wprod/fab-diy/cad/steel/preview.png

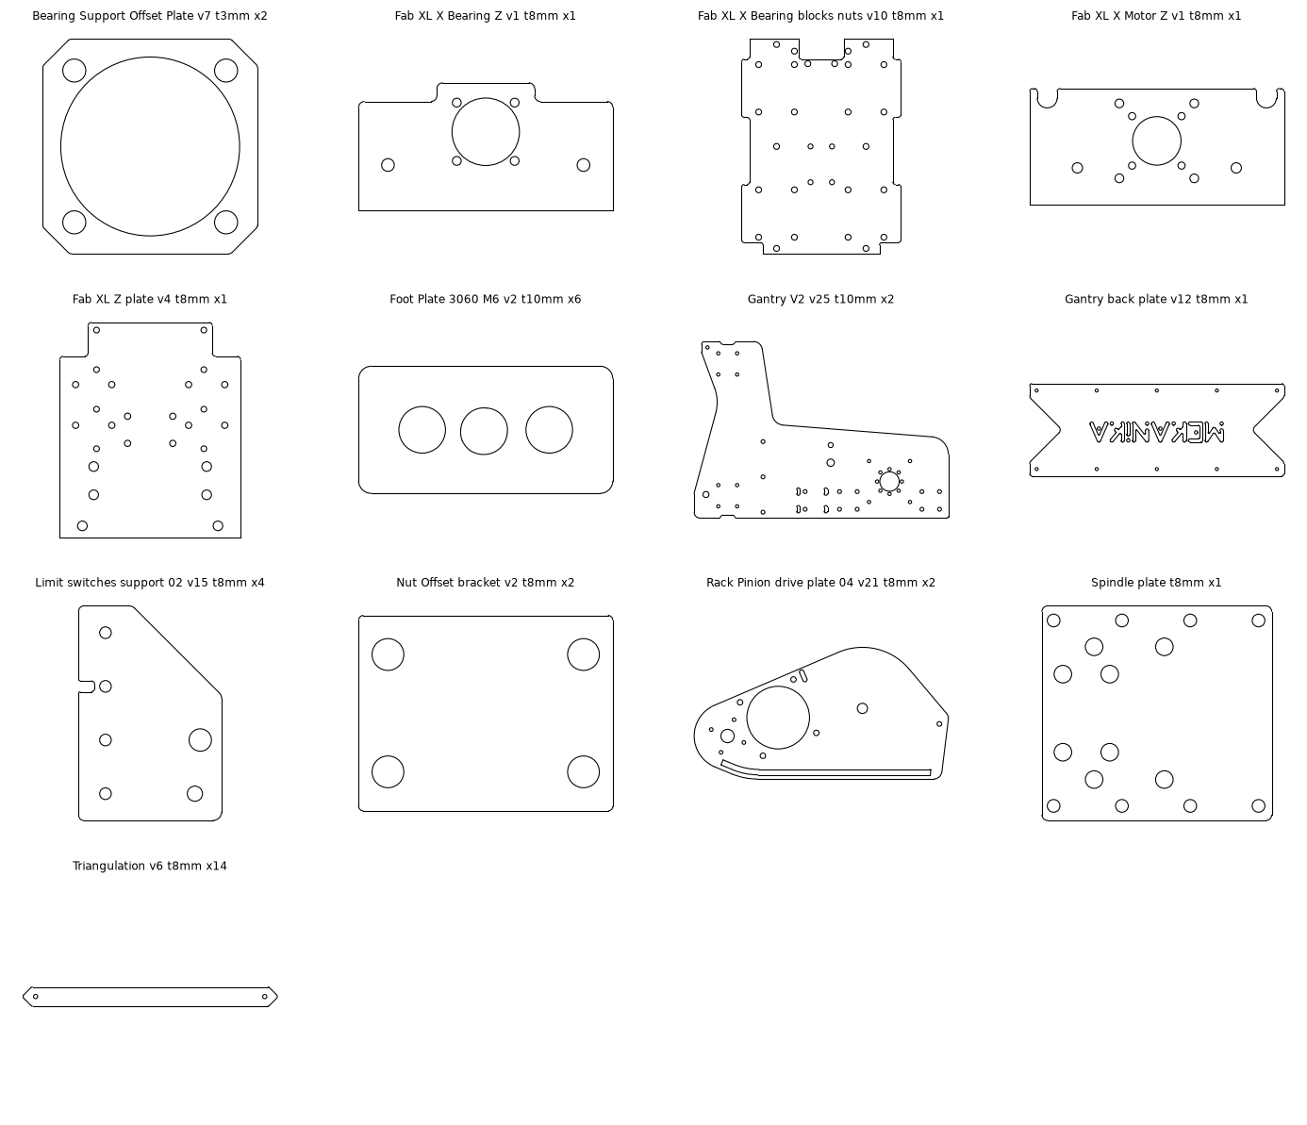
cad/steel/preview.png
