wprod/fab-diy/bom/commandes/README.md

# Listes de commande par fournisseur

Générées par `scripts/make_orders.py` à partir de [`fab-diy-bom.csv`](../fab-diy-bom.csv). Prix TTC France, port compris quand il est chiffré.

| Fournisseur | Articles | Total TTC | dont estimé | Liste |
|---|---:|---:|---:|---|
| Dold Mechatronik (aluprofile-express.de) | 14 | 1693 € | 109 € | [`dold-mechatronik-aluprofile-express-de.csv`](dold-mechatronik-aluprofile-express-de.csv) |
| DamenCNC (2 × 2 m) + Dold (2 × 1 m) | 1 | 1277 € | 0 € | [`damencnc-2-2-m-dold-2-1-m.csv`](damencnc-2-2-m-dold-2-1-m.csv) |
| Sorotec (Blue Line) | 6 | 857 € | 0 € | [`sorotec-blue-line.csv`](sorotec-blue-line.csv) |
| Découpe laser en ligne (Laserboost / Fractory / Xometry) - devis à faire | 16 | 562 € | 562 € | [`decoupe-laser-en-ligne-laserboost-fractory-xometry-devis-a-f.csv`](decoupe-laser-en-ligne-laserboost-fractory-xometry-devis-a-f.csv) |
| StepperOnline (entrepôt DE) | 4 | 452 € | 100 € | [`stepperonline-entrepot-de.csv`](stepperonline-entrepot-de.csv) |
| AliExpress | 22 | 275 € | 275 € | [`aliexpress.csv`](aliexpress.csv) |
| PlanetCNC (planet-cnc.com) | 3 | 240 € | 15 € | [`planetcnc-planet-cnc-com.csv`](planetcnc-planet-cnc-com.csv) |
| Reichelt (reichelt.com/be) | 30 | 181 € | 115 € | [`reichelt-reichelt-com-be.csv`](reichelt-reichelt-com-be.csv) |
| Dold Mechatronik | 8 | 162 € | 25 € | [`dold-mechatronik.csv`](dold-mechatronik.csv) |
| TME (tme.eu/fr, Pologne, UE) | 17 | 156 € | 45 € | [`tme-tme-eu-fr-pologne-ue.csv`](tme-tme-eu-fr-pologne-ue.csv) |
| Motedis (motedis.fr) | 27 | 155 € | 17 € | [`motedis-motedis-fr.csv`](motedis-motedis-fr.csv) |
| Achat local (bricolage / grossiste électrique) | 6 | 146 € | 146 € | [`achat-local-bricolage-grossiste-electrique.csv`](achat-local-bricolage-grossiste-electrique.csv) |
| Reichelt / RS / Conrad | 5 | 143 € | 143 € | [`reichelt-rs-conrad.csv`](reichelt-rs-conrad.csv) |
| Dold Mechatronik (pignon) + AliExpress (poulie) + atelier d'usinage local | 1 | 138 € | 138 € | [`dold-mechatronik-pignon-aliexpress-poulie-atelier-d-usinage-.csv`](dold-mechatronik-pignon-aliexpress-poulie-atelier-d-usinage-.csv) |
| AliExpress (vendeur entrepôt UE si dispo) | 8 | 127 € | 127 € | [`aliexpress-vendeur-entrepot-ue-si-dispo.csv`](aliexpress-vendeur-entrepot-ue-si-dispo.csv) |
| DamenCNC (Pays-Bas) | 1 | 126 € | 126 € | [`damencnc-pays-bas.csv`](damencnc-pays-bas.csv) |
| Motedis | 4 | 100 € | 0 € | [`motedis.csv`](motedis.csv) |
| Leroy Merlin (retrait en magasin) | 1 | 100 € | 100 € | [`leroy-merlin-retrait-en-magasin.csv`](leroy-merlin-retrait-en-magasin.csv) |
| Dold Mechatronik + atelier local | 1 | 59 € | 59 € | [`dold-mechatronik-atelier-local.csv`](dold-mechatronik-atelier-local.csv) |
| Audiophonics (Bordeaux) | 2 | 47 € | 7 € | [`audiophonics-bordeaux.csv`](audiophonics-bordeaux.csv) |
| Quincaillerie / négoce (Rampa SKD acier ou équivalent) | 1 | 35 € | 35 € | [`quincaillerie-negoce-rampa-skd-acier-ou-equivalent.csv`](quincaillerie-negoce-rampa-skd-acier-ou-equivalent.csv) |
| Sorotec | 1 | 30 € | 0 € | [`sorotec.csv`](sorotec.csv) |
| AliExpress / Amazon | 2 | 30 € | 30 € | [`aliexpress-amazon.csv`](aliexpress-amazon.csv) |
| Découpe laser (avec le lot acier) | 1 | 24 € | 24 € | [`decoupe-laser-avec-le-lot-acier.csv`](decoupe-laser-avec-le-lot-acier.csv) |
| Bits and Parts (bitsandparts.nl) | 2 | 19 € | 8 € | [`bits-and-parts-bitsandparts-nl.csv`](bits-and-parts-bitsandparts-nl.csv) |
| Reichelt / Conrad | 3 | 17 € | 17 € | [`reichelt-conrad.csv`](reichelt-conrad.csv) |
| Découpe laser bois/acrylique en ligne (Snijlab NL / Formulor DE) | 2 | 14 € | 14 € | [`decoupe-laser-bois-acrylique-en-ligne-snijlab-nl-formulor-de.csv`](decoupe-laser-bois-acrylique-en-ligne-snijlab-nl-formulor-de.csv) |
| Reichelt (reichelt.com/fr) | 1 | 12 € | 12 € | [`reichelt-reichelt-com-fr.csv`](reichelt-reichelt-com-fr.csv) |
| Amazon.fr (optionnel, décoratif) | 5 | 11 € | 11 € | [`amazon-fr-optionnel-decoratif.csv`](amazon-fr-optionnel-decoratif.csv) |
| JLCPCB | 2 | 10 € | 10 € | [`jlcpcb.csv`](jlcpcb.csv) |
| Reichelt / Kubii | 1 | 6 € | 6 € | [`reichelt-kubii.csv`](reichelt-kubii.csv) |
| Impression 3D maison (filament PETG) | 1 | 3 € | 3 € | [`impression-3d-maison-filament-petg.csv`](impression-3d-maison-filament-petg.csv) |
| **Total** | | **7205 €** | | |
