wprod/fab-diy/bom/fab-diy-bom.csv

categorie | ref_mekanika | designation | quantite | sourcing | fournisseur | produit | lien | prix_unitaire_ttc_eur | quantite_achat | total_ttc_eur | confiance | statut | notes
Pieces acier (a fabriquer) | M00278 | CNC Fab - Steel Parts - Cable chain holder | 4 | fabriquer (laser/pliage) | Découpe laser en ligne (Laserboost / Fractory / Xometry) - devis à faire | Pièce acier S235 découpée laser 3 mm + pliage | https://www.laserboost.com | 11.42 | 4 | 45.71 | estimation | chiffre | MÉTHODE ACIER (estimation, aucun devis réel) : coût HT par ligne = q x [kg x €/kg + m de découpe x €/m + (trous+1) x €/amorçage + 1 €/pièce de manutention + plis x 2 €] + frais fixes par épaisseur (15 € HT, répartis au prorata de la masse) + forfait réglage pliage (35 € HT, réparti au prorata du nombre de plis), puis x1,21. Hypothèses centrales : tôle S235 1,8 €/kg HT (8-10 mm) et 2,2 €/kg (1,5-3 mm) ; découpe 5 €/m (8 mm), 6 €/m (10 mm), 2 €/m (3 mm), 1,2 €/m (1,5 mm); amorçage 0,10 € (épais) / 0,05 € (mince). Fourchette : bas = 1,3 €/kg, 3,5-4 €/m, 1 €/pli (proche du tarif public Metal-M (Bulgarie) : 8-10 mm 8 lv/m soit ~4,1 €/m HT, <=1,5 mm ~0,84 €/m); haut = 2,5-3 €/kg, 7-8,5 €/m, 3,5 €/pli, 60 € de réglage. Repère haut : tôle 8 mm coupée sur mesure à 287,64 €/m² TTC chez metallshopper.de (~4,6 €/kg). Aucun tarif public Laserboost/Fractory/Xometry (devis sur fichier). Masses, longueurs de découpe et trous mesurés sur les DXF/STEP du dépôt (cad/steel). Total lot D (central) ~585 € TTC, fourchette 363-954 € hors port. Par épaisseur (périmètre complet) : 8 mm 28 pièces 300 (196-467), 10 mm 8 pièces 113 (71-182), 3 mm 61 (34-112), 1,5 mm 144 (82-247) € TTC (central, bas-haut). Le lot D chiffre 14 goussets et exclut la spindle plate 8 mm (hors nomenclature, ~10 €) et les 6 plaques de pied 10 mm (lot A, ~23 €). Cette ligne : 4 supports de chaîne 3 mm pliés, 1 pli chacun supposé. 3 mm, Cable_chain_support_02 (STEP, plié) ; 0,225 kg/u, 0,46 m de découpe/u, 2 trous/u, 1 pli(s)/u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
Pieces acier (a fabriquer) | M00279 | CNC Fab - Steel Parts - Control Unit Base | 1 | fabriquer (laser/pliage) | Découpe laser en ligne (Laserboost / Fractory / Xometry) - devis à faire | Pièce acier S235 découpée laser 1,5 mm + pliage | https://www.laserboost.com | 50.41 | 1 | 50.41 | estimation | chiffre | 1,5 mm, Fab_Control_Unit_Base (STEP, plié) ; 3,241 kg/u, 3,50 m de découpe/u, 40 trous/u, 6 pli(s)/u. Fourchette ligne 29-87 € TTC. Tôle brute: peinture/poudrage non compris (prévoir ~15-25 €/pièce si sous-traité). Longueur de découpe et plis estimés depuis le STEP.
Pieces acier (a fabriquer) | M00280 | CNC Fab - Steel Parts - Control Unit Cover | 1 | fabriquer (laser/pliage) | Découpe laser en ligne (Laserboost / Fractory / Xometry) - devis à faire | Pièce acier S235 découpée laser 1,5 mm + pliage | https://www.laserboost.com | 29.15 | 1 | 29.15 | estimation | chiffre | 1,5 mm, Fab_Control_Unit_Cover (STEP, plié) ; 3,268 kg/u, 2,40 m de découpe/u, 10 trous/u, 2 pli(s)/u. Fourchette ligne 17-50 € TTC. Tôle brute: peinture/poudrage non compris (prévoir ~15-25 €/pièce si sous-traité). Longueur de découpe et plis estimés depuis le STEP.
Pieces acier (a fabriquer) | M00281 | CNC Fab - Steel Parts - Gusset plate | 12 | fabriquer (laser/pliage) | Découpe laser en ligne (Laserboost / Fractory / Xometry) - devis à faire | Pièce acier S235 découpée laser 8 mm | https://www.laserboost.com | 8.77 | 14 | 122.72 | estimation | chiffre | 8 mm, Triangulation_v6 394x30 ; 0,721 kg/u, 0,86 m de découpe/u, 2 trous/u. Fourchette ligne 82-190 € TTC. Nomenclature : 12, STEP : 14 goussets ; chiffré sur 14 (2 de plus = ~18 €).
Pieces acier (a fabriquer) | M00282 | CNC Fab - Steel Parts - Limit sensor support plate | 4 | fabriquer (laser/pliage) | Découpe laser en ligne (Laserboost / Fractory / Xometry) - devis à faire | Pièce acier S235 découpée laser 8 mm | https://www.laserboost.com | 6.62 | 4 | 26.51 | estimation | chiffre | 8 mm, Limit_switches_support_02 80x120 ; 0,501 kg/u, 0,53 m de découpe/u, 6 trous/u. Fourchette ligne 17-43 € TTC.
Pieces acier (a fabriquer) | M00283 | CNC Fab - Steel Parts - R&P drive plate | 2 | fabriquer (laser/pliage) | Découpe laser en ligne (Laserboost / Fractory / Xometry) - devis à faire | Pièce acier S235 découpée laser 8 mm | https://www.laserboost.com | 18.78 | 2 | 37.56 | estimation | chiffre | 8 mm, Rack_Pinion_drive_plate 286x152 ; 1,857 kg/u, 1,80 m de découpe/u, 12 trous/u. Fourchette ligne 25-58 € TTC. Trous Ø4,3-5,5 < épaisseur : à faire pointer au laser puis percer/tarauder soi-même (ou supplément).
Pieces acier (a fabriquer) | M00284 | CNC Fab - Steel Parts - Y gantry | 2 | fabriquer (laser/pliage) | Découpe laser en ligne (Laserboost / Fractory / Xometry) - devis à faire | Pièce acier S235 découpée laser 10 mm | https://www.laserboost.com | 44.45 | 2 | 88.90 | estimation | chiffre | 10 mm, Gantry_V2 432x300 ; 5,837 kg/u, 2,36 m de découpe/u, 38 trous/u. Fourchette ligne 57-144 € TTC. Les 6 plaques de pied 10 mm (lot A) peuvent être ajoutées à la même commande pour ~23 € TTC.
Pieces acier (a fabriquer) | M00285 | CNC Fab - Steel Parts - Y gantry back plate | 1 | fabriquer (laser/pliage) | Découpe laser en ligne (Laserboost / Fractory / Xometry) - devis à faire | Pièce acier S235 découpée laser 8 mm | https://www.laserboost.com | 40.56 | 1 | 40.56 | estimation | chiffre | 8 mm, Gantry_back_plate 550x200 (10 trous + ~12 amorçages logo) ; 5,947 kg/u, 3,30 m de découpe/u, 22 trous/u. Fourchette ligne 27-62 € TTC. Contient le logo MEKANIKA découpé (à retirer si diffusion).
Pieces acier (a fabriquer) | M00354 | CNC Pro/Fab - Steel Parts - Nut Offset | 2 | fabriquer (laser/pliage) | Découpe laser en ligne (Laserboost / Fractory / Xometry) - devis à faire | Pièce acier S235 découpée laser 8 mm | https://www.laserboost.com | 3.73 | 2 | 7.46 | estimation | chiffre | 8 mm, Nut_Offset_bracket 52x40 ; 0,122 kg/u, 0,26 m de découpe/u, 4 trous/u. Fourchette ligne 5-13 € TTC.
Pieces acier (a fabriquer) | M00355 | CNC Pro/Fab - Steel Parts - VFD Base | 1 | fabriquer (laser/pliage) | — | Reporté : pas de boîtier VFD tant que la Makita sert de broche |  | 0.00 | 0 | 0.00 | estimation | chiffre | Le relais et la prise de la Makita sont dans le boîtier de commande. À découper le jour où la broche 2,2 kW et son variateur remplacent l'affleureuse (~39 € estimés).
Pieces acier (a fabriquer) | M00356 | CNC Pro/Fab - Steel Parts - VFD Cover | 1 | fabriquer (laser/pliage) | — | Reporté : pas de boîtier VFD tant que la Makita sert de broche |  | 0.00 | 0 | 0.00 | estimation | chiffre | Voir VFD Base (~24 € estimés).
Pieces acier (a fabriquer) | M00360 | CNC Pro/Fab - Steel Parts - X Nut | 1 | fabriquer (laser/pliage) | Découpe laser en ligne (Laserboost / Fractory / Xometry) - devis à faire | Pièce acier S235 découpée laser 8 mm | https://www.laserboost.com | 20.67 | 1 | 20.67 | estimation | chiffre | 8 mm, Fab_XL_X_Bearing_blocks_nuts 178x240 (correspondance probable) ; 2,404 kg/u, 1,49 m de découpe/u, 30 trous/u. Fourchette ligne 13-33 € TTC.
Pieces acier (a fabriquer) | M00361 | CNC Pro/Fab - Steel Parts - Z Plate | 1 | fabriquer (laser/pliage) | Découpe laser en ligne (Laserboost / Fractory / Xometry) - devis à faire | Pièce acier S235 découpée laser 8 mm | https://www.laserboost.com | 16.53 | 1 | 16.53 | estimation | chiffre | 8 mm, Fab_XL_Z_plate 160x190 (correspondance probable) ; 1,765 kg/u, 1,19 m de découpe/u, 26 trous/u. Fourchette ligne 11-27 € TTC. Trous Ø4,3-5,5 < épaisseur : à faire pointer au laser puis percer/tarauder soi-même (ou supplément).
Pieces acier (a fabriquer) | M00358 | CNC Pro/Fab - Steel Parts - Z-Axis Bottom Bearing Plate | 1 | fabriquer (laser/pliage) | Découpe laser en ligne (Laserboost / Fractory / Xometry) - devis à faire | Pièce acier S235 découpée laser 8 mm | https://www.laserboost.com | 6.86 | 1 | 6.86 | estimation | chiffre | 8 mm, Fab_XL_X_Bearing_Z 130x65 ; 0,416 kg/u, 0,59 m de découpe/u, 7 trous/u. Fourchette ligne 4-11 € TTC. Trous Ø4,3-5,5 < épaisseur : à faire pointer au laser puis percer/tarauder soi-même (ou supplément).
Pieces acier (a fabriquer) | M00359 | CNC Pro/Fab - Steel Parts - Z-axis Top Motor Plate | 1 | fabriquer (laser/pliage) | Découpe laser en ligne (Laserboost / Fractory / Xometry) - devis à faire | Pièce acier S235 découpée laser 8 mm | https://www.laserboost.com | 9.05 | 1 | 9.05 | estimation | chiffre | 8 mm, Fab_XL_X_Motor_Z 160x73 ; 0,656 kg/u, 0,76 m de découpe/u, 11 trous/u. Fourchette ligne 6-15 € TTC. Trous Ø4,3-5,5 < épaisseur : à faire pointer au laser puis percer/tarauder soi-même (ou supplément).
Pieces acier (a fabriquer) | M00364 | CNC Pro/Fab - Steels Parts - Bearing Support Offset Plate | 2 | fabriquer (laser/pliage) | Découpe laser en ligne (Laserboost / Fractory / Xometry) - devis à faire | Pièce acier S235 découpée laser 3 mm | https://www.laserboost.com | 2.65 | 2 | 5.30 | estimation | chiffre | 3 mm, Bearing_Support_Offset_Plate 42x42 ; 0,016 kg/u, 0,32 m de découpe/u, 5 trous/u. Fourchette ligne 3-10 € TTC.
Pieces acier (a fabriquer) | M01379 | CU-VFD-Mounting plate 3mm | 4 | fabriquer (laser/pliage) | — | Facultatif : le boîtier se pose à plat sur les deux traverses basses avant |  | 0.00 | 0 | 0.00 | estimation | chiffre | Le guide officiel décrit deux montages. L'ancien, qui correspond au modèle 3D de ce dépôt, pose le boîtier à plat sur les deux traverses basses avant, sans patte. Le nouveau (machines livrées depuis mars 2026) le suspend à la verticale sur 4 pattes à encoche, dont la géométrie n'est pas publiée. Une patte de blocage facultative est dessinée dans cad/steel/diy (~10 € les 4). Voir docs/pieces-acier.md.
Pieces acier (a fabriquer) |  | Spindle plate 8 mm (plaque porte-broche) | 1 | fabriquer (laser/pliage) | Découpe laser en ligne (Laserboost / Fractory / Xometry) - devis à faire | Plaque acier 8 mm 118x110, 16 trous |  | 9.92 | 1 | 9.92 | estimation | chiffre | Hors BOM upstream (vendue avec la broche). DXF : cad/steel/fab/dxf/Spindle_plate_t8mm_x1.dxf; Ajoutée après coup : même méthode que les autres plaques 8 mm (~0,76 kg, 0,84 m de découpe), estimation du lot D.
Gabarits de montage | M00966 | CNC Fab - Mounting gauge MDF (Frame) | 2 | fabriquer (decoupe) | — | À couper soi-même : 2 barres de MDF 18 mm, 322,5 mm de long (chute du martyr) |  | 0.00 | 0 | 0.00 | estimation | chiffre | Vu dans le guide officiel : une barre qui cale l'écart entre deux traverses de table. Écart mesuré dans le STEP : 322,5 mm, identique partout. L'épaisseur de 18 mm sert aussi de cale pour aligner la poulie moteur. Voir docs/notes-de-montage.md.
Gabarits de montage | M00967 | CNC Fab - Mounting gauge Plywood (Rails) | 1 | fabriquer (decoupe) | — | Remplacé par une mesure : dessus du rail à 35,0 mm sous le dessus du profilé 30×120 |  | 0.00 | 0 | 0.00 | estimation | chiffre | Le gabarit officiel se glisse sous le rail pendant le serrage ; sa géométrie n'est pas publiée. Cote relevée dans le STEP. Une cale de 35 mm ou la jauge de profondeur d'un pied à coulisse fait le même travail. Voir docs/notes-de-montage.md.
Gabarits de montage | M00716 | PMMA Sheet 3mm 600x400mm, Light Blue | 0.02 | fabriquer (decoupe) | Découpe laser bois/acrylique en ligne (Snijlab NL / Formulor DE) | Gabarit PMMA 3 mm bleu clair 60x60 mm (DXF 'FAB Mounting Gauge.dxf') | https://www.snijlab.nl | 3.97 | 1 | 3.97 | estimation | chiffre | 0,02 plaque 600x400 = pièce de 60x60 mm (~0,4 m de découpe, DXF dans upstream/fab/cad). Estimation avec minimum par pièce. Option matière seule : chute PMMA 3 mm ~1-2 € (plaque entière 600x400 ~13 €, soit 0,26 € au prorata).
Impression 3D | M01551 | SPT - Cable Holder 3d Print | 18 | imprimer 3D | Impression 3D maison (filament PETG) | Clip porte-câbles pour rainure 6 mm, PETG ~4 g/pièce | https://www.3djake.fr/prusa/prusament-petg-shimmering-violet-nfc | 0.14 | 18 | 2.59 | estimation | chiffre | Coût matière seul: ~4 g + 10 % de pertes par clip, PETG à 32,99 €/kg TTC (Prusament, 3djake.fr; PETG générique ~20 €/kg). Masse supposée : le STEP du clip est un pointeur Git LFS non téléchargé. Sans imprimante: service en ligne (Craftcloud, JLC3DP...) ~20-30 € port compris; sans filament: bobine 1 kg ~20-33 €.
Structure alu | M00058 | Alu profile I-30120 (1530mm) [4x M6 threads on ONE side] | 4 | acheter (coupe + taraudage) | Dold Mechatronik (aluprofile-express.de) | Aluminiumprofil 30x120L I-Typ Nut 6, Zuschnitt 1530 mm + 4x M6 Gewinde côté 1 (art. 63047-Z) | https://www.aluprofile-express.de/Aluminiumprofil-30x120L-Nut-6-leicht-316kg-m-Zuschnitt-50-6000mm | 71.61 | 4 | 286.45 | vérifié | chiffre | 42,00 €/m + 2,00 € coupe + 4,76 € taraudage 4xM6 (un côté) = 71.02 € TTC DE/pièce. Prix Dold affiché TTC DE 19 %, converti en TTC BE 21 % (x1,21/1,19). Rainure 6 OK. 3,157 kg/m.
Structure alu | M00059 | Alu profile I-6030 (1410mm) | 9 | acheter (coupe + taraudage) | Dold Mechatronik (aluprofile-express.de) | Aluminiumprofil 30x60L I-Typ Nut 6, Zuschnitt 1410 mm (art. 63016-Z) | https://www.aluprofile-express.de/Aluminiumprofil-30x60L-I-Typ-Nut-6-leicht-168kg-m-Zuschnitt-50-6000mm | 30.86 | 11 | 339.49 | vérifié | chiffre | 21,00 €/m + 1,00 € coupe = 30.61 € TTC DE/pièce. Prix Dold affiché TTC DE 19 %, converti en TTC BE 21 % (x1,21/1,19). Motedis affiche 16,89 €/m TTC BE (moins cher sur ce profil seul, mais coupe/taraudage/port non chiffrables). QUANTITÉ : 11 et non 9. Le STEP en contient 11 (4 longerons bas, 3 traverses basses, 4 traverses de table), la nomenclature officielle 9. Voir docs/verifications.md, section 5.
Structure alu | M00930 | Alu Profile I-6030 (600mm) [2x M6 threads on BOTH sides] | 6 | acheter (coupe + taraudage) | Dold Mechatronik (aluprofile-express.de) | Aluminiumprofil 30x60L I-Typ Nut 6, Zuschnitt 600 mm + 2x M6 Gewinde des deux côtés (art. 63016-Z) | https://www.aluprofile-express.de/Aluminiumprofil-30x60L-I-Typ-Nut-6-leicht-168kg-m-Zuschnitt-50-6000mm | 19.42 | 6 | 116.51 | vérifié | chiffre | 12,60 € + 1,00 € coupe + 2x2,83 € taraudage 2xM6 = 19.26 € TTC DE/pièce. Prix Dold affiché TTC DE 19 %, converti en TTC BE 21 % (x1,21/1,19).
Structure alu | M00060 | Alu profile I-6060 (1410mm) | 6 | acheter (coupe + taraudage) | Dold Mechatronik (aluprofile-express.de) | Aluminiumprofil 60x60L I-Typ Nut 6, Zuschnitt 1410 mm (art. 63023-Z) | https://www.aluprofile-express.de/Aluminiumprofil-60x60L-I-Typ-Nut-6-leicht-274kg-m-Zuschnitt-50-6000mm | 51.78 | 6 | 310.67 | vérifié | chiffre | 35,00 €/m + 2,00 € coupe = 51.35 € TTC DE/pièce. Prix Dold affiché TTC DE 19 %, converti en TTC BE 21 % (x1,21/1,19). RAINURE 6 et non 8 : mesuré dans le STEP officiel (goulot 6,2 mm, chambre 16,3 mm, identique au 30x60).
Structure alu | M00061 | Alu profile I-6060 (1530mm) [4x M6 threads on BOTH sides] | 2 | acheter (coupe + taraudage) | Dold Mechatronik (aluprofile-express.de) | Aluminiumprofil 60x60L I-Typ Nut 6, Zuschnitt 1530 mm + 4x M6 Gewinde des deux côtés (art. 63023-Z) | https://www.aluprofile-express.de/Aluminiumprofil-60x60L-I-Typ-Nut-6-leicht-274kg-m-Zuschnitt-50-6000mm | 65.61 | 2 | 131.23 | vérifié | chiffre | 53,55 € + 2,00 € coupe + 2x4,76 € taraudage 4xM6 = 65.07 € TTC DE/pièce. Prix Dold affiché TTC DE 19 %, converti en TTC BE 21 % (x1,21/1,19). Rainure 6 (mesure STEP). Le STEP montre un chanfrein 45° de 1,5 mm en entrée de rainure (style V-slot) absent du profilé standard.
Structure alu | M00055 | Alu Profile V-3030 (240mm) [1x M6 thread on BOTH sides] | 2 | acheter (coupe + taraudage) | Dold Mechatronik (aluprofile-express.de) | Aluminiumprofil 30x30L I-Typ Nut 6, Zuschnitt 240 mm + 1x M6 Gewinde des deux côtés (art. 63009-Z) | https://www.aluprofile-express.de/Aluminiumprofil-30x30L-I-Typ-Nut-6-leicht-094kg-m-Zuschnitt-50-6000mm | 6.27 | 2 | 12.55 | vérifié | chiffre | 2,88 € + 0,50 € coupe + 2x1,42 € taraudage M6 = 6.22 € TTC DE/pièce. Prix Dold affiché TTC DE 19 %, converti en TTC BE 21 % (x1,21/1,19). Profil « V » du STEP = rainure 6 avec chanfrein 45° 1,5 mm ; ici profilé I standard (sert de support de rail, aucune roue n'y roule).
Moteurs & electronique | M00004 | 220V Inverter | 1 | acheter | AliExpress | VFD Huanyang 2,2 kW 220 V monophasé (dans le kit broche) | https://fr.aliexpress.com/item/1005009921208340.html | 0.00 | 1 | 0.00 | estimation | chiffre | Inclus dans le kit (prix sur la ligne Broche 2,2 kW)
Moteurs & electronique | M00010 | 5V Relay Module, 1 Channel | 1 | acheter | AliExpress | Module relais 5 V 1 canal (SRD-05VDC, optocouplé) | https://www.aliexpress.com/w/wholesale-5v-relay-module-1-channel.html | 1.49 | 1 | 1.49 | estimation | chiffre | Petite pièce, estimation
Moteurs & electronique | M00074 | Axial Fan 24V 92x92mm, panel mount | 1 | acheter | Reichelt (reichelt.com/be) | SUN MF92252V2-1, ventilateur axial 92×92×25 mm 24 V CC, 76,4 m³/h | https://www.reichelt.com/be/fr/shop/produit/ventilateur_axial_92_x_92_x_25_mm_24_v_76_4_m3_h_32_dba-260692 | 3.83 | 1 | 3.83 | vérifié | chiffre | Prix TTC (TVA 21 %) affiché sur reichelt.com/be
Moteurs & electronique | M00368 | CNC USB Controller license | 1 | acheter | PlanetCNC (planet-cnc.com) | PlanetCNC controller license (logiciels TNG + CNCUSB) | https://shop.planet-cnc.com/product/planetcnc-controller-license/ | 82.80 | 1 | 82.80 | vérifié | chiffre | 69,00 € HT affiché, ×1,21. Licence NON incluse avec la carte : sans licence la carte est limitée à 25 mouvements
Moteurs & electronique | M00367 | CNC USB Controller Mk3/4 | 1 | acheter | PlanetCNC (planet-cnc.com) | CNC controller Mk3/4 (4 axes) | https://shop.planet-cnc.com/product/cnc-controller-mk34/ | 142.80 | 1 | 142.80 | vérifié | chiffre | 119,00 € HT affiché, ×1,21. Licence vendue à part (ligne M00368)
Moteurs & electronique | M00515 | Fan cover 92mm | 1 | acheter | Reichelt (reichelt.com/be) | Grille de protection métallique pour ventilateur 92 mm | https://www.reichelt.com/be/fr/shop/recherche/grille%20ventilateur%2092 | 1.19 | 1 | 1.19 | estimation | chiffre | Petite pièce, estimation
Moteurs & electronique | M00663 | MicroSD 32GB Samsung Evo+ | 1 | acheter | Reichelt (reichelt.com/be) | SanDisk Ultra microSDHC 32 Go A1 (SDSQUA4032GGN6MA) | https://www.reichelt.com/be/fr/shop/produit/carte_memoire_microsdhc_32_go_sandisk_ultra-297179 | 18.89 | 1 | 18.89 | vérifié | chiffre | Samsung EVO Plus non référencé chez Reichelt BE : équivalent classe A1
Moteurs & electronique | M00688 | Motor Driver 2DM860H - FAB | 4 | acheter | — | Inutile : drivers inclus dans les kits en boucle fermée |  | 0.00 | 0 | 0.00 | vérifié | chiffre | Les kits CL86T (X/Y) et CL57T (Z) ont chacun leur driver.
Moteurs & electronique | M00697 | Nema23 Stepper Motor 5A 6.35mm Shaft | 1 | acheter | StepperOnline (entrepôt DE) | Kit boucle fermée 1-CL57T-S30A-V41 : NEMA 23 3,0 N·m 23HS45-4204D-E1000 + driver CL57T V4.1 | https://www.omc-stepperonline.com/fr/ | 70.57 | 1 | 70.57 | vérifié | chiffre | Moteur neuf : la XE-PRO garde le sien. 58,55 € + 12,02 € « stock local » DE, mis au panier le 08/11/2026. Arbre Ø8 mm à méplat, comme le 23HS39 prévu. Seulement 2 en stock DE : commander vite ou passer par l'entrepôt Chine. Le driver CL57T accepte 24-48 V CC seulement (aucun driver NEMA 23 en boucle fermée de StepperOnline ne tient 72 V) : alimentation 48 V séparée ci-dessous.
Moteurs & electronique | M00699 | Nema34 Stepper Motor 6A 12.7mm Shaft | 3 | acheter | StepperOnline (entrepôt DE) | Kit boucle fermée 1-CL86T-S90-V41 : NEMA 34 9,0 N·m 34HS46-6004D-E1000 (codeur 1000 ppr) + driver CL86T V4.1 | https://www.omc-stepperonline.com/fr/kit-cnc-pas-a-pas-a-boucle-fermee-1-axe-serie-ts-9-nm-1274-76oz-in-nema-34-moteur-et-pilote-1-cl86t-s90-v41 | 93.78 | 3 | 281.34 | vérifié | chiffre | Mis au panier le 08/11/2026, destination France, entrepôt DE : 76,92 € + 16,86 € de supplément « stock local » par kit. Aucune ligne de TVA ajoutée au panier (le site annonce « pas de taxes supplémentaires » depuis l'UE) : TTC probable, à confirmer au paiement. 9 N·m au lieu de 8,2 N·m : pas de perte de couple. Arbre Ø14 mm claveté, 37 mm, comme le moteur précédent : poulies et accouplements inchangés. Driver CL86T : 24-110 V CC, donc l'alimentation 72 V reste. 14 en stock DE.
Moteurs & electronique | M00712 | Optocoupler 4 channels | 1 | acheter | AliExpress | Module optocoupleur 4 canaux PC817, version à entrées 24 V | https://www.aliexpress.com/w/wholesale-pc817-4-channel-optocoupler-module.html | 1.79 | 1 | 1.79 | estimation | chiffre | Petite pièce, estimation. Prendre la version à entrées 24 V : la version 3,3/5 V n'est pas faite pour du 24 V.
Moteurs & electronique | M00714 | PCB Custom for CNC Limit Switches | 1 | acheter | JLCPCB | 5 PCB 2 couches ≤ 100×100 mm, 1,6 mm, HASL (sans composants) | https://jlcpcb.com/ | 2.28 | 1 | 2.28 | estimation | chiffre | Environ 2 $ HT le lot de 5, ×1,21 ; port sur la ligne PORT JLCPCB. Gerber prêts : cad/pcb-fins-de-course/fab-fins-de-course-gerber.zip (99,5 × 51 mm, 2 couches).
Moteurs & electronique | M00718 | PWM to Analog Voltage Converter 0-10V | 1 | acheter | — | Inutile avec la Makita |  | 0.00 | 0 | 0.00 | vérifié | chiffre | Sert à piloter la vitesse du VFD : inutile avec la Makita (molette).
Moteurs & electronique | M00739 | Raspberry Pi 4B 2G | 1 | acheter | Déjà possédé | Raspberry Pi 5 16 Go (déjà possédé) |  | 0.00 | 0 | 0.00 | vérifié | chiffre | Remplace le Pi 4. PlanetCNC TNGv2 a une version « RaspberryPi 5 (64bit) » (page de téléchargement, version du 2026-08-12). Mêmes trous de fixation 58×49 mm ; ports Ethernet/USB inversés par rapport au Pi 4, sans conséquence avec les rallonges de façade.
Moteurs & electronique | M00790 | Screw 2 Way PCB Terminal Block 5mm Pitch | 1 | acheter | Reichelt (reichelt.com/be) | Bornier à vis 2 pôles pas 5,08 mm pour CI | https://www.reichelt.com/be/fr/shop/recherche/AKL%20101-02 | 0.35 | 1 | 0.35 | estimation | chiffre | Petite pièce, estimation
Moteurs & electronique | M00791 | Screwless 4 Way PCB Terminal Block 3.5mm Pitch | 1 | acheter | Reichelt (reichelt.com/be) | Bornier à ressort (sans vis) 4 pôles pas 3,5 mm pour CI | https://www.reichelt.com/be/fr/shop/recherche/bornier%203,5%204 | 1.19 | 1 | 1.19 | estimation | chiffre | Petite pièce, estimation
Moteurs & electronique | M00748 | SMPS 1500W 72V 20A (CNC Fab) | 1 | acheter | AliExpress | Alimentation à découpage 72 V 1500 W (20–25 A), entrée 110/220 V, sortie ajustable | https://www.aliexpress.com/w/wholesale-72v-1500w-power-supply.html | 80.72 | 1 | 80.72 | estimation | chiffre | Prix relevé sur la page de résultats AliExpress (fr) le 08/11/2026, TVA UE supposée incluse. Alternative UE vérifiée : Ampul AM1818 72 V 20,8 A 1500 W à 321,54 € TTC, https://ampul.eu/en/switched-power-supply/5872-power-supply-72v-208a-1500w
Moteurs & electronique | M00931 | SMPS 60W 24V 2.8A (CNC Pro/Fab) | 1 | acheter | Reichelt (reichelt.com/be) | Mean Well LRS-75-24 (24 V 3,2 A, 76,8 W) | https://www.reichelt.com/be/fr/shop/produit/bloc_d_alimentation_a_decoupage_ferme_76_8_w_24_v_3_2_a-202969 | 15.87 | 1 | 15.87 | vérifié | chiffre | Remplace le 60 W 24 V 2,8 A (marge de puissance). TTC, écotaxe incluse
Moteurs & electronique | M00848 | USB Key 2Gb | 1 | acheter | Reichelt (reichelt.com/be) | Clé USB 8 Go (plus petite capacité courante) | https://www.reichelt.com/be/fr/shop/recherche/cl%C3%A9%20USB%208%20Go | 5.45 | 1 | 5.45 | estimation | chiffre | Les clés de 2 Go ne se vendent plus
Moteurs & electronique | M00853 | USB-C 24V to 5V 3A converter | 1 | acheter | AliExpress / Amazon | Convertisseur abaisseur 12/24 V → 5 V 5 A sortie USB-C |  | 9.92 | 1 | 9.92 | estimation | chiffre | Le Pi 5 veut 5 V 5 A. Avec 3 A il démarre mais limite l'USB à 600 mA au total. Avec un module 5 A sans négociation PD, ajouter usb_max_current_enable=1 dans /boot/firmware/config.txt.
Moteurs & electronique | M00917 | XLR 3 pole female panel, vertical PCB | 6 | acheter | Reichelt (reichelt.com/be) | Neutrik NC3FAV, embase XLR 3 femelle, CI vertical, SANS contact de masse (NC3FAV2 convient aussi) | https://www.reichelt.com/be/fr/shop/recherche/XLR%203%20femelle | 4.76 | 6 | 28.56 | estimation | chiffre | Petite pièce, estimation (prix Neutrik habituel). PAS de NC3FAV1 ni NC3FAV1-0 : ces variantes relient la broche 1 au châssis, or la broche 1 porte le signal du capteur. Voir docs/carte-fins-de-course.md.
Guidage & transmission | M00078 | Ball Bearing 6301-2RS 12x37x12mm | 2 | acheter | Dold Mechatronik | Rillenkugellager 6301 2RS 12x37x12 mm | https://www.dold-mechatronik.de/Rillenkugellager-6301-2RS-12x37x12-mm | 1.49 | 2 | 2.98 | vérifié | chiffre | Prix lu TTC 19 % TVA DE (1.48 €), recalculé à 21 % TVA BE (vente à distance UE). Roulement générique, délai 8 à 9 jours ouvrés.
Guidage & transmission | M00080 | Ballscrew SFS1620 1500mm & nut | 1 | acheter | AliExpress (vendeur entrepôt UE si dispo) | Vis à billes roulée C7 SFS1620, longueur 1500 mm sur mesure, extrémités usinées standard BK/FK12, avec écrou | https://fr.aliexpress.com/item/1005012349041890.html | 64.46 | 1 | 64.46 | estimation | chiffre | Estimation : les pages produit AliExpress n'affichent pas le prix par variante. Une SFS1620 de 1500 mm usinée avec écrou se vend en général 55 à 75 € ; plusieurs annonces plafonnent à 1450 mm, donc vérifier que 1500 mm est proposé. Pas de kit retenu : les kits vis + paliers sont presque toujours livrés en BK12/BF12 (paliers à semelle), alors que le plan demande des FK12/FF12 à bride. L'usinage standard est le même pour BK12 et FK12 (Ø12 h, filetage M12x1, côté libre Ø10). Les FK12/FF12 et le boîtier 16H sont donc pris chez Dold (lignes M00511, M00512, M00704). Dold n'a pas d'équivalent compatible : sa SFS1620-DM 1542 mm (159 €) a un usinage « DM » prévu pour ses paliers 3200/6200 Ø10, non compatible FK12, et une longueur différente.
Guidage & transmission | M00081 | Ballscrew SFU1605 250mm & Nut | 1 | acheter | AliExpress (vendeur entrepôt UE si dispo) | Vis à billes roulée C7 SFU1605, longueur 250 mm sur mesure, extrémités usinées standard BK/FK12, avec écrou | https://fr.aliexpress.com/item/1005012349041890.html | 21.82 | 1 | 21.82 | estimation | chiffre | Estimation : une SFU1605 courte, usinée avec écrou, coûte en général 17 à 25 € (prix d'appel des annonces à partir de 17 €). Chez Dold, l'option fiable la plus proche est la SFU1605-3 de 265 mm (59,50 € TTC DE, écrou compris, usinage standard), mais elle fait 15 mm de trop pour l'entraxe FK12/FF12 de l'axe Z.
Guidage & transmission | M00084 | Belt HTD-5M 15mm 475mm / 95 teeth | 2 | acheter | Dold Mechatronik | Zahnriemen geschlossen HTD-5M, largeur 15 mm, 475 mm / 95 dents (HTD-5M-15-475/95) | https://www.dold-mechatronik.de/Toothed-belt-HTD-5M-closed,-width-15mm,-length-selectable | 7.26 | 2 | 14.52 | vérifié | chiffre | Prix lu TTC 19 % TVA DE (7.20 €), recalculé à 21 % TVA BE (vente à distance UE). Prix dégressif à partir de 2 pièces (8,00 € à l'unité). Néoprène, armature fibre de verre. Choisir la variante 475 mm / 95 dents (article HTD-5M-15-475/95). Équivalent de marque : Contitech 475-5M-15 chez RS Belgique, 15,09 € TTC.
Guidage & transmission | M00947 | Brush FBL0706 20mm (m) | 0.5 | acheter | Achat local (bricolage / grossiste électrique) | Bande brosse à talon alu, poils 20 mm, au mètre (bas de porte à brosse ou brossier) |  | 8.83 | 1 | 8.83 | estimation | chiffre | Réf. FBL0706 introuvable ; ~9 €/m constaté pour une bande brosse 1 m (annonce eBay.de type 5). Vendue au mètre : 1 m pour 0,5 m utile.
Guidage & transmission | M00948 | Brush FBL0706 30mm (m) | 6 | acheter | Achat local (bricolage / grossiste électrique) | Bande brosse à talon alu, poils 30 mm, au mètre |  | 9.82 | 6 | 58.91 | estimation | chiffre | Réf. FBL0706 introuvable ; prix moyen estimé d'une bande brosse alu 30 mm (8,90-12 €/m). 4 tronçons de 1,5 m.
Guidage & transmission | M00411 | Compression Spring 14.5x9.6x1.6mm | 2 | acheter | AliExpress (vendeur entrepôt UE si dispo) | Ressorts de compression fil 1,6 mm, Ø ext. ≈ 9,6 mm, longueur libre ≈ 14,5 mm (lot) | https://fr.aliexpress.com/w/wholesale-ressort-compression-1.6mm.html | 4.96 | 1 | 4.96 | estimation | chiffre | Estimation : introuvable à l'unité dans ces cotes exactes chez Dold, Motedis ou dans le catalogue standard Gutekunst. Un lot de ressorts en fil de 1,6 mm coûte environ 5 € ; sinon Gutekunst Federn fait du sur mesure.
Guidage & transmission | M01685 | FAB - Pinion v2 - 2M Z15 80T | 2 | acheter | Dold Mechatronik (pignon) + AliExpress (poulie) + atelier d'usinage local | Pignon M2 Z15 C45 largeur 20 (Dold GG-416-020-0015) + poulie HTD-5M 80 dents type AF alésage 12, assemblés | https://www.dold-mechatronik.de/Spur-gear-M2-Z15-tooth-width20 | 68.93 | 2 | 137.85 | estimation | chiffre | Détail par ensemble : pignon Dold 6,50 € (vérifié, 6,39 € TTC DE à partir de 2 pièces, recalculé à 21 %) + poulie 80T HTD-5M ≈ 28 € (estimation : annonces AliExpress 72/80T entre 24 et 34 €, ex. https://fr.aliexpress.com/item/1005006230877395.html) + usinage ≈ 35 € (estimation). Pourquoi ce choix : aucun pignon-poulie M2 Z15 + 80T n'existe tout fait chez Dold, DamenCNC ou Mädler, et le diamètre primitif de 30 mm du Z15 M2 garde l'entraxe pignon/crémaillère du plan. Usinage : aléser la poulie à Ø21 H7 pour les 2 roulements 6801-ZZ (M01684), puis emmancher et coller le moyeu Ø24 du pignon (alésage repris à Ø13, libre sur l'axe fixe Ø12) dans un lamage de la poulie, goupillé. Si le support le permet, on peut aussi monter pignon et poulie sur un arbre Ø12 tournant, avec clavette ou vis. Le pignon C45 n'est pas trempé et s'usera avant la crémaillère trempée : c'est une pièce d'usure, ou on peut le faire tremper par induction. À valider sur les plans Mekanika.
Guidage & transmission | M01684 | FAB- Pinion v2 - Ball Bearing 6801-ZZ - 12x21x5mm | 2 | acheter | Dold Mechatronik | Rillenkugellager 6801 / 61801 ZZ 12x21x5 mm | https://www.dold-mechatronik.de/Rillenkugellager-6801-ZZ-12x21x5-mm | 1.44 | 2 | 2.88 | vérifié | chiffre | Prix lu TTC 19 % TVA DE (1.43 €), recalculé à 21 % TVA BE (vente à distance UE). Roulement générique en acier à roulement. Il existe en SKF/FAG si on veut une marque.
Guidage & transmission | M00511 | FF12 Bearing Support | 6 | acheter | Sorotec (Blue Line) | Palier libre à bride FF12 Blue Line (roulement 6000ZZ) | https://www.sorotec.de/shop/CNC-Mechanics/linear-technology/ball-screw-spindle/sorotec-blue-line/ | 12.00 | 6 | 72.00 | vérifié | chiffre | 11,90 € TTC DE, recalculé à 21 %. Même colis que les rails.
Guidage & transmission | M00512 | FK12 Bearing Support | 2 | acheter | Sorotec (Blue Line) | Palier fixe à bride FK12 Blue Line | https://www.sorotec.de/shop/CNC-Mechanics/linear-technology/ball-screw-spindle/sorotec-blue-line/ | 25.11 | 2 | 50.22 | vérifié | chiffre | 24,90 € TTC DE, recalculé à 21 %. Format standard FK12, compatible avec l'usinage des vis AliExpress. Même colis que les rails.
Guidage & transmission | M00518 | Flexible Motor Coupler D25L30 - 6.35mm to 10mm | 1 | acheter | Dold Mechatronik | Wellenkupplung XB flexibel D25L30 8,00 / 10,00 mm (à mâchoires, 5 Nm) | https://www.dold-mechatronik.de/Shaft-coupling-XB-flexible-D25L30-8.00-10.00mm | 10.86 | 1 | 10.86 | vérifié | chiffre | Prix lu TTC 19 % TVA DE (10.77 €), recalculé à 21 % TVA BE (vente à distance UE). ALÉSAGE CHOISI : 8 → 10 mm (axe Z, arbre Ø8 du NEMA23 retenu, au lieu de 6,35 mm ; consigne coordinateur). Modèle à mâchoires XB (5 Nm) préféré au modèle à lamelles RB (3 Nm, 8,00 € DE).
Guidage & transmission | M00519 | Flexible Motor Coupler D30L40 - 12.7mm/5ky to 10mm | 1 | acheter | Dold Mechatronik | Accouplement à mâchoires à moyeux serrants (Klemmnabe) D30L40, 10 / 14 mm | https://www.dold-mechatronik.de/ | 25.00 | 1 | 25.00 | estimation | chiffre | Moyeux serrants au lieu de vis de pression, sur l'arbre claveté Ø14 du moteur X : l'original (12,7 mm avec clavette 5 mm) ne glissait pas non plus. Prix non relevé.
Guidage & transmission | M00621 | Linear Block - H20B | 6 | acheter | Sorotec (Blue Line) | HGH20CA slide block short Blue Line | https://www.sorotec.de/shop/CNC-Mechanics/linear-technology/profile-rail-guides/sorotec-blue-line-936/ | 26.11 | 6 | 156.67 | vérifié | chiffre | 25,89 € TTC DE lu sur la page, recalculé à 21 %. 4,80 € de plus que chez Dold, mais rails et patins génériques doivent venir du même fabricant pour bien s'ajuster.
Guidage & transmission | M00622 | Linear Block - W20A Block (Flange) | 4 | acheter | Sorotec (Blue Line) | HGW20CC flange slide block short Blue Line | https://www.sorotec.de/shop/CNC-Mechanics/linear-technology/profile-rail-guides/sorotec-blue-line-936/ | 29.16 | 4 | 116.63 | vérifié | chiffre | 28,91 € TTC DE, recalculé à 21 %. Même fabricant que les rails.
Guidage & transmission | M00626 | Linear rail HGR20 (1500mm) - Docking | 6 | acheter | Sorotec (Blue Line) | Rail HGR20 Blue Line 1500 mm, 25 trous (réf. ZFS.NTS.HGR20.15) | https://www.sorotec.de/shop/CNC-Mechanics/linear-technology/profile-rail-guides/sorotec-blue-line-936/linear-guideways/hgr-20/ | 73.52 | 6 | 441.10 | vérifié | chiffre | 72,90 € TTC DE lu sur la page, recalculé à 21 %. Même niveau que Dold : compatible HGR sans marque, classe P, précharge moyenne (Dold ne vend pas du HIWIN d'origine). 1500 mm est une longueur du catalogue : 25 trous, E = 30 mm aux deux bouts. Demander en commentaire des coupes d'équerre ébavurées pour l'aboutage.
Guidage & transmission | M00624 | Linear Rail HGR20 (200mm) | 2 | acheter | Sorotec (Blue Line) | Rail HGR20 Blue Line 200 mm | https://www.sorotec.de/shop/CNC-Mechanics/linear-technology/profile-rail-guides/sorotec-blue-line-936/linear-guideways/hgr-20/ | 9.99 | 2 | 19.97 | vérifié | chiffre | 9,90 € TTC DE, recalculé à 21 %.
Guidage & transmission | M00704 | Nut Housing DSG16H | 2 | acheter | Dold Mechatronik | 16H Gehäuse Kugelumlaufmutter (DSG16H) | https://www.dold-mechatronik.de/16H-screw-nut-housing | 10.06 | 2 | 20.11 | vérifié | chiffre | Prix lu TTC 19 % TVA DE (9.97 €), recalculé à 21 % TVA BE (vente à distance UE). Boîtier 16H pour écrou Ø28 (SFU1605/1610). À vérifier : l'écrou SFS1620 livré doit être au même format (Ø28, bride 48) ; certains SFS1620 ont un écrou plus gros qui exige un autre boîtier.
Guidage & transmission | M00708 | Offset spacer 10x14x12mm | 2 | acheter | AliExpress (vendeur entrepôt UE si dispo) | Entretoise acier/inox Ø int. 10, Ø ext. 14, L 12 mm (lot) | https://fr.aliexpress.com/w/wholesale-entretoise-acier-10x14.html | 3.97 | 1 | 3.97 | estimation | chiffre | Estimation : entretoises tubulaires vendues par lots (≈ 3 à 6 €). On peut aussi les tourner dans un tube 14x2.
Guidage & transmission | M00733 | Pulley HTD-5M 16mm 20 teeth | 2 | acheter | Dold Mechatronik + atelier local | Poulie HTD-5M 20 dents acier BSY205M15-B-P14 (alésage 14 H7) + rainure de clavette 5 mm DIN 6885 brochée | https://www.dold-mechatronik.de/Toothed-belt-wheel-HTD-5M-15mm-wide-20-teeth-bore-14.00mm-H7-with-clamping-screws-steel | 29.62 | 2 | 59.24 | estimation | chiffre | 14,62 € la poulie (Dold, vérifié) + ~15 € de brochage par poulie (estimation). Les arbres Ø14 des NEMA 34 sont clavetés : sans clavette, une poulie qui glisse sur l'arbre n'est pas vue par le codeur du moteur, et le portique se met de travers sans alarme. L'original utilisait des pièces clavetées.
Guidage & transmission | M01692 | Spacer - 12x18x18 | 2 | acheter | AliExpress (vendeur entrepôt UE si dispo) | Entretoise acier/inox Ø int. 12, Ø ext. 18, L 18 mm (lot) | https://fr.aliexpress.com/w/wholesale-entretoise-acier-12x18.html | 3.97 | 1 | 3.97 | estimation | chiffre | Estimation : entretoises par lots (≈ 3 à 6 €). On peut aussi les couper dans un tube acier 18x3.
Guidage & transmission | M01691 | Spacer - 12x18x8 | 2 | acheter | AliExpress (vendeur entrepôt UE si dispo) | Entretoise acier/inox Ø int. 12, Ø ext. 18, L 8 mm (lot) | https://fr.aliexpress.com/w/wholesale-entretoise-acier-12x18.html | 3.97 | 1 | 3.97 | estimation | chiffre | Estimation : entretoises par lots (≈ 3 à 6 €).
Guidage & transmission | M01690 | Spacer -12x16x3 | 2 | acheter | AliExpress (vendeur entrepôt UE si dispo) | Entretoise / rondelle épaisse Ø int. 12, Ø ext. 16, ép. 3 mm (lot) | https://fr.aliexpress.com/w/wholesale-entretoise-acier-12x16.html | 3.97 | 1 | 3.97 | estimation | chiffre | Estimation : rondelles d'appui ou entretoises par lots (≈ 3 à 5 €). On peut aussi empiler des bagues de calage DIN 988 12x18.
Guidage & transmission | M00832 | Straight rack gauge M2 Q6 500mm | 1 | acheter | Dold Mechatronik | Zahnstange M2 L=502,65 mm C45 non trempée 20x20 (GG-446-020-0005), utilisée comme jauge de raccord | https://www.dold-mechatronik.de/Zahnstange-f.-fortlaufende-Montage-Modul2-Material-C45-Laenge-waehlbar_1 | 27.14 | 1 | 27.14 | vérifié | chiffre | Prix lu TTC 19 % TVA DE (26.92 €), recalculé à 21 % TVA BE (vente à distance UE). Dold n'a ni jauge de raccord droite M2 ni Q6 de 500 mm (sa jauge à 39 € est pour denture hélicoïdale). Cette crémaillère fraisée de 80 dents sert de jauge : elle convient pour aligner les jonctions, mais elle n'est pas Q6. Pour une jauge Q6, on peut utiliser un court tronçon de crémaillère rectifiée chinoise (≈ 25 €, estimation).
Guidage & transmission | M00831 | Straight Rack M2 DIN5 1005.31mm | 6 | acheter | DamenCNC (2 × 2 m) + Dold (2 × 1 m) | Gambini Q6 rectifiée 24×24×2010,6 mm (×2, DamenCNC) + Dold GG-445-020-0210 24×24×1005,31 mm mit Bohrbild (×2) | https://www.damencnc.com/en/straight-rack-module-2-q6-high-precision-24x24x2010-6mm/a2687 | 342.00 | 2 + 2 | 1276.52 | vérifié | chiffre | Par côté : 1 barre Gambini de 2010,6 mm + 1 barre Dold de 1005,31 mm = 3015,9 mm, comme 3 × 1005,31, avec une jonction de moins. DamenCNC : 285 € HT dès 2 pièces (300 € à l'unité) → 344,85 € TTC ×2 = 689,70 €. Dold : 293,79 € TTC DE dès 2 pièces (le 278,33 € du premier chiffrage ne vaut qu'à partir de 5) → 298,73 € TTC BE ×2 = 597,46 €. Équivalence vérifiée sur le STEP Gambini : 24×24, ligne primitive 22 mm, mêmes perçages (Ø7 lamé Ø11, pas de 125,66 mm, goupilles Ø5,7 à 31,3 mm des bouts). Gambini : qualité 6, dents trempées par induction 56-60 HRC, rectifiée sur toutes les faces, en stock. Le gabarit de raccord Dold reste valable.
Guidage & transmission | M00882 | Wheel with Bearings for V-slot Profile - Type B | 4 | acheter | Bits and Parts (bitsandparts.nl) | V-Slot wheel Creality/OpenBuilds noire, 625ZZ, Ø24 x 11 mm | https://www.bitsandparts.nl/en/v-slot-wheel-for-creality-openbuilds-3d-printer-black-p1911592 | 2.83 | 4 | 11.31 | vérifié | chiffre | Prix TTC NL 21 % (= TVA BE). Correspond à la roue du STEP (Ø23,9 x 11 mm, type OpenBuilds Solid V).
Capteurs & securite | M00406 | Circuit Breaker 15A 250V AC | 1 | acheter | AliExpress | Disjoncteur thermique de façade 15 A 250 VAC à réarmement | https://www.aliexpress.com/w/wholesale-15a-thermal-circuit-breaker-panel.html | 3.47 | 1 | 3.47 | estimation | chiffre | Pour la sécurité, un E-T-A 1410 ou Schurter TA45 (10–15 €) est préférable
Capteurs & securite | M00482 | Emergency Stop Button 1NC | 1 | acheter | Reichelt / RS / Conrad | Arrêt d'urgence Schneider Harmony XB5 Ø40 à accrochage, déverrouillage par rotation, 2 contacts NF |  | 38.00 | 1 | 38.00 | estimation | chiffre | 2 NF au lieu d'1 : le premier coupe la bobine du contacteur de puissance (vraie coupure électrique), le second va à l'entrée arrêt d'urgence du contrôleur PlanetCNC, qui arrête le programme. Un arrêt d'urgence qui ne passe que par le logiciel n'est pas une sécurité. Prix non relevé.
Capteurs & securite | M00591 | Inductive Sensor PNP NC, M12 | 6 | acheter | AliExpress | Capteur inductif LJ12A3-4-Z/AY M12 PNP NF 6–36 V, portée 4 mm (lot de 10) | https://fr.aliexpress.com/item/1005002932053626.html | 23.00 | 1 | 23.00 | estimation | chiffre | Prix relevé sur la page de résultats AliExpress (fr) le 08/11/2026, TVA UE supposée incluse. Vendu par 10, 6 utilisés. Câble surmoulé, pas de connecteur M12 (Omron E2B à connecteur ≈ 25–35 €/pc)
Capteurs & securite | M01078 | Touch Probe Z Device (3-pins model) | 1 | acheter | AliExpress | Palpeur d'outil Z à course ressort, 24 V, 3 fils, répétabilité 0,002 mm | https://fr.aliexpress.com/item/1005012109557514.html | 30.34 | 1 | 30.34 | estimation | chiffre | Prix relevé sur la page de résultats AliExpress (fr) le 08/11/2026, TVA UE supposée incluse
Cablage & connectique | M00086 | Black Male Banana Connector - Screw Termination, 50V, 16A | 1 | acheter | Reichelt (reichelt.com/be) | Fiche banane mâle noire 4 mm à vis, 16 A | https://www.reichelt.com/be/fr/shop/recherche/fiche%20banane%20noire | 1.49 | 1 | 1.49 | estimation | chiffre | Petite pièce, estimation
Cablage & connectique | M01237 | Blue Insulated Female Spade Connector, Receptacle, 4.8 x 0.5mm Tab Size, 1.5mm² to 2.5mm² | 3 | acheter | Reichelt (reichelt.com/be) | Cosses femelles isolées bleues 4,8×0,5 mm, 1,5–2,5 mm² (sachet de 100) | https://www.reichelt.com/be/fr/shop/recherche/cosse%20femelle%204,8%20bleu | 4.96 | 1 | 4.96 | estimation | chiffre | Vendu par sachet
Cablage & connectique | M00107 | C14 Panel Mount 10A fuse | 1 | acheter | Reichelt (reichelt.com/be) | Embase C14 à visser avec porte-fusible 5×20, 10 A | https://www.reichelt.com/be/fr/shop/recherche/embase%20C14%20fusible | 3.47 | 1 | 3.47 | estimation | chiffre | Petite pièce, estimation
Cablage & connectique | M01002 | CNC Fab - Belram lot of Sensor Cables | 1 | acheter | AliExpress | Câble blindé 3×0,3 mm² (RVVP, équivalent LiYCY 3×0,25), vendu au mètre | https://www.aliexpress.com/w/wholesale-rvvp-3-core-shielded-cable.html | 0.99 | 25 | 24.79 | estimation | chiffre | Lot câbles capteurs = 1,8 + 2,7 + 3,3 + 3,5 + 5,3 + 5,8 = 22,4 m, 25 m achetés. Les 6 lignes de câbles capteurs sont coupées dedans
Cablage & connectique | M00502 | Ethernet RJ45 female 50cm, panel mount | 1 | acheter | AliExpress | Prolongateur RJ45 mâle/femelle de façade 50 cm | https://www.aliexpress.com/w/wholesale-rj45-panel-mount-extension-cable.html | 3.47 | 1 | 3.47 | estimation | chiffre | Petite pièce, estimation
Cablage & connectique | M00984 | Female Banana Socket - Tab Termination | 1 | acheter | Reichelt (reichelt.com/be) | Douille banane femelle 4 mm à languette | https://www.reichelt.com/be/fr/shop/recherche/douille%20banane | 1.19 | 1 | 1.19 | estimation | chiffre | Petite pièce, estimation
Cablage & connectique | M00527 | Fork Spade Terminal 0.5mm² to 1.5mm², 22AWG to 16AWG, M4 Stud Size | 3 | acheter | Reichelt (reichelt.com/be) | Cosses fourche isolées rouges M4, 0,5–1,5 mm² (sachet de 100) | https://www.reichelt.com/be/fr/shop/recherche/cosse%20fourche%20M4 | 3.97 | 1 | 3.97 | estimation | chiffre | Vendu par sachet
Cablage & connectique | M00530 | Fuse T slow 10A | 1 | acheter | Reichelt (reichelt.com/be) | Fusible 5×20 mm temporisé T 10 A (boîte de 10) | https://www.reichelt.com/be/fr/shop/recherche/fusible%205x20%20T%2010A | 2.48 | 1 | 2.48 | estimation | chiffre | Vendu par boîte
Cablage & connectique | M00536 | GX12 male 2 pins aux 45cm, panel mount (Emergency Button) | 1 | acheter | AliExpress | Connecteur aviation GX12 2 broches, embase mâle + fiche femelle | https://www.aliexpress.com/w/wholesale-gx12-aviation-connector.html | 2.48 | 1 | 2.48 | estimation | chiffre | Câbler 45 cm de fil ; petite pièce, estimation
Cablage & connectique | M00537 | GX12 male 2 pins aux 45cm, panel mount (Safety Enclosure) | 2 | acheter | AliExpress | Connecteur aviation GX12 2 broches, embase mâle + fiche femelle | https://www.aliexpress.com/w/wholesale-gx12-aviation-connector.html | 2.48 | 2 | 4.96 | estimation | chiffre | Câbler 45 cm de fil ; petite pièce, estimation
Cablage & connectique | M01077 | GX12 male 3 pins aux 45cm, panel mount (Probe) | 1 | acheter | AliExpress | Connecteur aviation GX12 3 broches, embase mâle + fiche femelle | https://www.aliexpress.com/w/wholesale-gx12-aviation-connector.html | 2.48 | 1 | 2.48 | estimation | chiffre | Câbler 45 cm de fil ; petite pièce, estimation
Cablage & connectique | M00540 | GX12 male 5 pins output 45cm, panel mount (VFD, Laser) | 3 | acheter | AliExpress | Connecteur aviation GX12 5 broches, embase mâle + fiche femelle | https://www.aliexpress.com/w/wholesale-gx12-aviation-connector.html | 2.78 | 3 | 8.33 | estimation | chiffre | Câbler 45 cm de fil ; petite pièce, estimation
Cablage & connectique | M00542 | HDMI (female) panel mount to micro HDMI (male) | 1 | acheter | AliExpress | Prolongateur HDMI femelle de façade vers micro-HDMI mâle | https://www.aliexpress.com/w/wholesale-hdmi-panel-mount-micro-hdmi.html | 4.46 | 1 | 4.46 | estimation | chiffre | Petite pièce, estimation
Cablage & connectique | M00593 | Inductive sensor cable Unterminated 180cm | 1 | acheter | AliExpress | Coupé dans le câble blindé 3×0,3 mm² (ligne M01002) | https://www.aliexpress.com/w/wholesale-rvvp-3-core-shielded-cable.html | 0.00 | 0 | 0.00 | estimation | chiffre | Inclus dans les 25 m achetés sur la ligne M01002
Cablage & connectique | M00594 | Inductive sensor cable Unterminated 270cm | 1 | acheter | AliExpress | Coupé dans le câble blindé 3×0,3 mm² (ligne M01002) | https://www.aliexpress.com/w/wholesale-rvvp-3-core-shielded-cable.html | 0.00 | 0 | 0.00 | estimation | chiffre | Inclus dans les 25 m achetés sur la ligne M01002
Cablage & connectique | M00570 | Inductive Sensor Cable Unterminated 330cm | 1 | acheter | AliExpress | Coupé dans le câble blindé 3×0,3 mm² (ligne M01002) | https://www.aliexpress.com/w/wholesale-rvvp-3-core-shielded-cable.html | 0.00 | 0 | 0.00 | estimation | chiffre | Inclus dans les 25 m achetés sur la ligne M01002
Cablage & connectique | M00571 | Inductive Sensor Cable Unterminated 350cm | 1 | acheter | AliExpress | Coupé dans le câble blindé 3×0,3 mm² (ligne M01002) | https://www.aliexpress.com/w/wholesale-rvvp-3-core-shielded-cable.html | 0.00 | 0 | 0.00 | estimation | chiffre | Inclus dans les 25 m achetés sur la ligne M01002
Cablage & connectique | M00592 | Inductive sensor cable Unterminated 530cm | 1 | acheter | AliExpress | Coupé dans le câble blindé 3×0,3 mm² (ligne M01002) | https://www.aliexpress.com/w/wholesale-rvvp-3-core-shielded-cable.html | 0.00 | 0 | 0.00 | estimation | chiffre | Inclus dans les 25 m achetés sur la ligne M01002
Cablage & connectique | M00595 | Inductive sensor cable Unterminated 580cm | 1 | acheter | AliExpress | Coupé dans le câble blindé 3×0,3 mm² (ligne M01002) | https://www.aliexpress.com/w/wholesale-rvvp-3-core-shielded-cable.html | 0.00 | 0 | 0.00 | estimation | chiffre | Inclus dans les 25 m achetés sur la ligne M01002
Cablage & connectique | M01070 | Insulated Crimp Bootlace Ferrule | 4 | acheter | Reichelt (reichelt.com/be) | Embouts de câblage isolés 0,75 mm² (sachet de 100) | https://www.reichelt.com/be/fr/shop/recherche/embout%20de%20c%C3%A2blage%200,75 | 2.48 | 1 | 2.48 | estimation | chiffre | Vendu par sachet
Cablage & connectique | M00609 | Insulated Ring Terminal 0.5mm² to 1.5mm², 22AWG to 16AWG, M4 Stud Size | 1 | acheter | Reichelt (reichelt.com/be) | Cosses rondes isolées rouges M4, 0,5–1,5 mm² (sachet de 100) | https://www.reichelt.com/be/fr/shop/recherche/cosse%20ronde%20M4 | 3.97 | 1 | 3.97 | estimation | chiffre | Vendu par sachet
Cablage & connectique | M00659 | Micro-Fit 3.0 Female Connector Housing | 4 | acheter | Reichelt (reichelt.com/be) | Boîtier Molex Micro-Fit 3.0 femelle (43025, nombre de voies à confirmer) | https://www.reichelt.com/be/fr/shop/recherche/micro-fit%203.0 | 0.89 | 4 | 3.57 | estimation | chiffre | Prix Reichelt entre 0,86 et 1,47 € selon le nombre de voies
Cablage & connectique | M00660 | Micro-Fit 3.0 Male Connector Housing | 1 | acheter | Reichelt (reichelt.com/be) | Boîtier Molex Micro-Fit 3.0 mâle (43020/43640, nombre de voies à confirmer) | https://www.reichelt.com/be/fr/shop/recherche/micro-fit%203.0 | 0.85 | 1 | 0.85 | estimation | chiffre | 0,86 € vu pour la version 1×9 voies
Cablage & connectique | M00661 | Micro-Fit Female Crimp Terminal Contact | 14 | acheter | Reichelt (reichelt.com/be) | Contact à sertir Molex Micro-Fit femelle 43030-0007 (20–24 AWG) | https://www.reichelt.com/be/fr/shop/produit/contact_a_sertir_molex_micro-fit_connecteur_femelle-236641 | 0.15 | 14 | 2.08 | vérifié | chiffre | Prix TTC Reichelt BE
Cablage & connectique | M00662 | Micro-Fit Male Crimp Terminal Contact | 4 | acheter | Reichelt (reichelt.com/be) | Contact à sertir Molex Micro-Fit mâle 43031-0008 (20–24 AWG) | https://www.reichelt.com/be/fr/shop/produit/contact_a_sertir_molex_micro-fit_barrette-236644 | 0.46 | 4 | 1.82 | vérifié | chiffre | Prix TTC Reichelt BE
Cablage & connectique | M00691 | Motor cable X 340cm, Red (Fab) | 1 | acheter | AliExpress | Câble moteur blindé souple 4×1,0 mm² (TRVVP, pour chaîne porte-câbles), au mètre | https://www.aliexpress.com/w/wholesale-trvvp-4-core-1mm-shielded-cable.html | 2.78 | 4 | 11.11 | estimation | chiffre | 3,4 m arrondis à 4 m. Commander 20 m d'un seul tenant pour les 4 moteurs. Repérage couleur par gaine/étiquette
Cablage & connectique | M00692 | Motor cable Y1 340cm, Green (Fab) | 1 | acheter | AliExpress | Câble moteur blindé souple 4×1,0 mm² (TRVVP, pour chaîne porte-câbles), au mètre | https://www.aliexpress.com/w/wholesale-trvvp-4-core-1mm-shielded-cable.html | 2.78 | 4 | 11.11 | estimation | chiffre | 3,4 m arrondis à 4 m (bobine commune de 20 m)
Cablage & connectique | M00693 | Motor cable Y2 530cm, Yellow (Fab) | 1 | acheter | AliExpress | Câble moteur blindé souple 4×1,0 mm² (TRVVP, pour chaîne porte-câbles), au mètre | https://www.aliexpress.com/w/wholesale-trvvp-4-core-1mm-shielded-cable.html | 2.78 | 6 | 16.66 | estimation | chiffre | 5,3 m arrondis à 6 m (bobine commune de 20 m)
Cablage & connectique | M00694 | Motor cable Z 570cm, Blue (Fab) | 1 | acheter | AliExpress | Câble moteur blindé souple 4×1,0 mm² (TRVVP, pour chaîne porte-câbles), au mètre | https://www.aliexpress.com/w/wholesale-trvvp-4-core-1mm-shielded-cable.html | 2.78 | 6 | 16.66 | estimation | chiffre | 5,7 m arrondis à 6 m (bobine commune de 20 m)
Cablage & connectique | M00720 | Panel Mount IEC C14 Connector with RFI Filter, 15A 250V | 1 | acheter | — | Reporté avec le boîtier VFD |  | 0.00 | 0 | 0.00 | estimation | chiffre | Embase d'entrée du boîtier VFD (~8 €).
Cablage & connectique | M00007 | Power Cable C13 IEC to CEE 7/4, Schuko, 2m, 10 A, 250 V | 1 | acheter | Reichelt (reichelt.com/be) | Cordon secteur C13 vers fiche CEE 7/7 (Schuko/type E), 2 m, 10 A | https://www.reichelt.com/be/fr/shop/recherche/c%C3%A2ble%20C13 | 4.46 | 1 | 4.46 | estimation | chiffre | Fiche CEE 7/7 compatible prises belges et françaises
Cablage & connectique | M00726 | Power Distribution Unit 4-Way, 16A, 4000W | 1 | acheter | Reichelt (reichelt.com/fr) | Multiprise 4 prises 2P+T (type E français) 16 A 3500 W | https://www.reichelt.com/fr/fr/shop/ | 11.90 | 1 | 11.90 | estimation | chiffre | Version française (prises type E à broche de terre) au lieu de Schuko. Prix équivalent.
Cablage & connectique | M00744 | Rocker switch DPST, panel mount | 2 | acheter | Reichelt (reichelt.com/be) | Interrupteur à bascule bipolaire (DPST) de façade, 250 V | https://www.reichelt.com/be/fr/shop/recherche/interrupteur%20%C3%A0%20bascule%20bipolaire | 2.18 | 2 | 4.36 | estimation | chiffre | Petite pièce, estimation
Cablage & connectique | M00809 | Speakon Connector Panel Mount | 1 | acheter | — | Inutile avec la Makita |  | 0.00 | 0 | 0.00 | vérifié | chiffre | Sortie moteur du VFD vers la broche : inutile tant que la Makita est utilisée.
Cablage & connectique | M00852 | USB-A male to A female panel mount, 30cm | 2 | acheter | AliExpress | Prolongateur USB-A mâle/femelle de façade 30 cm | https://www.aliexpress.com/w/wholesale-usb-panel-mount-extension-cable.html | 2.48 | 2 | 4.96 | estimation | chiffre | Petite pièce, estimation
Cablage & connectique | M01392 | USB-A male to A female panel mount, 50cm, Blue (FAB) | 1 | acheter | AliExpress | Prolongateur USB-A mâle/femelle de façade 50 cm | https://www.aliexpress.com/w/wholesale-usb-panel-mount-extension-cable.html | 2.98 | 1 | 2.98 | estimation | chiffre | Couleur bleue non garantie
Cablage & connectique | M00851 | USB-A USB-B cable 30cm Elbow type | 1 | acheter | AliExpress | Câble USB-A vers USB-B coudé 30 cm | https://www.aliexpress.com/w/wholesale-usb-a-usb-b-angle-cable-30cm.html | 2.98 | 1 | 2.98 | estimation | chiffre | Petite pièce, estimation
Cablage & connectique | M00865 | Wago 3 connectors | 5 | acheter | Reichelt (reichelt.com/be) | WAGO 221-413, borne de connexion 3 conducteurs | https://www.reichelt.com/be/fr/shop/produit/borne_de_connexion_raccord_3_conducteurs-149799 | 0.56 | 5 | 2.78 | vérifié | chiffre | Prix TTC Reichelt BE
Cablage & connectique | M00866 | Wago 5 connectors | 5 | acheter | Reichelt (reichelt.com/be) | WAGO 221-415, borne de connexion 5 conducteurs | https://www.reichelt.com/be/fr/shop/produit/borne_de_connexion_raccord_5_conducteurs-149800 | 0.80 | 5 | 4.02 | vérifié | chiffre | Prix TTC Reichelt BE
Cablage & connectique | M00918 | XLR 4 pole female panel M3, Pre-wired 18cm breakout | 4 | acheter | Reichelt (reichelt.com/be) | Neutrik NC4FD-L-1, embase XLR 4 femelle (vis M3), plus 4 fils de 18 cm | https://www.reichelt.com/be/fr/shop/recherche/XLR%204%20femelle | 5.45 | 4 | 21.82 | estimation | chiffre | Pré-câblage à faire soi-même ; petite pièce, estimation
Cablage & connectique | M00919 | XLR4 Male - NC4MXX-BAG | 3 | acheter | Reichelt (reichelt.com/be) | Neutrik NC4MXX-B, fiche XLR 4 mâle de câble, noire | https://www.reichelt.com/be/fr/shop/produit/connecteur_de_cable_4_broches_avec_boitier_chrome_noir-414152 | 5.80 | 3 | 17.40 | vérifié | chiffre | Prix TTC Reichelt BE
Gestion des cables | M00391 | Cable chain TEZ25.50K 1200mm | 1 | acheter | Motedis | Chaîne porte-câbles CK 24 largeur 60 mm (24 x 60 int.), sachets 1 m + 1 paire d'éléments de connexion | https://www.motedis.be/fr/Chaine-porte-cables-CK-24-1-sachet-24-maillons-longueur-1m | 27.22 | 1 | 27.22 | vérifié | chiffre | 3 sachets de 1 m à 19,93 € TTC pour les deux chaînes (1,2 + 1,8 = 3,0 m), répartis au prorata, + 1 paire d'embouts à 3,53 €. Pas de 25x50 chez Motedis : 24x60 int., encombrement et entraxe des embouts à vérifier sur les supports de chaîne acier.
Gestion des cables | M00392 | Cable chain TEZ25.50K 1800mm | 1 | acheter | Motedis | Chaîne porte-câbles CK 24 largeur 60 mm (24 x 60 int.), sachets 1 m + 1 paire d'éléments de connexion | https://www.motedis.be/fr/Chaine-porte-cables-CK-24-1-sachet-24-maillons-longueur-1m | 39.07 | 1 | 39.07 | vérifié | chiffre | Voir M00391 : 1,8 m pris sur les 3 sachets de 1 m (19,93 € TTC) + 1 paire d'embouts 3,53 €. Même réserve 24x60 vs 25x50.
Gestion des cables | M00383 | Cable Cover for I-type 6 Profile (2m) | 0.34 | acheter | Dold Mechatronik (aluprofile-express.de) | Abdeckprofil Kunststoff NBR I-Typ Nut 6, ca. 1000 mm (art. 62491) | https://www.aluprofile-express.de/Abdeckprofil-Kunststoff-NBR-I-Typ-Nut-6-ca-1000-mm | 5.94 | 1 | 5.94 | vérifié | chiffre | Besoin 2 x 330 mm = 0,66 m : une barre de ~1 m suffit. 5,89 € TTC DE. Prix Dold affiché TTC DE 19 %, converti en TTC BE 21 % (x1,21/1,19).
Gestion des cables | M00389 | Cable Tie 100mm x 2.5 mm | 28 | acheter | Reichelt (reichelt.com/be) | Colliers de serrage 100×2,5 mm (sachet de 100) | https://www.reichelt.com/be/fr/shop/recherche/collier%20100%202,5 | 1.98 | 1 | 1.98 | estimation | chiffre | Vendu par sachet
Gestion des cables | M00390 | Cable Tie 200mm x 4.6 mm, Black | 18 | acheter | Reichelt (reichelt.com/be) | Colliers de serrage noirs 200×4,6 mm (sachet de 100) | https://www.reichelt.com/be/fr/shop/recherche/collier%20200%204,8 | 3.97 | 1 | 3.97 | estimation | chiffre | Vendu par sachet
Gestion des cables | M00973 | Cable Tie 368mm x 4.8 mm, White | 2 | acheter | Reichelt (reichelt.com/be) | Colliers de serrage blancs 368×4,8 mm (sachet de 100) | https://www.reichelt.com/be/fr/shop/recherche/collier%20370 | 5.95 | 1 | 5.95 | estimation | chiffre | Vendu par sachet
Gestion des cables | M00956 | Cable Trunking D31mm L500mm | 3 | acheter | Achat local (bricolage / grossiste électrique) | Goulotte flexible fendue à visser 30 mm (31 x 33), L 500 mm, ex. Hager VK flex M5692 | https://hager.com/fr-be/catalogue/produits/m5692-goulot-vk-flex-30-500mm | 7.93 | 3 | 23.80 | estimation | chiffre | Prix public non affiché chez Hager (conditionnement pro x40) ; ~6,7-9,5 € la pièce relevés sur d'autres sites Hager, d'où 8 € estimés au détail.
Gestion des cables | M00826 | FAB - Steel cable tray 3000mm (2x1500mm) | 1 | acheter | Achat local (bricolage / grossiste électrique) | Chemin de câbles tôle perforée acier galvanisé 100 x 50 mm, longueur 3 m, à recouper en 2 x 1,5 m |  | 39.67 | 1 | 39.67 | estimation | chiffre | Tarif pro Legrand P31 50x100 3 m ~40,92 € HT ; marques de négoce moins chères. Achat en magasin conseillé (3 m coûteux à expédier).
Gestion des cables | M00827 | Steel cable tray cantilever arm | 2 | acheter | Achat local (bricolage / grossiste électrique) | Console / bras support pour chemin de câbles 100 mm |  | 5.95 | 2 | 11.90 | estimation | chiffre | Prix courant d'une console simple 100 mm en acier galvanisé, non vérifié.
Gestion des cables | M00864 | VariBox CHV27 34x26x15 simple cannelure | 1 | acheter | — | — |  | 0.00 | 0 | 0.00 | vérifié | chiffre | Emballage, inutile.
Visserie & fixations | M00062 | Angle Bracket 30 B-Type Rainure 6 | 38 | acheter | Dold Mechatronik (aluprofile-express.de) | Winkel 30 I-Typ Nut 6, Alu-Druckguss, avec nez de centrage (art. 62378) | https://www.aluprofile-express.de/Winkel-30-I-Typ-Nut-6 | 1.47 | 38 | 55.96 | vérifié | chiffre | Palier dès 10 pcs : 1,46 € TTC DE. Prix Dold affiché TTC DE 19 %, converti en TTC BE 21 % (x1,21/1,19). C'est la cornière « Dold » nommée dans le STEP (29,6 x 29,6 x 28). 50 pcs à 1,25 € reviendraient plus cher.
Visserie & fixations | M00063 | Angle Bracket 60 B-Type Groove 8 | 46 | acheter | Dold Mechatronik (aluprofile-express.de) | Winkel 60x60 Nut 8 B-Typ, Alu-Druckguss, sans nez de centrage Nut 8 (art. 67250) | https://www.aluprofile-express.de/Winkel-60x60-Nut-8-B-Typ | 2.95 | 50 | 147.72 | vérifié | chiffre | 50 pcs au palier 2,93 € TTC DE (146,50 €) < 46 x 3,25 € (149,50 €) : on en prend 50 (le STEP en compte 50). Prix Dold affiché TTC DE 19 %, converti en TTC BE 21 % (x1,21/1,19). Sans nez Nut 8 ; casser les nez Nut 10 si présents. Monté en rainure 6 avec vis M6 + rondelle DIN9021 + écrou I M6, comme dans le STEP.
Visserie & fixations | M00064 | Angle Bracket Simple 20x20 M5 | 4 | acheter | Dold Mechatronik (aluprofile-express.de) | Winkel 20 B-Typ Nut 6, trous pour vis M5 (art. F093W203N06S05) | https://www.aluprofile-express.de/Winkel-20-B-Typ-Nut-6-mit-Bohrungen-fuer-M5-Schrauben | 0.89 | 4 | 3.55 | vérifié | chiffre | 0,88 € TTC DE. Prix Dold affiché TTC DE 19 %, converti en TTC BE 21 % (x1,21/1,19). Nez de 6 mm compatibles avec la rainure I 6 (6,2 mm).
Visserie & fixations | M00407 | Coloured Washer M3 - Blue | 2 | acheter | Amazon.fr (optionnel, décoratif) | Rondelle aluminium anodisé M3, assortiment multicolore (~100 pcs), part au prorata | https://www.amazon.fr/s?k=rondelle+aluminium+anodis%C3%A9+M3 | 0.70 | 2 | 1.40 | estimation | chiffre | Introuvable chez TME et Motedis. Purement décoratif : assortiment ~7 € TTC réparti sur les 10 pièces. Prix non lu (Amazon non consultable) ; à défaut, rondelles DIN 125 M3 standard
Visserie & fixations | M00408 | Coloured Washer M3 - Green | 3 | acheter | Amazon.fr (optionnel, décoratif) | Rondelle aluminium anodisé M3, assortiment multicolore (~100 pcs), part au prorata | https://www.amazon.fr/s?k=rondelle+aluminium+anodis%C3%A9+M3 | 0.70 | 3 | 2.10 | estimation | chiffre | Introuvable chez TME et Motedis. Purement décoratif : assortiment ~7 € TTC réparti sur les 10 pièces. Prix non lu (Amazon non consultable) ; à défaut, rondelles DIN 125 M3 standard
Visserie & fixations | M00409 | Coloured Washer M3 - Red | 3 | acheter | Amazon.fr (optionnel, décoratif) | Rondelle aluminium anodisé M3, assortiment multicolore (~100 pcs), part au prorata | https://www.amazon.fr/s?k=rondelle+aluminium+anodis%C3%A9+M3 | 0.70 | 3 | 2.10 | estimation | chiffre | Introuvable chez TME et Motedis. Purement décoratif : assortiment ~7 € TTC réparti sur les 10 pièces. Prix non lu (Amazon non consultable) ; à défaut, rondelles DIN 125 M3 standard
Visserie & fixations | M00410 | Coloured Washer M3 - Yellow | 2 | acheter | Amazon.fr (optionnel, décoratif) | Rondelle aluminium anodisé M3, assortiment multicolore (~100 pcs), part au prorata | https://www.amazon.fr/s?k=rondelle+aluminium+anodis%C3%A9+M3 | 0.70 | 2 | 1.40 | estimation | chiffre | Introuvable chez TME et Motedis. Purement décoratif : assortiment ~7 € TTC réparti sur les 10 pièces. Prix non lu (Amazon non consultable) ; à défaut, rondelles DIN 125 M3 standard
Visserie & fixations | M00423 | DIN9021 Washer M4x12 | 24 | acheter | Motedis (motedis.fr) | Rondelle DIN 9021 M4, acier zingué (réf. DIN9021-ZN-M4), lot de 10 | https://www.motedis.fr/fr/Rondelle-DIN-9021-for-M3-M4-M5-M6-M8-M10-and-M12/DIN-9021-x-M4 | 0.27 | 3 | 0.81 | vérifié | chiffre | Motedis : prix TTC 20 % lu sur la fiche (compteur déstockage 0/0, donc prix normal) ; stock affiché en JavaScript, non lisible : à confirmer au panier
Visserie & fixations | M00424 | DIN9021 Washer M5x15 | 6 | acheter | Motedis (motedis.fr) | Rondelle DIN 9021 M5, acier zingué (réf. DIN9021-ZN-M5), lot de 10 | https://www.motedis.fr/fr/Rondelle-DIN-9021-for-M3-M4-M5-M6-M8-M10-and-M12/DIN-9021-x-M5 | 0.27 | 1 | 0.27 | vérifié | chiffre | Motedis : prix TTC 20 % lu sur la fiche (compteur déstockage 0/0, donc prix normal) ; stock affiché en JavaScript, non lisible : à confirmer au panier
Visserie & fixations | M01694 | DIN9021 Washer M6x18 | 276 | acheter | Motedis (motedis.fr) | Rondelle DIN 9021 M6, acier zingué (réf. DIN9021-ZN-M6), lot de 10 | https://www.motedis.fr/fr/Rondelle-DIN-9021-for-M3-M4-M5-M6-M8-M10-and-M12/DIN-9021-x-M6 | 0.40 | 28 | 11.20 | vérifié | chiffre | Motedis : prix TTC 20 % lu sur la fiche (compteur déstockage 0/0, donc prix normal) ; stock affiché en JavaScript, non lisible : à confirmer au panier. 28 lots = 280 pièces
Visserie & fixations | M01697 | DIN912 M4x12 Black screw | 44 | acheter | TME (tme.eu/fr, Pologne, UE) | Bossard B4X12/BN272 (réf. 1000195) : DIN 912 / ISO 4762 M4x12, acier 8.8 noirci, multiple de 100 | https://www.tme.eu/fr/details/b4x12_bn272/boulons/bossard/1000195/ | 4.00 | 1 | 4.00 | vérifié | chiffre | TME : prix « brut » = TTC TVA FR 20 % (net x1,20), lu sur la fiche : 0,04 €/pc au palier 100 (affichage arrondi au centime) ; stock 2 495
Visserie & fixations | M01698 | DIN912 M4x16 Black screw | 4 | acheter | Motedis (motedis.fr) | Vis DIN 912 M4x16 8.8 zinguée (réf. DIN912-vz-M4x16), sachet de 100 | https://www.motedis.fr/fr/Vis-DIN-912/M4x16 | 6.67 | 1 | 6.67 | vérifié | chiffre | Motedis : prix TTC 20 % lu sur la fiche (compteur déstockage 0/0, donc prix normal) ; stock affiché en JavaScript, non lisible : à confirmer au panier. Zingué blanc (accepté)
Visserie & fixations | M00430 | DIN912 M4x20 Black screw | 4 | acheter | TME (tme.eu/fr, Pologne, UE) | Bossard B4X20/BN272 (réf. 1000233) : DIN 912 M4x20, acier 8.8 noirci, multiple de 100 | https://www.tme.eu/fr/details/b4x20_bn272/boulons/bossard/ | 5.20 | 1 | 5.20 | vérifié | chiffre | TME : prix « brut » = TTC TVA FR 20 % (net x1,20), lu sur la fiche : 0,052 €/pc au palier 100 ; stock 2 000
Visserie & fixations | M00939 | DIN912 M4x30 Black screw | 8 | acheter | Motedis (motedis.fr) | Vis DIN 912 M4x30 8.8 zinguée (réf. DIN912-vz-M4x30), sachet de 100 | https://www.motedis.fr/fr/Vis-DIN-912/M4x30 | 9.33 | 1 | 9.33 | vérifié | chiffre | Motedis : prix TTC 20 % lu sur la fiche (compteur déstockage 0/0, donc prix normal) ; stock affiché en JavaScript, non lisible : à confirmer au panier. Pas de M4x30 acier chez TME (seulement inox ou RECA par 1 000)
Visserie & fixations | M00432 | DIN912 M4x45 Black Screw | 4 | acheter | TME (tme.eu/fr, Pologne, UE) | Bossard B4X45/BN7 (réf. 1006959) : DIN 912 M4x45, acier 12.9 noirci, multiple de 100 | https://www.tme.eu/fr/details/b4x45_bn7/boulons/bossard/ | 11.00 | 1 | 11.00 | estimation | chiffre | Prix lu (0,110 €/pc au palier 100) mais RUPTURE chez TME au 08/11/2026 (stock 0) ; Motedis ne fait pas de M4 au-delà de 35 mm. Vérifier le délai TME au panier ou acheter ailleurs (bricovis.fr, vis-express.fr : prix non lisibles)
Visserie & fixations | M00433 | DIN912 M4x55 Black Screw | 8 | acheter | TME (tme.eu/fr, Pologne, UE) | RECA 00824 55 000 200 : ISO 4762 M4x55, acier 8.8 noir (sans revêtement), multiple de 200 | https://www.tme.eu/fr/details/m4x55_4762_8bl/boulons/reca/00824-55-000-200/ | 26.00 | 1 | 26.00 | estimation | chiffre | Prix lu (0,130 €/pc par 200) mais RUPTURE chez TME au 08/11/2026 (stock 0) et conditionnement de 200 pour 8 vis. Aucune M4x55 acier chez Motedis ni en Bossard chez TME. Ligne à confirmer ou à acheter ailleurs (bricovis.fr, vis-express.fr)
Visserie & fixations | M00435 | DIN912 M5x12 Black screw | 10 | acheter | Motedis (motedis.fr) | Vis DIN 912 M5x12 8.8 zinguée (réf. DIN912-vz-M5x12), sachet de 100 | https://www.motedis.fr/fr/Vis-DIN-912/M5x12 | 6.67 | 1 | 6.67 | vérifié | chiffre | Motedis : prix TTC 20 % lu sur la fiche (compteur déstockage 0/0, donc prix normal) ; stock affiché en JavaScript, non lisible : à confirmer au panier
Visserie & fixations | M00436 | DIN912 M5x14 Black screw | 8 | acheter | Motedis (motedis.fr) | Vis DIN 912 M5x14 8.8 zinguée (réf. DIN912-vz-M5x14), sachet de 100 | https://www.motedis.fr/fr/Vis-DIN-912/M5x14 | 6.67 | 1 | 6.67 | vérifié | chiffre | Motedis : prix TTC 20 % lu sur la fiche (compteur déstockage 0/0, donc prix normal) ; stock affiché en JavaScript, non lisible : à confirmer au panier. Chez TME, la seule M5x14 acier (Bossard BN 3) se vend par 200
Visserie & fixations | M00437 | DIN912 M5x16 Black screw | 190 | acheter | TME (tme.eu/fr, Pologne, UE) | Bossard B5X16/BN272 (réf. 1000381) : DIN 912 M5x16, acier 8.8 noirci, multiple de 100 | https://www.tme.eu/fr/details/b5x16_bn272/boulons/bossard/1000381/ | 4.70 | 2 | 9.40 | vérifié | chiffre | TME : prix « brut » = TTC TVA FR 20 % (net x1,20), lu sur la fiche : 0,047 €/pc au palier 100 ; stock 2 200
Visserie & fixations | M01731 | DIN912 M5x20 Black screw | 12 | acheter | Motedis (motedis.fr) | Vis DIN 912 M5x20 8.8 zinguée (réf. DIN912-vz-M5x20), sachet de 100 | https://www.motedis.fr/fr/Vis-DIN-912/M5x20 | 9.33 | 1 | 9.33 | vérifié | chiffre | Motedis : prix TTC 20 % lu sur la fiche (compteur déstockage 0/0, donc prix normal) ; stock affiché en JavaScript, non lisible : à confirmer au panier
Visserie & fixations | M00439 | DIN912 M5x25 Black screw | 8 | acheter | Motedis (motedis.fr) | Vis DIN 912 M5x25 8.8 zinguée (réf. DIN912-vz-M5x25), sachet de 100 | https://www.motedis.fr/fr/Vis-DIN-912/M5x25 | 6.67 | 1 | 6.67 | vérifié | chiffre | Motedis : prix TTC 20 % lu sur la fiche (compteur déstockage 0/0, donc prix normal) ; stock affiché en JavaScript, non lisible : à confirmer au panier
Visserie & fixations | M00442 | DIN912 M5x40 Black screw | 4 | acheter | Motedis (motedis.fr) | Vis DIN 912 M5x40 8.8 zinguée (réf. DIN912-vz-M5x40), sachet de 100 | https://www.motedis.fr/fr/Vis-DIN-912/M5x40 | 9.33 | 1 | 9.33 | vérifié | chiffre | Motedis : prix TTC 20 % lu sur la fiche (compteur déstockage 0/0, donc prix normal) ; stock affiché en JavaScript, non lisible : à confirmer au panier
Visserie & fixations | M00444 | DIN912 M5x50 Black screw | 4 | acheter | Motedis (motedis.fr) | Vis DIN 912 M5x50 8.8 zinguée (réf. DIN912-vz-M5x50), sachet de 100 | https://www.motedis.fr/fr/Vis-DIN-912/M5x50 | 16.00 | 1 | 16.00 | vérifié | chiffre | Motedis : prix TTC 20 % lu sur la fiche (compteur déstockage 0/0, donc prix normal) ; stock affiché en JavaScript, non lisible : à confirmer au panier
Visserie & fixations | M00445 | DIN912 M5x60 Black screw | 4 | acheter | TME (tme.eu/fr, Pologne, UE) | Bossard B5X60/BN7 (réf. 1007300) : DIN 912 M5x60, acier 12.9 noirci, multiple de 100 | https://www.tme.eu/fr/details/b5x60_bn7/boulons/bossard/ | 16.00 | 1 | 16.00 | vérifié | chiffre | TME : prix « brut » = TTC TVA FR 20 % (net x1,20), lu sur la fiche : 0,160 €/pc au palier 100 ; stock 700. Motedis s'arrête à M5x50
Visserie & fixations | M01718 | DIN912 M6x12 Black screw | 14 | acheter | Motedis (motedis.fr) | Vis DIN 912 M6x12 8.8 zinguée (réf. DIN912-vz-M6x12), sachet de 100 | https://www.motedis.fr/fr/Vis-DIN-912/M6x12 | 6.67 | 1 | 6.67 | vérifié | chiffre | Motedis : prix TTC 20 % lu sur la fiche (compteur déstockage 0/0, donc prix normal) ; stock affiché en JavaScript, non lisible : à confirmer au panier
Visserie & fixations | M01704 | DIN912 M6x16 Black screw | 318 | acheter | TME (tme.eu/fr, Pologne, UE) | Bossard B6X16/BN7 (réf. 1007564) : DIN 912 M6x16, acier 12.9 noirci, multiple de 100 | https://www.tme.eu/fr/details/b6x16_bn7/boulons/bossard/1007564/ | 6.20 | 4 | 24.80 | vérifié | chiffre | TME : prix « brut » = TTC TVA FR 20 % (net x1,20), lu sur la fiche : 0,062 €/pc au palier 100 ; stock 1 900. Moins cher que la version 8.8 noire BN 272 (0,073 €/pc)
Visserie & fixations | M00451 | DIN912 M6x20 Black screw | 66 | acheter | TME (tme.eu/fr, Pologne, UE) | Bossard B6X20/BN7 (réf. 1007580) : DIN 912 M6x20, acier 12.9 noirci, multiple de 100 | https://www.tme.eu/fr/details/b6x20_bn7/boulons/bossard/ | 7.40 | 1 | 7.40 | vérifié | chiffre | TME : prix « brut » = TTC TVA FR 20 % (net x1,20), lu sur la fiche : 0,074 €/pc au palier 100 ; stock 1 800
Visserie & fixations | M01748 | DIN912 M6x25 Black screw | 60 | acheter | TME (tme.eu/fr, Pologne, UE) | Bossard B6X25/BN272 (réf. 1000659) : DIN 912 M6x25, acier 8.8 noirci, multiple de 100 | https://www.tme.eu/fr/details/b6x25_bn272/boulons/bossard/1000659/ | 8.00 | 1 | 8.00 | vérifié | chiffre | TME : prix « brut » = TTC TVA FR 20 % (net x1,20), lu sur la fiche : 0,080 €/pc au palier 100 ; stock 700 (Motedis : 13,33 € le sachet de 100)
Visserie & fixations | M00488 | End connection plate 30x60 for Foot M12 | 6 | acheter | Découpe laser (avec le lot acier) | Plaque 60 x 30 x 10 mm acier, DXF cad/steel/fab/dxf/Foot_Plate_3060_M6_v2_t10mm_x6.dxf, taraudage M12 central |  | 3.97 | 6 | 23.80 | estimation | chiffre | Aucun équivalent 30x60 M12 rainure 6 chez Dold ni Motedis (Dold : 30x60 en M8 seulement). À ajouter au devis laser 10 mm. Mettre 0 si le lot acier les chiffre déjà.
Visserie & fixations | M00524 | Foot D80 M12x50 + Jam nut M12 + Anti Slip | 6 | acheter | Motedis | Pieds réglables D80 M12 L50, embase PA66, capuchon amortisseur + écrou inclus (réf. BD80-12x50), lot de 4 | https://www.motedis.be/fr/Pieds-reglables-D80-M12-L50 | 6.93 | 2 | 13.86 | vérifié | chiffre | 6,99 € TTC BE le lot de 4 : 2 lots = 8 pieds pour 6 nécessaires. Page : « Stock actuellement insuffisant ». Pas de pied D80 M12 trouvé chez Dold.
Visserie & fixations | M00552 | Hex spacer M3x30 female/female | 2 | acheter | TME (tme.eu/fr, Pologne, UE) | DREMEC 114X30 (TFF-M3X30/DR114) : entretoise hexagonale M3 femelle/femelle 30 mm, laiton nickelé, clé 5,5 | https://www.tme.eu/fr/details/tff-m3x30_dr114/entretoises-metalliques/dremec/114x30/ | 0.43 | 10 | 4.30 | vérifié | chiffre | TME : prix « brut » = TTC TVA FR 20 % (net x1,20), lu sur la fiche : 0,43 €/pc par 10 (minimum 10) ; stock 1 020
Visserie & fixations | M00553 | Hex spacer M3x8 female/female | 8 | acheter | TME (tme.eu/fr, Pologne, UE) | DREMEC 114X08 (TFF-M3X8/DR114) : entretoise hexagonale M3 femelle/femelle 8 mm, laiton nickelé, clé 5,5 | https://www.tme.eu/fr/details/tff-m3x8_dr114/entretoises-metalliques/dremec/114x08/ | 0.24 | 10 | 2.40 | vérifié | chiffre | TME : prix « brut » = TTC TVA FR 20 % (net x1,20), lu sur la fiche : 0,24 €/pc par 10 (minimum 10) ; stock 2 820
Visserie & fixations | M00554 | I-Type Sliding Nut M4 | 24 | acheter | Dold Mechatronik (aluprofile-express.de) | Nutenstein mit Steg I-Typ Nut 6 M4, einschwenkbar, Federkugel (art. 62347-VK) | https://www.aluprofile-express.de/Nutenstein-mit-Steg-I-Typ-Nut-6-Gewindedurchmesser-M4 | 0.48 | 24 | 11.61 | vérifié | chiffre | Palier dès 10 pcs : 0,48 € TTC DE. Prix Dold affiché TTC DE 19 %, converti en TTC BE 21 % (x1,21/1,19). Écrou à pivoter avec bille ressort, conforme à l'écrou du STEP (10,5 x 17 mm).
Visserie & fixations | M00555 | I-Type Sliding Nut M5 | 168 | acheter | Dold Mechatronik (aluprofile-express.de) | Nutenstein mit Steg I-Typ Nut 6 M5, einschwenkbar, Federkugel (art. 62361-VK) | https://www.aluprofile-express.de/Nutenstein-mit-Steg-I-Typ-Nut-6-Gewindedurchmesser-M5 | 0.30 | 168 | 50.82 | vérifié | chiffre | Palier dès 100 pcs : 0,30 € TTC DE. Prix Dold affiché TTC DE 19 %, converti en TTC BE 21 % (x1,21/1,19).
Visserie & fixations | M00556 | I-Type Sliding Nut M6 | 368 | acheter | Dold Mechatronik (aluprofile-express.de) | Nutenstein mit Steg I-Typ Nut 6 M6, einschwenkbar, Federkugel (art. 62354-VK) | https://www.aluprofile-express.de/Nutenstein-mit-Steg-I-Typ-Nut-6-Gewindedurchmesser-M6 | 0.30 | 368 | 111.31 | vérifié | chiffre | Palier dès 100 pcs : 0,30 € TTC DE (500 pcs à 0,27 € = 135 € reviendraient plus cher). Prix Dold affiché TTC DE 19 %, converti en TTC BE 21 % (x1,21/1,19). Rainure 6 partout, y compris sur le 60x60.
Visserie & fixations | M00561 | ISO 7379 M10x50 Shoulder Screw | 2 | acheter | TME (tme.eu/fr, Pologne, UE) | Elesa+Ganter ISO 7379-12-M10-50 : vis épaulée Ø12 x 50, filet M10, acier 12.9 noirci | https://www.tme.eu/fr/details/iso7379-12-m10-50/vis-epaulees/elesa-ganter/ | 3.09 | 2 | 6.18 | estimation | chiffre | Prix lu (3,09 €/pc à l'unité) mais RUPTURE chez TME au 08/11/2026 (stock 0) ; conditionnement fabricant par 10. Variante inox A2 (-NI) en stock à 15,04 €/pc mais 1 seule pièce et non 12.9. Motedis n'a pas ce format. Vérifier le délai au panier
Visserie & fixations | M00560 | ISO 7379 M8x45 Shoulder Screw | 2 | acheter | TME (tme.eu/fr, Pologne, UE) | Elesa+Ganter ISO 7379-10-M8-45 : vis épaulée Ø10 x 45, filet M8, acier 12.9 noirci | https://www.tme.eu/fr/details/iso7379-10-m8-45/vis-epaulees/elesa-ganter/ | 2.37 | 2 | 4.74 | vérifié | chiffre | TME : prix « brut » = TTC TVA FR 20 % (net x1,20), lu sur la fiche ; stock 4 au 08/11/2026 (vente à l'unité)
Visserie & fixations | M01693 | ISO 7380 M3x10 Black Screw | 12 | acheter | Motedis (motedis.fr) | Vis DIN 7380 / ISO 7380 M3x10, 8.8 zinguée (réf. DIN7380-vz-M3x10), sachet de 100 | https://www.motedis.fr/fr/Vis-DIN-7380/M3x10 | 4.00 | 1 | 4.00 | vérifié | chiffre | Motedis : prix TTC 20 % lu sur la fiche (compteur déstockage 0/0, donc prix normal) ; stock affiché en JavaScript, non lisible : à confirmer au panier. Classe 8.8 (acceptée pour ISO 7380)
Visserie & fixations | M01715 | ISO 7380 M3x4 Black Screw | 46 | acheter | TME (tme.eu/fr, Pologne, UE) | Kraftberg M3X4/ISO7380-1-A2 : vis tête bombée six pans creux M3x4, INOX A2 (classe non annoncée), multiple de 100 | https://www.tme.eu/fr/details/m3x4_iso7380-1-a2/boulons/kraftberg/ | 2.00 | 1 | 2.00 | estimation | chiffre | NON CONFORME à la règle qualité : aucune ISO 7380 M3x4 en acier 8.8/10.9 chez TME ni Motedis (Motedis commence à M3x6, Bossard BN 19 à M3x6). Prix lu 0,02 €/pc (stock 13 000) mais inox A2 sans classe affichée : à valider (vis de capot du boîtier de commande) ou acheter une 10.9 noire ailleurs
Visserie & fixations | M00566 | ISO 7380 M5x20 Black Screw | 4 | acheter | Motedis (motedis.fr) | Vis DIN 7380 / ISO 7380 M5x20, 8.8 zinguée (réf. DIN7380-vz-M5x20), sachet de 100 | https://www.motedis.fr/fr/Vis-DIN-7380/M5x20 | 8.00 | 1 | 8.00 | vérifié | chiffre | Motedis : prix TTC 20 % lu sur la fiche (compteur déstockage 0/0, donc prix normal) ; stock affiché en JavaScript, non lisible : à confirmer au panier. Pas d'ISO 7380 M5 acier chez TME
Visserie & fixations | M00568 | ISO 7380 M6x25 Black Screw | 8 | acheter | Motedis (motedis.fr) | Vis DIN 7380 / ISO 7380 M6x25, 8.8 zinguée (réf. DIN7380-vz-M6x25), sachet de 100 | https://www.motedis.fr/fr/Vis-DIN-7380/M6x25 | 9.33 | 1 | 9.33 | vérifié | chiffre | Motedis : prix TTC 20 % lu sur la fiche (compteur déstockage 0/0, donc prix normal) ; stock affiché en JavaScript, non lisible : à confirmer au panier. Pas d'ISO 7380 M6 acier chez TME
Visserie & fixations | M00613 | JamNut DIN439B M8 | 18 | acheter | Motedis (motedis.fr) | Écrou DIN 439 forme B M8, acier 04 zingué (réf. DIN439-ZN-M8), lot de 10 | https://www.motedis.fr/fr/Ecrou-DIN-439-M4-M5-M6-M8-M10-and-M12/DIN-439-x-M8 | 0.40 | 2 | 0.80 | vérifié | chiffre | Motedis : prix TTC 20 % lu sur la fiche (compteur déstockage 0/0, donc prix normal) ; stock affiché en JavaScript, non lisible : à confirmer au panier
Visserie & fixations | M00627 | Lock Nut DIN985 M10 | 2 | acheter | Motedis (motedis.fr) | Écrou frein nylon DIN 985 M10, classe 8 zingué (réf. DIN985-ZN-M10), lot de 10 | https://www.motedis.fr/fr/Ecrou-DIN-985-M6-M8-and-M12/DIN-985-x-M10 | 1.47 | 1 | 1.47 | vérifié | chiffre | Motedis : prix TTC 20 % lu sur la fiche (compteur déstockage 0/0, donc prix normal) ; stock affiché en JavaScript, non lisible : à confirmer au panier
Visserie & fixations | M00629 | Lock Nut DIN985 M4 | 24 | acheter | Motedis (motedis.fr) | Écrou frein nylon DIN 985 M4, classe 8 zingué (réf. DIN985-ZN-M4), lot de 10 | https://www.motedis.fr/fr/Ecrou-DIN-985-M6-M8-and-M12/DIN-985-x-M4 | 0.27 | 3 | 0.81 | vérifié | chiffre | Motedis : prix TTC 20 % lu sur la fiche (compteur déstockage 0/0, donc prix normal) ; stock affiché en JavaScript, non lisible : à confirmer au panier
Visserie & fixations | M00632 | Lock Nut DIN985 M5 | 20 | acheter | Motedis (motedis.fr) | Écrou frein nylon DIN 985 M5, classe 8 zingué (réf. DIN985-ZN-M5), lot de 10 | https://www.motedis.fr/fr/Ecrou-DIN-985-M6-M8-and-M12/DIN-985-x-M5 | 0.27 | 2 | 0.54 | vérifié | chiffre | Motedis : prix TTC 20 % lu sur la fiche (compteur déstockage 0/0, donc prix normal) ; stock affiché en JavaScript, non lisible : à confirmer au panier
Visserie & fixations | M00630 | Lock Nut DIN985 M6 | 14 | acheter | Motedis (motedis.fr) | Écrou frein nylon DIN 985 M6, classe 8 zingué (réf. DIN985-ZN-M6), lot de 10 | https://www.motedis.fr/fr/Ecrou-DIN-985-M6-M8-and-M12/DIN-985-x-M6 | 0.40 | 2 | 0.80 | vérifié | chiffre | Motedis : prix TTC 20 % lu sur la fiche (compteur déstockage 0/0, donc prix normal) ; stock affiché en JavaScript, non lisible : à confirmer au panier
Visserie & fixations | M00631 | Lock Nut DIN985 M8 | 2 | acheter | Motedis (motedis.fr) | Écrou frein nylon DIN 985 M8, classe 8 zingué (réf. DIN985-ZN-M8), lot de 10 | https://www.motedis.fr/fr/Ecrou-DIN-985-M6-M8-and-M12/DIN-985-x-M8 | 0.53 | 1 | 0.53 | vérifié | chiffre | Motedis : prix TTC 20 % lu sur la fiche (compteur déstockage 0/0, donc prix normal) ; stock affiché en JavaScript, non lisible : à confirmer au panier
Visserie & fixations | M01702 | Nut DIN934 M4 | 28 | acheter | Motedis (motedis.fr) | Écrou hexagonal DIN 934 M4, classe 8 zingué (réf. DIN934-ZN-M4), lot de 10 | https://www.motedis.fr/fr/Ecrou-DIN-934-M4-M5-M6-M8-M10-and-M12/DIN-934-x-M4 | 0.27 | 3 | 0.81 | vérifié | chiffre | Motedis : prix TTC 20 % lu sur la fiche (compteur déstockage 0/0, donc prix normal) ; stock affiché en JavaScript, non lisible : à confirmer au panier
Visserie & fixations | M00745 | Rubber Bump M8x68 | 6 | acheter | TME (tme.eu/fr, Pologne, UE) | Elesa+Ganter DVA.4-30-20-M8-20-55 : butée/pied caoutchouc Ø30 x 20, goujon acier M8 x 20, 55 Shore | https://www.tme.eu/fr/details/dva4-30-20-m8/jambes/elesa-ganter/dva-4-30-20-m8-20-55/ | 1.84 | 6 | 11.04 | vérifié | chiffre | TME : prix « brut » = TTC TVA FR 20 % (net x1,20), lu sur la fiche : 1,84 €/pc de 1 à 9 pièces ; stock 48. Dimension « M8x68 » de la nomenclature non élucidée : Ø30 x 20 + goujon 20 = 40 mm hors tout, à valider (gamme DVA.4 M8 de 15 à 40 mm de haut)
Visserie & fixations | M00746 | Rubber foot M4 | 10 | acheter | TME (tme.eu/fr, Pologne, UE) | Elesa+Ganter DVA.4-15-15-M4-10-55 : pied caoutchouc Ø15 x 15, goujon acier M4 x 10 | https://www.tme.eu/fr/details/dva4-15-15-m4/jambes/elesa-ganter/dva-4-15-15-m4-10-55/ | 0.63 | 10 | 6.30 | vérifié | chiffre | TME : prix « brut » = TTC TVA FR 20 % (net x1,20), lu sur la fiche : 0,63 €/pc au palier 10 ; stock 68. Le modèle Ø15 x 10 est retiré de l'offre TME, d'où 15 mm de haut
Visserie & fixations | M00795 | Spacer M5x19mm | 8 | acheter | Motedis (motedis.fr) | Douille de distance pour vis M5, L 20 mm (pas de 19 mm), acier zingué, Ø 5,4 / 7 (réf. 5334), lot de 10 | https://www.motedis.fr/fr/Douille-de-distance-pour-vis-M5-avec-L-20-mm | 2.93 | 1 | 2.93 | estimation | chiffre | Prix lu (2,93 € TTC le lot de 10) mais longueur NON conforme : 19 mm introuvable chez Motedis et TME (DREMEC 3810/5.2 : 18 ou 20 mm). Ramener à 19 mm à la lime ou au tour, ou valider 20 mm sur le plan
Visserie & fixations | M00796 | Spacer M5x30mm | 12 | acheter | Motedis (motedis.fr) | Douille de distance pour vis M5, L 30 mm, acier zingué, Ø int. 5,4 / ext. 7 (réf. 5343), lot de 10 | https://www.motedis.fr/fr/Douille-de-distance-pour-vis-M5-avec-L-30-mm | 1.60 | 2 | 3.20 | vérifié | chiffre | Motedis : prix TTC 20 % lu sur la fiche (compteur déstockage 0/0, donc prix normal) ; stock affiché en JavaScript, non lisible : à confirmer au panier
Visserie & fixations | M00798 | Spacer M5x6mm | 2 | acheter | Motedis (motedis.fr) | Douille de distance pour vis M5, L 6 mm, acier zingué, Ø int. 5,4 / ext. 7 (réf. 5340), lot de 10 | https://www.motedis.fr/fr/Douille-de-distance-pour-vis-M5-avec-L-6-mm | 1.33 | 1 | 1.33 | vérifié | chiffre | Motedis : prix TTC 20 % lu sur la fiche (compteur déstockage 0/0, donc prix normal) ; stock affiché en JavaScript, non lisible : à confirmer au panier. Alésage 5,4 mm au lieu de 5,2 (jeu un peu plus grand, sans effet pour une vis M5)
Visserie & fixations | M00800 | Spacer M6x90mm | 2 | acheter | Motedis (motedis.fr) | Empilage de 2 douilles d'écartement rondes acier zingué DIN N0370 : M6x40 + M6x50 (lots de 20 chacun) | https://www.motedis.fr/fr/Douille-decartement-DIN-N0370-M6x40 | 14.40 | 1 | 14.40 | estimation | chiffre | Prix lus sur les deux fiches, mais montage NON conforme : aucune entretoise lisse M6 de 90 mm trouvée (Motedis, TME). Diamètres de la N0370 non indiqués sur la page. Alternative : tube alu 12x2 ou 10x1 coupé à 90 mm
Visserie & fixations | M00837 | TFHC M4x35 Black screw | 4 | acheter | Motedis (motedis.fr) | Vis tête fraisée six pans creux DIN 7991 / ISO 10642 M4x35, 8.8 zinguée (réf. DIN7991-vz-M4x35), sachet de 100 | https://www.motedis.fr/fr/Vis-a-tete-fraisee-a-six-pans-creux-selon-DIN-7991/M4x35 | 16.00 | 1 | 16.00 | vérifié | chiffre | Motedis : prix TTC 20 % lu sur la fiche (compteur déstockage 0/0, donc prix normal) ; stock affiché en JavaScript, non lisible : à confirmer au panier. Classe 8.8 zinguée (l'actuelle Wegertseder est en 10.9 brut). Pas de M4x35 fraisée acier trouvée chez TME
Broche / Spindle |  | Broche 2,2 kW refroidie air, ER20, 6000-24000 tr/min, 220 V | 1 | acheter | Déjà possédé | Affleureuse Makita (déjà possédée) à la place du kit broche + VFD |  | 0.00 | 0 | 0.00 | vérifié | chiffre | Hors BOM upstream : vendue avec le pack. Doit correspondre au variateur 220 V.; Hypothèse : Makita RT0701C/RT0702C (710 W, 10 000-30 000 tr/min, corps Ø65 mm, pinces 6 et 8 mm). Vitesse réglée à la molette (pas de M3 S…). Le kit broche + VFD reste l'évolution prévue (≈145 € de plus).
Broche / Spindle |  | Jeu de pinces ER20 (1-13 mm) | 1 | acheter | Déjà possédé | Pinces Makita d'origine (6/8 mm) |  | 0.00 | 0 | 0.00 | vérifié | chiffre | Hors BOM upstream.; Pas de pinces ER20 avec la Makita. Une pince 6 mm Makita d'origine coûte une dizaine d'euros si elle manque.
Broche / Spindle |  | Support de broche Ø80 mm | 1 | acheter | AliExpress / Amazon | Support de fraiseuse alu Ø65 mm à serrage |  | 19.83 | 1 | 19.83 | estimation | chiffre | A verifier dans le STEP (Spindle plate) : diametre et entraxe des trous.; Pour la Makita. Choisir un collier dont l'alésage fait vraiment 65 mm (certains font 65,25 mm et serrent mal). Percer la spindle plate (DXF) aux trous de ce support avant découpe, en gardant si possible le perçage Ø80 pour la broche plus tard.
Divers | M01729 | Dust Filter Mesh ("M"), 7cmx7cmx0.375mm, 0.5mm aperture | 1 | acheter | AliExpress | Découpé dans la feuille de toile inox (ligne M01533) | https://www.aliexpress.com/w/wholesale-stainless-steel-mesh-sheet-0.5mm.html | 0.00 | 0 | 0.00 | estimation | chiffre | Inclus dans la feuille achetée sur la ligne M01533
Divers | M01533 | Dust Filter Mesh, 13cmx20cmx0.375mm, 0.5mm aperture | 2 | acheter | AliExpress | Toile inox ouverture 0,5 mm, feuille 30×30 cm | https://www.aliexpress.com/w/wholesale-stainless-steel-mesh-sheet-0.5mm.html | 6.94 | 1 | 6.94 | estimation | chiffre | Une feuille suffit pour 2×(13×20 cm) + 7×7 cm
Divers | M00823 | Square Plate - First CNC Test | 1 | acheter | Achat local (bricolage / grossiste électrique) | Chute de MDF ou contreplaqué ~300 x 300 mm |  | 2.98 | 1 | 2.98 | estimation | chiffre | Chute pour le premier essai, quelques euros.
Frais de port |  | Frais de port Dold Mechatronik | 1 |  | Dold Mechatronik (aluprofile-express.de) |  |  |  |  | 108.99 | estimation | chiffre | Barème lu : GLS ≤ 2 m, 109,90 € jusqu'à 120 kg (89,90 € jusqu'à 90 kg). Poids estimé ~92 kg (79 kg de profilés + ~13 kg d'accessoires et d'emballage). Pièces de 1530 mm > 1,5 m, donc GLS. Montant final calculé au panier, peut-être moins cher en scindant les colis.
Frais de port |  | Frais de port Motedis | 1 |  | Motedis |  |  |  |  | 0.00 | estimation | chiffre | Barème BE : accessoires seuls gratuits au-delà de 27,77 € (commande ~81 €). Si les chaînes ne comptent pas comme accessoires : ~18,66 € HT + 4,44 € d'emballage, soit ~28 € TTC.
Frais de port |  | Frais de port Bits and Parts | 1 |  | Bits and Parts (bitsandparts.nl) |  |  |  |  | 7.88 | estimation | chiffre | Tarif BE non affiché (NL : 3,95-5,95 €) ; ~8 € estimés.
Frais de port |  | Frais de port Achat local (bricolage / grossiste électrique) | 1 |  | Achat local (bricolage / grossiste électrique) |  |  |  |  | 0.00 | estimation | chiffre | Retrait en magasin, pas de port.
Frais de port |  | Frais de port Découpe laser (avec le lot acier) | 1 |  | Découpe laser (avec le lot acier) |  |  |  |  | 0.00 | estimation | chiffre | Envoi compris dans celui du lot acier.
Frais de port |  | Frais de port Dold Mechatronik | 1 |  | Dold Mechatronik |  |  |  |  | 58.41 | vérifié | chiffre | Grille Dold « Paketdienst nach Österreich, Frankreich und BeNeLux », GLS jusqu'à 2 m, jusqu'à 60 kg : 58,90 €. Poids estimé ≈ 53 kg (rails ≈ 21 kg, crémaillères ≈ 23 kg, patins ≈ 4,5 kg, reste ≈ 4 kg). Les rails de 1500 mm excluent DPD (limité à 1,5 m). Le tarif exact n'apparaît qu'au panier.
Frais de port |  | Frais de port AliExpress | 1 |  | AliExpress (vendeur entrepôt UE si dispo) |  |  |  |  | 19.83 | estimation | chiffre | Estimation : port souvent offert pour les entrepôts UE ou au-delà d'environ 10 € par vendeur ; prévoir ≈ 20 € au total pour plusieurs vendeurs, dont l'envoi long de la vis de 1,5 m.
Frais de port |  | Frais de port StepperOnline (entrepôt DE) | 1 |  | StepperOnline (entrepôt DE) |  |  |  |  | 52.00 | estimation | chiffre | Lu au panier pour les 3 kits NEMA 34 : 45,85 € DHL + 1,73 € d'emballage. Compté ~52 € avec le kit NEMA 23 et les rallonges.
Frais de port |  | Frais de port PlanetCNC | 1 |  | PlanetCNC (planet-cnc.com) |  |  |  |  | 14.88 | estimation | chiffre | Frais non publiés, calculés au panier
Frais de port |  | Frais de port Reichelt | 1 |  | Reichelt (reichelt.com/be) |  |  |  |  | 6.89 | estimation | chiffre | Tarif standard habituel, non revérifié
Frais de port |  | Frais de port AliExpress | 1 |  | AliExpress |  |  |  |  | 9.92 | estimation | chiffre | Provision pour les vendeurs qui facturent la livraison
Frais de port |  | Frais de port JLCPCB | 1 |  | JLCPCB |  |  |  |  | 7.93 | estimation | chiffre | Environ 7,90 € constaté début 2026 sur un forum
Frais de port |  | Frais de port Wegertseder | 1 |  | Wegertseder (wegertseder.com, DE) |  |  |  |  | 0.00 | vérifié | chiffre | Toute la visserie est passée chez TME et Motedis.fr : Wegertseder ne livre pas tous les particuliers hors DE/AT.
Frais de port |  | Frais de port AliExpress (ou Amazon) | 1 |  | AliExpress (ou Amazon), assortiment |  |  |  |  | 0.00 | vérifié | chiffre | Entretoises et caoutchoucs repris chez TME et Motedis.fr.
Frais de port |  | Frais de port découpe laser acier | 1 |  | Découpe laser en ligne (Laserboost / Fractory / Xometry) - devis à faire |  |  |  |  | 44.63 | estimation | chiffre | Estimation : ~50 kg en 2-3 colis depuis l'Espagne/UE vers BE/FR, fourchette 30-75 €.
Frais de port |  | Frais de port découpe laser bois/acrylique | 1 |  | Découpe laser bois/acrylique en ligne (Snijlab NL / Formulor DE) |  |  |  |  | 9.87 | estimation | chiffre | Estimation colis plat NL/DE -> BE/FR. Nul si fablab.
Moteurs & electronique |  | Ventilateur actif Raspberry Pi 5 | 1 | acheter | Reichelt / Kubii | Raspberry Pi Active Cooler officiel |  | 5.95 | 1 | 5.95 | estimation | chiffre | Le Pi 5 chauffe plus que le Pi 4 ; recommandé dans le boîtier fermé.
Cablage & connectique |  | Prise de façade 2P+T pour la Makita | 1 | acheter | Reichelt / Conrad | Prise encastrable 2P+T 16 A 250 V type E (française), montage panneau |  | 8.00 | 1 | 8.00 | estimation | chiffre | Montée sur le boîtier de commande, paroi du fond (perçage à la scie cloche, diamètre selon la prise). Chaîne : contacteur d'arrêt d'urgence → relais 25 A (bobine 24 V, commandée par le module relais 5 V piloté par OUT1 de PlanetCNC) → cette prise. Voir docs/plan-cablage.md.
Frais de port |  | Frais de port DamenCNC | 1 |  | DamenCNC (Pays-Bas) |  |  |  |  | 126.00 | estimation | chiffre | DamenCNC ne publie pas sa grille. Supplément « long item » de 40 € HT lu sur la page, compté par barre par prudence (2 × 40 €), plus ~25 € HT d'envoi vers la France (colis hors format > 1,75 m), ×1,20. Si le supplément est par commande, compter ~78 €. Demander un devis de port avant de commander.
Frais de port |  | Frais de port Sorotec | 1 |  | Sorotec |  |  |  |  | 30.40 | vérifié | chiffre | Grille Sorotec lue pour FR : 8,97 / 13,01 / 19,06 / 27,13 / 30,15 € TTC DE ; colis ~28 kg → 30,15 €, recalculé à 20 %. Vérifier au panier s'il y a un supplément pour les rails de 1,5 m.
Frais de port |  | Frais de port TME vers la France | 1 |  | TME (tme.eu/fr, Pologne, UE) |  |  |  |  | 7.08 | vérifié | chiffre | Barème lu : 5,90 € net / 7,08 € brut jusqu'à 15 kg (colis visserie ~3 kg), 2-4 jours ouvrés. Aucun franco ni minimum de commande indiqué. TME vend aux consommateurs (CGV consommateurs en français, droit de rétractation) ; prix « brut » = TVA FR 20 %
Frais de port |  | Frais de port Motedis vers la France | 1 |  | Motedis (motedis.fr) |  |  |  |  | 0.00 | vérifié | chiffre | Barème France lu : accessoires seuls 7,72 € jusqu'à 27,77 €, gratuit au-delà (sous-total Motedis ici > 100 €). Port partagé avec la commande Motedis déjà prévue (chaînes porte-câbles + pieds). Seuils probablement HT. Pas de livraison îles ni casiers
Frais de port |  | Frais de port Amazon.fr (rondelles colorées, optionnel) | 1 |  | Amazon.fr (optionnel, décoratif) |  |  |  |  | 3.99 | estimation | chiffre | Non vérifié : gratuit avec Prime ou dès 35 € d'achat éligible, sinon ~3-5 €. Ligne à supprimer si les rondelles colorées sont abandonnées ou remplacées
Moteurs & electronique |  | Alimentation 48 V pour le driver Z | 1 | acheter | Audiophonics (Bordeaux) | Mean Well LRS-350-48 (48 V, 7,3 A, 350 W) | https://www.audiophonics.fr/fr/alimentations-smps/mean-well-lrs-350-48-module-d-alimentation-a-decoupage-smps-48v-73a-350w-p-12170.html | 39.90 | 1 | 39.90 | vérifié | chiffre | Le driver CL57T monte à 48 V au maximum. Règle du même coup le point « NEMA 23 sous 72 V » : le moteur Z a sa tension nominale. Entrée 230 V derrière le même contacteur d'arrêt d'urgence que l'alimentation 72 V.
Cablage & connectique |  | Rallonges de câble codeur (boucle fermée) | 4 | acheter | StepperOnline (entrepôt DE) | Rallonge de câble codeur pour kits CL86T/CL57T, 3 à 5 m selon l'axe | https://www.omc-stepperonline.com/fr/ | 12.00 | 4 | 48.00 | estimation | chiffre | Les kits n'ont que 1,7 m de câble moteur et codeur. Les câbles moteur blindés de la nomenclature restent ; il faut en plus amener le codeur jusqu'à l'armoire, dans les chaînes porte-câbles. Choisir une rallonge prévue pour chaîne (flexion continue) ou du câble blindé 6 conducteurs + connecteurs. Prix non relevé.
Frais de port |  | Frais de port Audiophonics (Bordeaux) | 1 |  | Audiophonics (Bordeaux) |  |  |  |  | 6.90 | estimation | chiffre | Port offert dès 149 € ; pour l'alimentation seule, tarif non relevé.
Divers |  | Martyr : panneaux MDF 18 mm 250×122 cm | 2 | acheter | Leroy Merlin (retrait en magasin) | Panneau MDF 18 mm 2500×1220 mm (réf. 69130586) |  | 49.90 | 2 | 99.80 | estimation | chiffre | Un panneau de base vissé sur la table + un martyr surfacé par la machine. Les enseignes ne vendent pas de 19 mm, et 1220 mm couvre 1220 des 1250 mm de course X : pour tout couvrir, MDF 19 mm 2800×2070 chez un négoce bois (sur devis). Prix lu dans un extrait de recherche, à confirmer en magasin.
Divers |  | Inserts filetés acier M8 pour brides (martyr) | 50 | acheter | Quincaillerie / négoce (Rampa SKD acier ou équivalent) | Inserts à visser acier zingué M8, pour bois et MDF |  | 0.70 | 50 | 35.00 | estimation | chiffre | Acier plutôt que zamak : les brides de serrage y sont serrées et desserrées très souvent. Prix non relevé (Hranipex demande un compte).
Capteurs & securite |  | Contacteur de puissance (arrêt d'urgence) | 1 | acheter | Reichelt / RS / Conrad | Contacteur modulaire rail DIN 25 A, bobine 24 V CC, 4 contacts NO (ex. Finder série 22 en 24 V CC) |  | 50.00 | 1 | 50.00 | estimation | chiffre | Bobine 24 V CC et non 230 V : le bouton d'arrêt d'urgence est déporté au bout d'un câble, qui reste ainsi en très basse tension. Après le disjoncteur : coupe l'alimentation 72 V, l'alimentation 48 V et le relais de la Makita. 2 contacts pour phase et neutre, 1 pour l'auto-maintien, 1 de réserve. L'alimentation 24 V reste hors contacteur. Vérifier que la bobine consomme moins de 5 W (alimentation 24 V de 60 W). Prix non relevé.
Capteurs & securite |  | Bouton marche vert 1 NO (réarmement du contacteur) | 1 | acheter | Reichelt / RS / Conrad | Bouton poussoir Ø22 Schneider Harmony XB5, vert, 1 NO |  | 12.00 | 1 | 12.00 | estimation | chiffre | Après un arrêt d'urgence ou une coupure secteur, la puissance ne revient qu'en appuyant sur ce bouton (auto-maintien du contacteur) : pas de redémarrage surprise. Prix non relevé.
Cablage & connectique |  | Rail DIN 35 mm (contacteur et relais) | 1 | acheter | Reichelt / RS / Conrad | Rail DIN 35×7,5 mm perforé, 30 cm |  | 5.00 | 1 | 5.00 | estimation | chiffre | Dans le boîtier de commande.
Moteurs & electronique |  | Relais de puissance 25 A pour la Makita | 1 | acheter | Reichelt / RS / Conrad | Relais de puissance modulaire rail DIN 25 A, bobine 24 V CC (ex. Finder 22.32 24 V), 2 NO |  | 38.00 | 1 | 38.00 | estimation | chiffre | Le module relais 5 V d'origine (M00010, piloté par la sortie broche de PlanetCNC) ne doit pas couper le secteur d'un moteur universel de 710 W : ses contacts risquent de coller au courant d'appel. Il commande donc la bobine 24 V de ce relais 25 A, qui alimente la prise de la Makita en aval du contacteur d'arrêt d'urgence. Prix non relevé.
Cablage & connectique |  | Câble d'arrêt d'urgence 4 × 0,5 mm², 5 m | 1 | acheter | Reichelt / Conrad | Câble souple 4 conducteurs 0,5 mm² (LiYY ou H05VV-F), 5 m |  | 6.00 | 1 | 6.00 | estimation | chiffre | 2 conducteurs pour la boucle 24 V de la bobine du contacteur, 2 pour l'entrée E-Stop de PlanetCNC. Se termine par les deux fiches GX12 2 broches déjà comptées (E-Stop et Input 3). Prix non relevé.
Cablage & connectique |  | Presse-étoupes PG9 pour les câbles codeur | 4 | acheter | Reichelt / Conrad | Presse-étoupe PG9 polyamide avec écrou, câble Ø4 à 8 mm |  | 0.75 | 4 | 3.00 | estimation | chiffre | Entrée des 4 câbles codeur dans le boîtier de commande, perçage Ø16 environ. Prix non relevé.
Gestion des cables |  | Chaîne porte-câbles : 4e sachet de 1 m | 1 | acheter | Motedis | Chaîne porte-câbles CK 24 largeur 60 mm, 1 sachet de 24 maillons (1 m) | https://www.motedis.be/fr/Chaine-porte-cables-CK-24-1-sachet-24-maillons-longueur-1m | 19.77 | 1 | 19.77 | vérifié | chiffre | Le guide officiel monte la chaîne Y en 1500 + 400 = 1900 mm, et non 1800 mm comme la nomenclature. Avec la chaîne X de 1200 mm, il faut 3,1 m : les 3 sachets déjà comptés ne suffisent pas.
