wprod/fab-diy/bom/chiffrage/lot-K-cablage.csv

ref_mekanika | designation | quantite_bom | fournisseur | produit | lien | prix_unitaire_ttc_eur | unite_achat | quantite_achat | total_ttc_eur | confiance | notes | categorie | tva_pays
AJOUT | Contacteur de puissance (arrêt d'urgence) | 1 | Reichelt / RS / Conrad | Contacteur modulaire rail DIN 25 A, bobine 24 V CC, 4 contacts NO (ex. Finder série 22 en 24 V CC) |  | 50.0 | pièce | 1 | 50.0 | estimation | Bobine 24 V CC et non 230 V : le bouton d'arrêt d'urgence est déporté au bout d'un câble, qui reste ainsi en très basse tension. Après le disjoncteur : coupe l'alimentation 72 V, l'alimentation 48 V et le relais de la Makita. 2 contacts pour phase et neutre, 1 pour l'auto-maintien, 1 de réserve. L'alimentation 24 V reste hors contacteur. Vérifier que la bobine consomme moins de 5 W (alimentation 24 V de 60 W). Prix non relevé. | Capteurs & securite | FR
AJOUT | Prise de façade 2P+T pour la Makita | 1 | Reichelt / Conrad | Prise encastrable 2P+T 16 A 250 V type E (française), montage panneau |  | 8 | pièce | 1 | 8 | estimation | Montée sur le boîtier de commande, paroi du fond (perçage à la scie cloche, diamètre selon la prise). Chaîne : contacteur d'arrêt d'urgence → relais 25 A (bobine 24 V, commandée par le module relais 5 V piloté par OUT1 de PlanetCNC) → cette prise. Voir docs/plan-cablage.md. | Cablage & connectique | FR
AJOUT | Câble d'arrêt d'urgence 4 × 0,5 mm², 5 m | 1 | Reichelt / Conrad | Câble souple 4 conducteurs 0,5 mm² (LiYY ou H05VV-F), 5 m |  | 6.0 | pièce | 1 | 6.0 | estimation | 2 conducteurs pour la boucle 24 V de la bobine du contacteur, 2 pour l'entrée E-Stop de PlanetCNC. Se termine par les deux fiches GX12 2 broches déjà comptées (E-Stop et Input 3). Prix non relevé. | Cablage & connectique | FR
AJOUT | Presse-étoupes PG9 pour les câbles codeur | 4 | Reichelt / Conrad | Presse-étoupe PG9 polyamide avec écrou, câble Ø4 à 8 mm |  | 0.75 | pièce | 4 | 3.0 | estimation | Entrée des 4 câbles codeur dans le boîtier de commande, perçage Ø16 environ. Prix non relevé. | Cablage & connectique | FR
M00355 | CNC Pro/Fab - Steel Parts - VFD Base | 1 | — | Reporté : pas de boîtier VFD tant que la Makita sert de broche |  | 0 | pièce | 0 | 0 | estimation | Le relais et la prise de la Makita sont dans le boîtier de commande. À découper le jour où la broche 2,2 kW et son variateur remplacent l'affleureuse (~39 € estimés). |  | FR
M00356 | CNC Pro/Fab - Steel Parts - VFD Cover | 1 | — | Reporté : pas de boîtier VFD tant que la Makita sert de broche |  | 0 | pièce | 0 | 0 | estimation | Voir VFD Base (~24 € estimés). |  | FR
M00720 | Panel Mount IEC C14 Connector with RFI Filter, 15A 250V | 1 | — | Reporté avec le boîtier VFD |  | 0 | pièce | 0 | 0 | estimation | Embase d'entrée du boîtier VFD (~8 €). |  | FR
M01379 | CU-VFD-Mounting plate 3mm | 4 | — | Facultatif : le boîtier se pose à plat sur les deux traverses basses avant |  | 0 | pièce | 0 | 0 | estimation | Le guide officiel décrit deux montages. L'ancien, qui correspond au modèle 3D de ce dépôt, pose le boîtier à plat sur les deux traverses basses avant, sans patte. Le nouveau (machines livrées depuis mars 2026) le suspend à la verticale sur 4 pattes à encoche, dont la géométrie n'est pas publiée. Une patte de blocage facultative est dessinée dans cad/steel/diy (~10 € les 4). Voir docs/pieces-acier.md. |  | FR
M00966 | CNC Fab - Mounting gauge MDF (Frame) | 2 | — | À couper soi-même : 2 barres de MDF 18 mm, 322,5 mm de long (chute du martyr) |  | 0 | pièce | 0 | 0 | estimation | Vu dans le guide officiel : une barre qui cale l'écart entre deux traverses de table. Écart mesuré dans le STEP : 322,5 mm, identique partout. L'épaisseur de 18 mm sert aussi de cale pour aligner la poulie moteur. Voir docs/notes-de-montage.md. |  | FR
M00967 | CNC Fab - Mounting gauge Plywood (Rails) | 1 | — | Remplacé par une mesure : dessus du rail à 35,0 mm sous le dessus du profilé 30×120 |  | 0 | pièce | 0 | 0 | estimation | Le gabarit officiel se glisse sous le rail pendant le serrage ; sa géométrie n'est pas publiée. Cote relevée dans le STEP. Une cale de 35 mm ou la jauge de profondeur d'un pied à coulisse fait le même travail. Voir docs/notes-de-montage.md. |  | FR
AJOUT | Chaîne porte-câbles : 4e sachet de 1 m | 1 | Motedis | Chaîne porte-câbles CK 24 largeur 60 mm, 1 sachet de 24 maillons (1 m) | https://www.motedis.be/fr/Chaine-porte-cables-CK-24-1-sachet-24-maillons-longueur-1m | 19.93 | sachet | 1 | 19.93 | vérifié | Le guide officiel monte la chaîne Y en 1500 + 400 = 1900 mm, et non 1800 mm comme la nomenclature. Avec la chaîne X de 1200 mm, il faut 3,1 m : les 3 sachets déjà comptés ne suffisent pas. | Gestion des cables | BE
