wprod/fab-diy/bom/commandes/decoupe-laser-bois-acrylique-en-ligne-snijlab-nl-formulor-de.csv

ref_mekanika | designation | produit | quantite_achat | prix_unitaire_ttc_eur | total_ttc_eur | confiance | lien | notes
M00716 | PMMA Sheet 3mm 600x400mm, Light Blue | Gabarit PMMA 3 mm bleu clair 60x60 mm (DXF 'FAB Mounting Gauge.dxf') | 1 | 3.97 | 3.97 | estimation | https://www.snijlab.nl | 0,02 plaque 600x400 = pièce de 60x60 mm (~0,4 m de découpe, DXF dans upstream/fab/cad). Estimation avec minimum par pièce. Option matière seule : chute PMMA 3 mm ~1-2 € (plaque entière 600x400 ~13 €, soit 0,26 € au prorata).
 | Frais de port découpe laser bois/acrylique |  |  |  | 9.87 | estimation |  | Estimation colis plat NL/DE -> BE/FR. Nul si fablab.
