wprod/fab-diy/bom/commandes/motedis.csv

ref_mekanika | designation | produit | quantite_achat | prix_unitaire_ttc_eur | total_ttc_eur | confiance | lien | notes
M00391 | Cable chain TEZ25.50K 1200mm | Chaîne porte-câbles CK 24 largeur 60 mm (24 x 60 int.), sachets 1 m + 1 paire d'éléments de connexion | 1 | 27.22 | 27.22 | vérifié | https://www.motedis.be/fr/Chaine-porte-cables-CK-24-1-sachet-24-maillons-longueur-1m | 3 sachets de 1 m à 19,93 € TTC pour les deux chaînes (1,2 + 1,8 = 3,0 m), répartis au prorata, + 1 paire d'embouts à 3,53 €. Pas de 25x50 chez Motedis : 24x60 int., encombrement et entraxe des embouts à vérifier sur les supports de chaîne acier.
M00392 | Cable chain TEZ25.50K 1800mm | Chaîne porte-câbles CK 24 largeur 60 mm (24 x 60 int.), sachets 1 m + 1 paire d'éléments de connexion | 1 | 39.07 | 39.07 | vérifié | https://www.motedis.be/fr/Chaine-porte-cables-CK-24-1-sachet-24-maillons-longueur-1m | Voir M00391 : 1,8 m pris sur les 3 sachets de 1 m (19,93 € TTC) + 1 paire d'embouts 3,53 €. Même réserve 24x60 vs 25x50.
 | Chaîne porte-câbles : 4e sachet de 1 m | Chaîne porte-câbles CK 24 largeur 60 mm, 1 sachet de 24 maillons (1 m) | 1 | 19.77 | 19.77 | vérifié | https://www.motedis.be/fr/Chaine-porte-cables-CK-24-1-sachet-24-maillons-longueur-1m | Le guide officiel monte la chaîne Y en 1500 + 400 = 1900 mm, et non 1800 mm comme la nomenclature. Avec la chaîne X de 1200 mm, il faut 3,1 m : les 3 sachets déjà comptés ne suffisent pas.
M00524 | Foot D80 M12x50 + Jam nut M12 + Anti Slip | Pieds réglables D80 M12 L50, embase PA66, capuchon amortisseur + écrou inclus (réf. BD80-12x50), lot de 4 | 2 | 6.93 | 13.86 | vérifié | https://www.motedis.be/fr/Pieds-reglables-D80-M12-L50 | 6,99 € TTC BE le lot de 4 : 2 lots = 8 pieds pour 6 nécessaires. Page : « Stock actuellement insuffisant ». Pas de pied D80 M12 trouvé chez Dold.
