wprod/fab-diy/bom/commandes/achat-local-bricolage-grossiste-electrique.csv

ref_mekanika | designation | produit | quantite_achat | prix_unitaire_ttc_eur | total_ttc_eur | confiance | lien | notes
M00947 | Brush FBL0706 20mm (m) | Bande brosse à talon alu, poils 20 mm, au mètre (bas de porte à brosse ou brossier) | 1 | 8.83 | 8.83 | estimation |  | Réf. FBL0706 introuvable ; ~9 €/m constaté pour une bande brosse 1 m (annonce eBay.de type 5). Vendue au mètre : 1 m pour 0,5 m utile.
M00948 | Brush FBL0706 30mm (m) | Bande brosse à talon alu, poils 30 mm, au mètre | 6 | 9.82 | 58.91 | estimation |  | Réf. FBL0706 introuvable ; prix moyen estimé d'une bande brosse alu 30 mm (8,90-12 €/m). 4 tronçons de 1,5 m.
M00956 | Cable Trunking D31mm L500mm | Goulotte flexible fendue à visser 30 mm (31 x 33), L 500 mm, ex. Hager VK flex M5692 | 3 | 7.93 | 23.80 | estimation | https://hager.com/fr-be/catalogue/produits/m5692-goulot-vk-flex-30-500mm | Prix public non affiché chez Hager (conditionnement pro x40) ; ~6,7-9,5 € la pièce relevés sur d'autres sites Hager, d'où 8 € estimés au détail.
M00826 | FAB - Steel cable tray 3000mm (2x1500mm) | Chemin de câbles tôle perforée acier galvanisé 100 x 50 mm, longueur 3 m, à recouper en 2 x 1,5 m | 1 | 39.67 | 39.67 | estimation |  | Tarif pro Legrand P31 50x100 3 m ~40,92 € HT ; marques de négoce moins chères. Achat en magasin conseillé (3 m coûteux à expédier).
M00823 | Square Plate - First CNC Test | Chute de MDF ou contreplaqué ~300 x 300 mm | 1 | 2.98 | 2.98 | estimation |  | Chute pour le premier essai, quelques euros.
M00827 | Steel cable tray cantilever arm | Console / bras support pour chemin de câbles 100 mm | 2 | 5.95 | 11.90 | estimation |  | Prix courant d'une console simple 100 mm en acier galvanisé, non vérifié.
