wprod/fab-diy/bom/commandes/aliexpress-amazon.csv

ref_mekanika | designation | produit | quantite_achat | prix_unitaire_ttc_eur | total_ttc_eur | confiance | lien | notes
 | Support de broche Ø80 mm | Support de fraiseuse alu Ø65 mm à serrage | 1 | 19.83 | 19.83 | estimation |  | A verifier dans le STEP (Spindle plate) : diametre et entraxe des trous.; Pour la Makita. Choisir un collier dont l'alésage fait vraiment 65 mm (certains font 65,25 mm et serrent mal). Percer la spindle plate (DXF) aux trous de ce support avant découpe, en gardant si possible le perçage Ø80 pour la broche plus tard.
M00853 | USB-C 24V to 5V 3A converter | Convertisseur abaisseur 12/24 V → 5 V 5 A sortie USB-C | 1 | 9.92 | 9.92 | estimation |  | Le Pi 5 veut 5 V 5 A. Avec 3 A il démarre mais limite l'USB à 600 mA au total. Avec un module 5 A sans négociation PD, ajouter usb_max_current_enable=1 dans /boot/firmware/config.txt.
