wprod/fab-diy/bom/commandes/aliexpress-vendeur-entrepot-ue-si-dispo.csv

ref_mekanika | designation | produit | quantite_achat | prix_unitaire_ttc_eur | total_ttc_eur | confiance | lien | notes
M00080 | Ballscrew SFS1620 1500mm & nut | Vis à billes roulée C7 SFS1620, longueur 1500 mm sur mesure, extrémités usinées standard BK/FK12, avec écrou | 1 | 64.46 | 64.46 | estimation | https://fr.aliexpress.com/item/1005012349041890.html | Estimation : les pages produit AliExpress n'affichent pas le prix par variante. Une SFS1620 de 1500 mm usinée avec écrou se vend en général 55 à 75 € ; plusieurs annonces plafonnent à 1450 mm, donc vérifier que 1500 mm est proposé. Pas de kit retenu : les kits vis + paliers sont presque toujours livrés en BK12/BF12 (paliers à semelle), alors que le plan demande des FK12/FF12 à bride. L'usinage standard est le même pour BK12 et FK12 (Ø12 h, filetage M12x1, côté libre Ø10). Les FK12/FF12 et le boîtier 16H sont donc pris chez Dold (lignes M00511, M00512, M00704). Dold n'a pas d'équivalent compatible : sa SFS1620-DM 1542 mm (159 €) a un usinage « DM » prévu pour ses paliers 3200/6200 Ø10, non compatible FK12, et une longueur différente.
M00081 | Ballscrew SFU1605 250mm & Nut | Vis à billes roulée C7 SFU1605, longueur 250 mm sur mesure, extrémités usinées standard BK/FK12, avec écrou | 1 | 21.82 | 21.82 | estimation | https://fr.aliexpress.com/item/1005012349041890.html | Estimation : une SFU1605 courte, usinée avec écrou, coûte en général 17 à 25 € (prix d'appel des annonces à partir de 17 €). Chez Dold, l'option fiable la plus proche est la SFU1605-3 de 265 mm (59,50 € TTC DE, écrou compris, usinage standard), mais elle fait 15 mm de trop pour l'entraxe FK12/FF12 de l'axe Z.
M00411 | Compression Spring 14.5x9.6x1.6mm | Ressorts de compression fil 1,6 mm, Ø ext. ≈ 9,6 mm, longueur libre ≈ 14,5 mm (lot) | 1 | 4.96 | 4.96 | estimation | https://fr.aliexpress.com/w/wholesale-ressort-compression-1.6mm.html | Estimation : introuvable à l'unité dans ces cotes exactes chez Dold, Motedis ou dans le catalogue standard Gutekunst. Un lot de ressorts en fil de 1,6 mm coûte environ 5 € ; sinon Gutekunst Federn fait du sur mesure.
M00708 | Offset spacer 10x14x12mm | Entretoise acier/inox Ø int. 10, Ø ext. 14, L 12 mm (lot) | 1 | 3.97 | 3.97 | estimation | https://fr.aliexpress.com/w/wholesale-entretoise-acier-10x14.html | Estimation : entretoises tubulaires vendues par lots (≈ 3 à 6 €). On peut aussi les tourner dans un tube 14x2.
M01692 | Spacer - 12x18x18 | Entretoise acier/inox Ø int. 12, Ø ext. 18, L 18 mm (lot) | 1 | 3.97 | 3.97 | estimation | https://fr.aliexpress.com/w/wholesale-entretoise-acier-12x18.html | Estimation : entretoises par lots (≈ 3 à 6 €). On peut aussi les couper dans un tube acier 18x3.
M01691 | Spacer - 12x18x8 | Entretoise acier/inox Ø int. 12, Ø ext. 18, L 8 mm (lot) | 1 | 3.97 | 3.97 | estimation | https://fr.aliexpress.com/w/wholesale-entretoise-acier-12x18.html | Estimation : entretoises par lots (≈ 3 à 6 €).
M01690 | Spacer -12x16x3 | Entretoise / rondelle épaisse Ø int. 12, Ø ext. 16, ép. 3 mm (lot) | 1 | 3.97 | 3.97 | estimation | https://fr.aliexpress.com/w/wholesale-entretoise-acier-12x16.html | Estimation : rondelles d'appui ou entretoises par lots (≈ 3 à 5 €). On peut aussi empiler des bagues de calage DIN 988 12x18.
 | Frais de port AliExpress |  |  |  | 19.83 | estimation |  | Estimation : port souvent offert pour les entrepôts UE ou au-delà d'environ 10 € par vendeur ; prévoir ≈ 20 € au total pour plusieurs vendeurs, dont l'envoi long de la vis de 1,5 m.
