wprod/fab-diy/bom/commandes/audiophonics-bordeaux.csv

ref_mekanika | designation | produit | quantite_achat | prix_unitaire_ttc_eur | total_ttc_eur | confiance | lien | notes
 | Alimentation 48 V pour le driver Z | Mean Well LRS-350-48 (48 V, 7,3 A, 350 W) | 1 | 39.90 | 39.90 | vérifié | https://www.audiophonics.fr/fr/alimentations-smps/mean-well-lrs-350-48-module-d-alimentation-a-decoupage-smps-48v-73a-350w-p-12170.html | Le driver CL57T monte à 48 V au maximum. Règle du même coup le point « NEMA 23 sous 72 V » : le moteur Z a sa tension nominale. Entrée 230 V derrière le même contacteur d'arrêt d'urgence que l'alimentation 72 V.
 | Frais de port Audiophonics (Bordeaux) |  |  |  | 6.90 | estimation |  | Port offert dès 149 € ; pour l'alimentation seule, tarif non relevé.
