wprod/fab-diy/bom/commandes/bits-and-parts-bitsandparts-nl.csv

ref_mekanika | designation | produit | quantite_achat | prix_unitaire_ttc_eur | total_ttc_eur | confiance | lien | notes
M00882 | Wheel with Bearings for V-slot Profile - Type B | V-Slot wheel Creality/OpenBuilds noire, 625ZZ, Ø24 x 11 mm | 4 | 2.83 | 11.31 | vérifié | https://www.bitsandparts.nl/en/v-slot-wheel-for-creality-openbuilds-3d-printer-black-p1911592 | Prix TTC NL 21 % (= TVA BE). Correspond à la roue du STEP (Ø23,9 x 11 mm, type OpenBuilds Solid V).
 | Frais de port Bits and Parts |  |  |  | 7.88 | estimation |  | Tarif BE non affiché (NL : 3,95-5,95 €) ; ~8 € estimés.
