wprod/fab-diy/bom/commandes/dold-mechatronik-atelier-local.csv

ref_mekanika | designation | produit | quantite_achat | prix_unitaire_ttc_eur | total_ttc_eur | confiance | lien | notes
M00733 | Pulley HTD-5M 16mm 20 teeth | Poulie HTD-5M 20 dents acier BSY205M15-B-P14 (alésage 14 H7) + rainure de clavette 5 mm DIN 6885 brochée | 2 | 29.62 | 59.24 | estimation | https://www.dold-mechatronik.de/Toothed-belt-wheel-HTD-5M-15mm-wide-20-teeth-bore-14.00mm-H7-with-clamping-screws-steel | 14,62 € la poulie (Dold, vérifié) + ~15 € de brochage par poulie (estimation). Les arbres Ø14 des NEMA 34 sont clavetés : sans clavette, une poulie qui glisse sur l'arbre n'est pas vue par le codeur du moteur, et le portique se met de travers sans alarme. L'original utilisait des pièces clavetées.
