wprod/fab-diy/bom/commandes/dold-mechatronik.csv

ref_mekanika | designation | produit | quantite_achat | prix_unitaire_ttc_eur | total_ttc_eur | confiance | lien | notes
M00078 | Ball Bearing 6301-2RS 12x37x12mm | Rillenkugellager 6301 2RS 12x37x12 mm | 2 | 1.49 | 2.98 | vérifié | https://www.dold-mechatronik.de/Rillenkugellager-6301-2RS-12x37x12-mm | Prix lu TTC 19 % TVA DE (1.48 €), recalculé à 21 % TVA BE (vente à distance UE). Roulement générique, délai 8 à 9 jours ouvrés.
M00084 | Belt HTD-5M 15mm 475mm / 95 teeth | Zahnriemen geschlossen HTD-5M, largeur 15 mm, 475 mm / 95 dents (HTD-5M-15-475/95) | 2 | 7.26 | 14.52 | vérifié | https://www.dold-mechatronik.de/Toothed-belt-HTD-5M-closed,-width-15mm,-length-selectable | Prix lu TTC 19 % TVA DE (7.20 €), recalculé à 21 % TVA BE (vente à distance UE). Prix dégressif à partir de 2 pièces (8,00 € à l'unité). Néoprène, armature fibre de verre. Choisir la variante 475 mm / 95 dents (article HTD-5M-15-475/95). Équivalent de marque : Contitech 475-5M-15 chez RS Belgique, 15,09 € TTC.
M01684 | FAB- Pinion v2 - Ball Bearing 6801-ZZ - 12x21x5mm | Rillenkugellager 6801 / 61801 ZZ 12x21x5 mm | 2 | 1.44 | 2.88 | vérifié | https://www.dold-mechatronik.de/Rillenkugellager-6801-ZZ-12x21x5-mm | Prix lu TTC 19 % TVA DE (1.43 €), recalculé à 21 % TVA BE (vente à distance UE). Roulement générique en acier à roulement. Il existe en SKF/FAG si on veut une marque.
M00518 | Flexible Motor Coupler D25L30 - 6.35mm to 10mm | Wellenkupplung XB flexibel D25L30 8,00 / 10,00 mm (à mâchoires, 5 Nm) | 1 | 10.86 | 10.86 | vérifié | https://www.dold-mechatronik.de/Shaft-coupling-XB-flexible-D25L30-8.00-10.00mm | Prix lu TTC 19 % TVA DE (10.77 €), recalculé à 21 % TVA BE (vente à distance UE). ALÉSAGE CHOISI : 8 → 10 mm (axe Z, arbre Ø8 du NEMA23 retenu, au lieu de 6,35 mm ; consigne coordinateur). Modèle à mâchoires XB (5 Nm) préféré au modèle à lamelles RB (3 Nm, 8,00 € DE).
M00519 | Flexible Motor Coupler D30L40 - 12.7mm/5ky to 10mm | Accouplement à mâchoires à moyeux serrants (Klemmnabe) D30L40, 10 / 14 mm | 1 | 25.00 | 25.00 | estimation | https://www.dold-mechatronik.de/ | Moyeux serrants au lieu de vis de pression, sur l'arbre claveté Ø14 du moteur X : l'original (12,7 mm avec clavette 5 mm) ne glissait pas non plus. Prix non relevé.
M00704 | Nut Housing DSG16H | 16H Gehäuse Kugelumlaufmutter (DSG16H) | 2 | 10.06 | 20.11 | vérifié | https://www.dold-mechatronik.de/16H-screw-nut-housing | Prix lu TTC 19 % TVA DE (9.97 €), recalculé à 21 % TVA BE (vente à distance UE). Boîtier 16H pour écrou Ø28 (SFU1605/1610). À vérifier : l'écrou SFS1620 livré doit être au même format (Ø28, bride 48) ; certains SFS1620 ont un écrou plus gros qui exige un autre boîtier.
M00832 | Straight rack gauge M2 Q6 500mm | Zahnstange M2 L=502,65 mm C45 non trempée 20x20 (GG-446-020-0005), utilisée comme jauge de raccord | 1 | 27.14 | 27.14 | vérifié | https://www.dold-mechatronik.de/Zahnstange-f.-fortlaufende-Montage-Modul2-Material-C45-Laenge-waehlbar_1 | Prix lu TTC 19 % TVA DE (26.92 €), recalculé à 21 % TVA BE (vente à distance UE). Dold n'a ni jauge de raccord droite M2 ni Q6 de 500 mm (sa jauge à 39 € est pour denture hélicoïdale). Cette crémaillère fraisée de 80 dents sert de jauge : elle convient pour aligner les jonctions, mais elle n'est pas Q6. Pour une jauge Q6, on peut utiliser un court tronçon de crémaillère rectifiée chinoise (≈ 25 €, estimation).
 | Frais de port Dold Mechatronik |  |  |  | 58.41 | vérifié |  | Grille Dold « Paketdienst nach Österreich, Frankreich und BeNeLux », GLS jusqu'à 2 m, jusqu'à 60 kg : 58,90 €. Poids estimé ≈ 53 kg (rails ≈ 21 kg, crémaillères ≈ 23 kg, patins ≈ 4,5 kg, reste ≈ 4 kg). Les rails de 1500 mm excluent DPD (limité à 1,5 m). Le tarif exact n'apparaît qu'au panier.
