wprod/fab-diy/bom/commandes/impression-3d-maison-filament-petg.csv

ref_mekanika | designation | produit | quantite_achat | prix_unitaire_ttc_eur | total_ttc_eur | confiance | lien | notes
M01551 | SPT - Cable Holder 3d Print | Clip porte-câbles pour rainure 6 mm, PETG ~4 g/pièce | 18 | 0.14 | 2.59 | estimation | https://www.3djake.fr/prusa/prusament-petg-shimmering-violet-nfc | Coût matière seul: ~4 g + 10 % de pertes par clip, PETG à 32,99 €/kg TTC (Prusament, 3djake.fr; PETG générique ~20 €/kg). Masse supposée : le STEP du clip est un pointeur Git LFS non téléchargé. Sans imprimante: service en ligne (Craftcloud, JLC3DP...) ~20-30 € port compris; sans filament: bobine 1 kg ~20-33 €.
