wprod/fab-diy/bom/commandes/jlcpcb.csv

ref_mekanika | designation | produit | quantite_achat | prix_unitaire_ttc_eur | total_ttc_eur | confiance | lien | notes
M00714 | PCB Custom for CNC Limit Switches | 5 PCB 2 couches ≤ 100×100 mm, 1,6 mm, HASL (sans composants) | 1 | 2.28 | 2.28 | estimation | https://jlcpcb.com/ | Environ 2 $ HT le lot de 5, ×1,21 ; port sur la ligne PORT JLCPCB. Gerber prêts : cad/pcb-fins-de-course/fab-fins-de-course-gerber.zip (99,5 × 51 mm, 2 couches).
 | Frais de port JLCPCB |  |  |  | 7.93 | estimation |  | Environ 7,90 € constaté début 2026 sur un forum
