wprod/fab-diy/bom/commandes/leroy-merlin-retrait-en-magasin.csv

ref_mekanika | designation | produit | quantite_achat | prix_unitaire_ttc_eur | total_ttc_eur | confiance | lien | notes
 | Martyr : panneaux MDF 18 mm 250×122 cm | Panneau MDF 18 mm 2500×1220 mm (réf. 69130586) | 2 | 49.90 | 99.80 | estimation |  | Un panneau de base vissé sur la table + un martyr surfacé par la machine. Les enseignes ne vendent pas de 19 mm, et 1220 mm couvre 1220 des 1250 mm de course X : pour tout couvrir, MDF 19 mm 2800×2070 chez un négoce bois (sur devis). Prix lu dans un extrait de recherche, à confirmer en magasin.
