wprod/fab-diy/bom/commandes/quincaillerie-negoce-rampa-skd-acier-ou-equivalent.csv

ref_mekanika | designation | produit | quantite_achat | prix_unitaire_ttc_eur | total_ttc_eur | confiance | lien | notes
 | Inserts filetés acier M8 pour brides (martyr) | Inserts à visser acier zingué M8, pour bois et MDF | 50 | 0.70 | 35.00 | estimation |  | Acier plutôt que zamak : les brides de serrage y sont serrées et desserrées très souvent. Prix non relevé (Hranipex demande un compte).
