wprod/fab-diy/bom/commandes/reichelt-conrad.csv

ref_mekanika | designation | produit | quantite_achat | prix_unitaire_ttc_eur | total_ttc_eur | confiance | lien | notes
 | Câble d'arrêt d'urgence 4 × 0,5 mm², 5 m | Câble souple 4 conducteurs 0,5 mm² (LiYY ou H05VV-F), 5 m | 1 | 6.00 | 6.00 | estimation |  | 2 conducteurs pour la boucle 24 V de la bobine du contacteur, 2 pour l'entrée E-Stop de PlanetCNC. Se termine par les deux fiches GX12 2 broches déjà comptées (E-Stop et Input 3). Prix non relevé.
 | Presse-étoupes PG9 pour les câbles codeur | Presse-étoupe PG9 polyamide avec écrou, câble Ø4 à 8 mm | 4 | 0.75 | 3.00 | estimation |  | Entrée des 4 câbles codeur dans le boîtier de commande, perçage Ø16 environ. Prix non relevé.
 | Prise de façade 2P+T pour la Makita | Prise encastrable 2P+T 16 A 250 V type E (française), montage panneau | 1 | 8.00 | 8.00 | estimation |  | Montée sur le boîtier de commande, paroi du fond (perçage à la scie cloche, diamètre selon la prise). Chaîne : contacteur d'arrêt d'urgence → relais 25 A (bobine 24 V, commandée par le module relais 5 V piloté par OUT1 de PlanetCNC) → cette prise. Voir docs/plan-cablage.md.
