wprod/fab-diy/bom/commandes/reichelt-reichelt-com-fr.csv

ref_mekanika | designation | produit | quantite_achat | prix_unitaire_ttc_eur | total_ttc_eur | confiance | lien | notes
M00726 | Power Distribution Unit 4-Way, 16A, 4000W | Multiprise 4 prises 2P+T (type E français) 16 A 3500 W | 1 | 11.90 | 11.90 | estimation | https://www.reichelt.com/fr/fr/shop/ | Version française (prises type E à broche de terre) au lieu de Schuko. Prix équivalent.
