wprod/fab-diy/bom/commandes/reichelt-rs-conrad.csv

ref_mekanika | designation | produit | quantite_achat | prix_unitaire_ttc_eur | total_ttc_eur | confiance | lien | notes
 | Bouton marche vert 1 NO (réarmement du contacteur) | Bouton poussoir Ø22 Schneider Harmony XB5, vert, 1 NO | 1 | 12.00 | 12.00 | estimation |  | Après un arrêt d'urgence ou une coupure secteur, la puissance ne revient qu'en appuyant sur ce bouton (auto-maintien du contacteur) : pas de redémarrage surprise. Prix non relevé.
 | Contacteur de puissance (arrêt d'urgence) | Contacteur modulaire rail DIN 25 A, bobine 24 V CC, 4 contacts NO (ex. Finder série 22 en 24 V CC) | 1 | 50.00 | 50.00 | estimation |  | Bobine 24 V CC et non 230 V : le bouton d'arrêt d'urgence est déporté au bout d'un câble, qui reste ainsi en très basse tension. Après le disjoncteur : coupe l'alimentation 72 V, l'alimentation 48 V et le relais de la Makita. 2 contacts pour phase et neutre, 1 pour l'auto-maintien, 1 de réserve. L'alimentation 24 V reste hors contacteur. Vérifier que la bobine consomme moins de 5 W (alimentation 24 V de 60 W). Prix non relevé.
M00482 | Emergency Stop Button 1NC | Arrêt d'urgence Schneider Harmony XB5 Ø40 à accrochage, déverrouillage par rotation, 2 contacts NF | 1 | 38.00 | 38.00 | estimation |  | 2 NF au lieu d'1 : le premier coupe la bobine du contacteur de puissance (vraie coupure électrique), le second va à l'entrée arrêt d'urgence du contrôleur PlanetCNC, qui arrête le programme. Un arrêt d'urgence qui ne passe que par le logiciel n'est pas une sécurité. Prix non relevé.
 | Rail DIN 35 mm (contacteur et relais) | Rail DIN 35×7,5 mm perforé, 30 cm | 1 | 5.00 | 5.00 | estimation |  | Dans le boîtier de commande.
 | Relais de puissance 25 A pour la Makita | Relais de puissance modulaire rail DIN 25 A, bobine 24 V CC (ex. Finder 22.32 24 V), 2 NO | 1 | 38.00 | 38.00 | estimation |  | Le module relais 5 V d'origine (M00010, piloté par la sortie broche de PlanetCNC) ne doit pas couper le secteur d'un moteur universel de 710 W : ses contacts risquent de coller au courant d'appel. Il commande donc la bobine 24 V de ce relais 25 A, qui alimente la prise de la Makita en aval du contacteur d'arrêt d'urgence. Prix non relevé.
