wprod/fab-diy/bom/commandes/sorotec-blue-line.csv

ref_mekanika | designation | produit | quantite_achat | prix_unitaire_ttc_eur | total_ttc_eur | confiance | lien | notes
M00511 | FF12 Bearing Support | Palier libre à bride FF12 Blue Line (roulement 6000ZZ) | 6 | 12.00 | 72.00 | vérifié | https://www.sorotec.de/shop/CNC-Mechanics/linear-technology/ball-screw-spindle/sorotec-blue-line/ | 11,90 € TTC DE, recalculé à 21 %. Même colis que les rails.
M00512 | FK12 Bearing Support | Palier fixe à bride FK12 Blue Line | 2 | 25.11 | 50.22 | vérifié | https://www.sorotec.de/shop/CNC-Mechanics/linear-technology/ball-screw-spindle/sorotec-blue-line/ | 24,90 € TTC DE, recalculé à 21 %. Format standard FK12, compatible avec l'usinage des vis AliExpress. Même colis que les rails.
M00621 | Linear Block - H20B | HGH20CA slide block short Blue Line | 6 | 26.11 | 156.67 | vérifié | https://www.sorotec.de/shop/CNC-Mechanics/linear-technology/profile-rail-guides/sorotec-blue-line-936/ | 25,89 € TTC DE lu sur la page, recalculé à 21 %. 4,80 € de plus que chez Dold, mais rails et patins génériques doivent venir du même fabricant pour bien s'ajuster.
M00622 | Linear Block - W20A Block (Flange) | HGW20CC flange slide block short Blue Line | 4 | 29.16 | 116.63 | vérifié | https://www.sorotec.de/shop/CNC-Mechanics/linear-technology/profile-rail-guides/sorotec-blue-line-936/ | 28,91 € TTC DE, recalculé à 21 %. Même fabricant que les rails.
M00624 | Linear Rail HGR20 (200mm) | Rail HGR20 Blue Line 200 mm | 2 | 9.99 | 19.97 | vérifié | https://www.sorotec.de/shop/CNC-Mechanics/linear-technology/profile-rail-guides/sorotec-blue-line-936/linear-guideways/hgr-20/ | 9,90 € TTC DE, recalculé à 21 %.
M00626 | Linear rail HGR20 (1500mm) - Docking | Rail HGR20 Blue Line 1500 mm, 25 trous (réf. ZFS.NTS.HGR20.15) | 6 | 73.52 | 441.10 | vérifié | https://www.sorotec.de/shop/CNC-Mechanics/linear-technology/profile-rail-guides/sorotec-blue-line-936/linear-guideways/hgr-20/ | 72,90 € TTC DE lu sur la page, recalculé à 21 %. Même niveau que Dold : compatible HGR sans marque, classe P, précharge moyenne (Dold ne vend pas du HIWIN d'origine). 1500 mm est une longueur du catalogue : 25 trous, E = 30 mm aux deux bouts. Demander en commentaire des coupes d'équerre ébavurées pour l'aboutage.
