wprod/fab-diy/bom/chiffrage/lot-A.csv

ref_mekanika | designation | quantite_bom | fournisseur | produit | lien | prix_unitaire_ttc_eur | unite_achat | quantite_achat | total_ttc_eur | confiance | notes
M00058 | Alu profile I-30120 (1530mm) [4x M6 threads on ONE side] | 4 | Dold Mechatronik (aluprofile-express.de) | Aluminiumprofil 30x120L I-Typ Nut 6, Zuschnitt 1530 mm + 4x M6 Gewinde côté 1 (art. 63047-Z) | https://www.aluprofile-express.de/Aluminiumprofil-30x120L-Nut-6-leicht-316kg-m-Zuschnitt-50-6000mm | 72.21 | pièce coupée 1530 mm | 4 | 288.84 | vérifié | 42,00 €/m + 2,00 € coupe + 4,76 € taraudage 4xM6 (un côté) = 71.02 € TTC DE/pièce. Prix Dold affiché TTC DE 19 %, converti en TTC BE 21 % (x1,21/1,19). Rainure 6 OK. 3,157 kg/m.
M00059 | Alu profile I-6030 (1410mm) | 9 | Dold Mechatronik (aluprofile-express.de) | Aluminiumprofil 30x60L I-Typ Nut 6, Zuschnitt 1410 mm (art. 63016-Z) | https://www.aluprofile-express.de/Aluminiumprofil-30x60L-I-Typ-Nut-6-leicht-168kg-m-Zuschnitt-50-6000mm | 31.12 | pièce coupée 1410 mm | 11 | 342.32 | vérifié | 21,00 €/m + 1,00 € coupe = 30.61 € TTC DE/pièce. Prix Dold affiché TTC DE 19 %, converti en TTC BE 21 % (x1,21/1,19). Motedis affiche 16,89 €/m TTC BE (moins cher sur ce profil seul, mais coupe/taraudage/port non chiffrables). QUANTITÉ : 11 et non 9. Le STEP en contient 11 (4 longerons bas, 3 traverses basses, 4 traverses de table), la nomenclature officielle 9. Voir docs/verifications.md, section 5.
M00930 | Alu Profile I-6030 (600mm) [2x M6 threads on BOTH sides] | 6 | Dold Mechatronik (aluprofile-express.de) | Aluminiumprofil 30x60L I-Typ Nut 6, Zuschnitt 600 mm + 2x M6 Gewinde des deux côtés (art. 63016-Z) | https://www.aluprofile-express.de/Aluminiumprofil-30x60L-I-Typ-Nut-6-leicht-168kg-m-Zuschnitt-50-6000mm | 19.58 | pièce coupée 600 mm | 6 | 117.48 | vérifié | 12,60 € + 1,00 € coupe + 2x2,83 € taraudage 2xM6 = 19.26 € TTC DE/pièce. Prix Dold affiché TTC DE 19 %, converti en TTC BE 21 % (x1,21/1,19).
M00060 | Alu profile I-6060 (1410mm) | 6 | Dold Mechatronik (aluprofile-express.de) | Aluminiumprofil 60x60L I-Typ Nut 6, Zuschnitt 1410 mm (art. 63023-Z) | https://www.aluprofile-express.de/Aluminiumprofil-60x60L-I-Typ-Nut-6-leicht-274kg-m-Zuschnitt-50-6000mm | 52.21 | pièce coupée 1410 mm | 6 | 313.26 | vérifié | 35,00 €/m + 2,00 € coupe = 51.35 € TTC DE/pièce. Prix Dold affiché TTC DE 19 %, converti en TTC BE 21 % (x1,21/1,19). RAINURE 6 et non 8 : mesuré dans le STEP officiel (goulot 6,2 mm, chambre 16,3 mm, identique au 30x60).
M00061 | Alu profile I-6060 (1530mm) [4x M6 threads on BOTH sides] | 2 | Dold Mechatronik (aluprofile-express.de) | Aluminiumprofil 60x60L I-Typ Nut 6, Zuschnitt 1530 mm + 4x M6 Gewinde des deux côtés (art. 63023-Z) | https://www.aluprofile-express.de/Aluminiumprofil-60x60L-I-Typ-Nut-6-leicht-274kg-m-Zuschnitt-50-6000mm | 66.16 | pièce coupée 1530 mm | 2 | 132.32 | vérifié | 53,55 € + 2,00 € coupe + 2x4,76 € taraudage 4xM6 = 65.07 € TTC DE/pièce. Prix Dold affiché TTC DE 19 %, converti en TTC BE 21 % (x1,21/1,19). Rainure 6 (mesure STEP). Le STEP montre un chanfrein 45° de 1,5 mm en entrée de rainure (style V-slot) absent du profilé standard.
M00055 | Alu Profile V-3030 (240mm) [1x M6 thread on BOTH sides] | 2 | Dold Mechatronik (aluprofile-express.de) | Aluminiumprofil 30x30L I-Typ Nut 6, Zuschnitt 240 mm + 1x M6 Gewinde des deux côtés (art. 63009-Z) | https://www.aluprofile-express.de/Aluminiumprofil-30x30L-I-Typ-Nut-6-leicht-094kg-m-Zuschnitt-50-6000mm | 6.325 | pièce coupée 240 mm | 2 | 12.65 | vérifié | 2,88 € + 0,50 € coupe + 2x1,42 € taraudage M6 = 6.22 € TTC DE/pièce. Prix Dold affiché TTC DE 19 %, converti en TTC BE 21 % (x1,21/1,19). Profil « V » du STEP = rainure 6 avec chanfrein 45° 1,5 mm ; ici profilé I standard (sert de support de rail, aucune roue n'y roule).
M00947 | Brush FBL0706 20mm (m) | 0.5 | Achat local (bricolage / grossiste électrique) | Bande brosse à talon alu, poils 20 mm, au mètre (bas de porte à brosse ou brossier) |  | 8.90 | mètre | 1 | 8.90 | estimation | Réf. FBL0706 introuvable ; ~9 €/m constaté pour une bande brosse 1 m (annonce eBay.de type 5). Vendue au mètre : 1 m pour 0,5 m utile.
M00948 | Brush FBL0706 30mm (m) | 6 | Achat local (bricolage / grossiste électrique) | Bande brosse à talon alu, poils 30 mm, au mètre |  | 9.90 | mètre | 6 | 59.40 | estimation | Réf. FBL0706 introuvable ; prix moyen estimé d'une bande brosse alu 30 mm (8,90-12 €/m). 4 tronçons de 1,5 m.
M00882 | Wheel with Bearings for V-slot Profile - Type B | 4 | Bits and Parts (bitsandparts.nl) | V-Slot wheel Creality/OpenBuilds noire, 625ZZ, Ø24 x 11 mm | https://www.bitsandparts.nl/en/v-slot-wheel-for-creality-openbuilds-3d-printer-black-p1911592 | 2.85 | pièce | 4 | 11.40 | vérifié | Prix TTC NL 21 % (= TVA BE). Correspond à la roue du STEP (Ø23,9 x 11 mm, type OpenBuilds Solid V).
M00391 | Cable chain TEZ25.50K 1200mm | 1 | Motedis | Chaîne porte-câbles CK 24 largeur 60 mm (24 x 60 int.), sachets 1 m + 1 paire d'éléments de connexion | https://www.motedis.be/fr/Chaine-porte-cables-CK-24-1-sachet-24-maillons-longueur-1m | 27.45 | chaîne complète 1,2 m | 1 | 27.45 | vérifié | 3 sachets de 1 m à 19,93 € TTC pour les deux chaînes (1,2 + 1,8 = 3,0 m), répartis au prorata, + 1 paire d'embouts à 3,53 €. Pas de 25x50 chez Motedis : 24x60 int., encombrement et entraxe des embouts à vérifier sur les supports de chaîne acier.
M00392 | Cable chain TEZ25.50K 1800mm | 1 | Motedis | Chaîne porte-câbles CK 24 largeur 60 mm (24 x 60 int.), sachets 1 m + 1 paire d'éléments de connexion | https://www.motedis.be/fr/Chaine-porte-cables-CK-24-1-sachet-24-maillons-longueur-1m | 39.40 | chaîne complète 1,8 m | 1 | 39.40 | vérifié | Voir M00391 : 1,8 m pris sur les 3 sachets de 1 m (19,93 € TTC) + 1 paire d'embouts 3,53 €. Même réserve 24x60 vs 25x50.
M00383 | Cable Cover for I-type 6 Profile (2m) | 0.34 | Dold Mechatronik (aluprofile-express.de) | Abdeckprofil Kunststoff NBR I-Typ Nut 6, ca. 1000 mm (art. 62491) | https://www.aluprofile-express.de/Abdeckprofil-Kunststoff-NBR-I-Typ-Nut-6-ca-1000-mm | 5.989 | barre ~1 m | 1 | 5.99 | vérifié | Besoin 2 x 330 mm = 0,66 m : une barre de ~1 m suffit. 5,89 € TTC DE. Prix Dold affiché TTC DE 19 %, converti en TTC BE 21 % (x1,21/1,19).
M00956 | Cable Trunking D31mm L500mm | 3 | Achat local (bricolage / grossiste électrique) | Goulotte flexible fendue à visser 30 mm (31 x 33), L 500 mm, ex. Hager VK flex M5692 | https://hager.com/fr-be/catalogue/produits/m5692-goulot-vk-flex-30-500mm | 8.00 | pièce 500 mm | 3 | 24.00 | estimation | Prix public non affiché chez Hager (conditionnement pro x40) ; ~6,7-9,5 € la pièce relevés sur d'autres sites Hager, d'où 8 € estimés au détail.
M00826 | FAB - Steel cable tray 3000mm (2x1500mm) | 1 | Achat local (bricolage / grossiste électrique) | Chemin de câbles tôle perforée acier galvanisé 100 x 50 mm, longueur 3 m, à recouper en 2 x 1,5 m |  | 40.00 | longueur 3 m | 1 | 40.00 | estimation | Tarif pro Legrand P31 50x100 3 m ~40,92 € HT ; marques de négoce moins chères. Achat en magasin conseillé (3 m coûteux à expédier).
M00827 | Steel cable tray cantilever arm | 2 | Achat local (bricolage / grossiste électrique) | Console / bras support pour chemin de câbles 100 mm |  | 6.00 | pièce | 2 | 12.00 | estimation | Prix courant d'une console simple 100 mm en acier galvanisé, non vérifié.
M00864 | VariBox CHV27 34x26x15 simple cannelure | 1 | — | — |  | 0.00 | — | 0 | 0.00 | vérifié | Emballage, inutile.
M00062 | Angle Bracket 30 B-Type Rainure 6 | 38 | Dold Mechatronik (aluprofile-express.de) | Winkel 30 I-Typ Nut 6, Alu-Druckguss, avec nez de centrage (art. 62378) | https://www.aluprofile-express.de/Winkel-30-I-Typ-Nut-6 | 1.485 | pièce | 38 | 56.43 | vérifié | Palier dès 10 pcs : 1,46 € TTC DE. Prix Dold affiché TTC DE 19 %, converti en TTC BE 21 % (x1,21/1,19). C'est la cornière « Dold » nommée dans le STEP (29,6 x 29,6 x 28). 50 pcs à 1,25 € reviendraient plus cher.
M00063 | Angle Bracket 60 B-Type Groove 8 | 46 | Dold Mechatronik (aluprofile-express.de) | Winkel 60x60 Nut 8 B-Typ, Alu-Druckguss, sans nez de centrage Nut 8 (art. 67250) | https://www.aluprofile-express.de/Winkel-60x60-Nut-8-B-Typ | 2.979 | pièce | 50 | 148.95 | vérifié | 50 pcs au palier 2,93 € TTC DE (146,50 €) < 46 x 3,25 € (149,50 €) : on en prend 50 (le STEP en compte 50). Prix Dold affiché TTC DE 19 %, converti en TTC BE 21 % (x1,21/1,19). Sans nez Nut 8 ; casser les nez Nut 10 si présents. Monté en rainure 6 avec vis M6 + rondelle DIN9021 + écrou I M6, comme dans le STEP.
M00064 | Angle Bracket Simple 20x20 M5 | 4 | Dold Mechatronik (aluprofile-express.de) | Winkel 20 B-Typ Nut 6, trous pour vis M5 (art. F093W203N06S05) | https://www.aluprofile-express.de/Winkel-20-B-Typ-Nut-6-mit-Bohrungen-fuer-M5-Schrauben | 0.895 | pièce | 4 | 3.58 | vérifié | 0,88 € TTC DE. Prix Dold affiché TTC DE 19 %, converti en TTC BE 21 % (x1,21/1,19). Nez de 6 mm compatibles avec la rainure I 6 (6,2 mm).
M00488 | End connection plate 30x60 for Foot M12 | 6 | Découpe laser (avec le lot acier) | Plaque 60 x 30 x 10 mm acier, DXF cad/steel/fab/dxf/Foot_Plate_3060_M6_v2_t10mm_x6.dxf, taraudage M12 central |  | 4.00 | pièce | 6 | 24.00 | estimation | Aucun équivalent 30x60 M12 rainure 6 chez Dold ni Motedis (Dold : 30x60 en M8 seulement). À ajouter au devis laser 10 mm. Mettre 0 si le lot acier les chiffre déjà.
M00524 | Foot D80 M12x50 + Jam nut M12 + Anti Slip | 6 | Motedis | Pieds réglables D80 M12 L50, embase PA66, capuchon amortisseur + écrou inclus (réf. BD80-12x50), lot de 4 | https://www.motedis.be/fr/Pieds-reglables-D80-M12-L50 | 6.99 | lot de 4 | 2 | 13.98 | vérifié | 6,99 € TTC BE le lot de 4 : 2 lots = 8 pieds pour 6 nécessaires. Page : « Stock actuellement insuffisant ». Pas de pied D80 M12 trouvé chez Dold.
M00554 | I-Type Sliding Nut M4 | 24 | Dold Mechatronik (aluprofile-express.de) | Nutenstein mit Steg I-Typ Nut 6 M4, einschwenkbar, Federkugel (art. 62347-VK) | https://www.aluprofile-express.de/Nutenstein-mit-Steg-I-Typ-Nut-6-Gewindedurchmesser-M4 | 0.488 | pièce | 24 | 11.71 | vérifié | Palier dès 10 pcs : 0,48 € TTC DE. Prix Dold affiché TTC DE 19 %, converti en TTC BE 21 % (x1,21/1,19). Écrou à pivoter avec bille ressort, conforme à l'écrou du STEP (10,5 x 17 mm).
M00555 | I-Type Sliding Nut M5 | 168 | Dold Mechatronik (aluprofile-express.de) | Nutenstein mit Steg I-Typ Nut 6 M5, einschwenkbar, Federkugel (art. 62361-VK) | https://www.aluprofile-express.de/Nutenstein-mit-Steg-I-Typ-Nut-6-Gewindedurchmesser-M5 | 0.305 | pièce | 168 | 51.24 | vérifié | Palier dès 100 pcs : 0,30 € TTC DE. Prix Dold affiché TTC DE 19 %, converti en TTC BE 21 % (x1,21/1,19).
M00556 | I-Type Sliding Nut M6 | 368 | Dold Mechatronik (aluprofile-express.de) | Nutenstein mit Steg I-Typ Nut 6 M6, einschwenkbar, Federkugel (art. 62354-VK) | https://www.aluprofile-express.de/Nutenstein-mit-Steg-I-Typ-Nut-6-Gewindedurchmesser-M6 | 0.305 | pièce | 368 | 112.24 | vérifié | Palier dès 100 pcs : 0,30 € TTC DE (500 pcs à 0,27 € = 135 € reviendraient plus cher). Prix Dold affiché TTC DE 19 %, converti en TTC BE 21 % (x1,21/1,19). Rainure 6 partout, y compris sur le 60x60.
M00823 | Square Plate - First CNC Test | 1 | Achat local (bricolage / grossiste électrique) | Chute de MDF ou contreplaqué ~300 x 300 mm |  | 3.00 | pièce | 1 | 3.00 | estimation | Chute pour le premier essai, quelques euros.
PORT | Frais de port Dold Mechatronik | 1 | Dold Mechatronik (aluprofile-express.de) | Colis GLS jusqu'à 2 m, zone AT/BeNeLux/FR, tranche 90-120 kg | https://www.aluprofile-express.de/Versandinformationen | 109.90 | envoi | 1 | 109.90 | estimation | Barème lu : GLS ≤ 2 m, 109,90 € jusqu'à 120 kg (89,90 € jusqu'à 90 kg). Poids estimé ~92 kg (79 kg de profilés + ~13 kg d'accessoires et d'emballage). Pièces de 1530 mm > 1,5 m, donc GLS. Montant final calculé au panier, peut-être moins cher en scindant les colis.
PORT | Frais de port Motedis | 1 | Motedis | Commande accessoires seuls vers la Belgique | https://www.motedis.be/fr/cout-de-livraison:_:1.html | 0.00 | envoi | 1 | 0.00 | estimation | Barème BE : accessoires seuls gratuits au-delà de 27,77 € (commande ~81 €). Si les chaînes ne comptent pas comme accessoires : ~18,66 € HT + 4,44 € d'emballage, soit ~28 € TTC.
PORT | Frais de port Bits and Parts | 1 | Bits and Parts (bitsandparts.nl) | Petit colis vers la Belgique |  | 7.95 | envoi | 1 | 7.95 | estimation | Tarif BE non affiché (NL : 3,95-5,95 €) ; ~8 € estimés.
PORT | Frais de port Achat local (bricolage / grossiste électrique) | 1 | Achat local (bricolage / grossiste électrique) | Retrait en magasin |  | 0.00 | envoi | 1 | 0.00 | estimation | Retrait en magasin, pas de port.
PORT | Frais de port Découpe laser (avec le lot acier) | 1 | Découpe laser (avec le lot acier) | Mutualisé avec le lot acier |  | 0.00 | envoi | 1 | 0.00 | estimation | Envoi compris dans celui du lot acier.
