wprod/fab-diy/bom/chiffrage/lot-E-materiel-possede.csv

ref_mekanika | designation | quantite_bom | fournisseur | produit | lien | prix_unitaire_ttc_eur | unite_achat | quantite_achat | total_ttc_eur | confiance | notes | categorie
M00739 | Raspberry Pi 4B 2G | 1 | Déjà possédé | Raspberry Pi 5 16 Go (déjà possédé) |  | 0 | pièce | 0 | 0 | vérifié | Remplace le Pi 4. PlanetCNC TNGv2 a une version « RaspberryPi 5 (64bit) » (page de téléchargement, version du 2026-08-12). Mêmes trous de fixation 58×49 mm ; ports Ethernet/USB inversés par rapport au Pi 4, sans conséquence avec les rallonges de façade.
M00853 | USB-C 24V to 5V 3A converter | 1 | AliExpress / Amazon | Convertisseur abaisseur 12/24 V → 5 V 5 A sortie USB-C |  | 10 | pièce | 1 | 10 | estimation | Le Pi 5 veut 5 V 5 A. Avec 3 A il démarre mais limite l'USB à 600 mA au total. Avec un module 5 A sans négociation PD, ajouter usb_max_current_enable=1 dans /boot/firmware/config.txt.
 | Broche 2,2 kW refroidie air, ER20, 6000-24000 tr/min, 220 V | 1 | Déjà possédé | Affleureuse Makita (déjà possédée) à la place du kit broche + VFD |  | 0 | pièce | 0 | 0 | vérifié | Hypothèse : Makita RT0701C/RT0702C (710 W, 10 000-30 000 tr/min, corps Ø65 mm, pinces 6 et 8 mm). Vitesse réglée à la molette (pas de M3 S…). Le kit broche + VFD reste l'évolution prévue (≈145 € de plus).
 | Jeu de pinces ER20 (1-13 mm) | 1 | Déjà possédé | Pinces Makita d'origine (6/8 mm) |  | 0 | pièce | 0 | 0 | vérifié | Pas de pinces ER20 avec la Makita. Une pince 6 mm Makita d'origine coûte une dizaine d'euros si elle manque.
 | Support de broche Ø80 mm | 1 | AliExpress / Amazon | Support de fraiseuse alu Ø65 mm à serrage |  | 20 | pièce | 1 | 20 | estimation | Pour la Makita. Choisir un collier dont l'alésage fait vraiment 65 mm (certains font 65,25 mm et serrent mal). Percer la spindle plate (DXF) aux trous de ce support avant découpe, en gardant si possible le perçage Ø80 pour la broche plus tard.
M00809 | Speakon Connector Panel Mount | 1 | — | Inutile avec la Makita |  | 0 | pièce | 0 | 0 | vérifié | Sortie moteur du VFD vers la broche : inutile tant que la Makita est utilisée.
M00718 | PWM to Analog Voltage Converter 0-10V | 1 | — | Inutile avec la Makita |  | 0 | pièce | 0 | 0 | vérifié | Sert à piloter la vitesse du VFD : inutile avec la Makita (molette).
AJOUT | Ventilateur actif Raspberry Pi 5 | 1 | Reichelt / Kubii | Raspberry Pi Active Cooler officiel |  | 6 | pièce | 1 | 6 | estimation | Le Pi 5 chauffe plus que le Pi 4 ; recommandé dans le boîtier fermé. | Moteurs & electronique
AJOUT | Prise de façade 2P+T pour la Makita | 1 | Reichelt / Conrad | Prise encastrable 2P+T 16 A 250 V type E (française), montage panneau |  | 8 | pièce | 1 | 8 | estimation | La fiche CEE 7/7 de la Makita entre dans une prise type E comme dans une Schuko. Le boîtier VFD devient un boîtier relais : entrée C14 → disjoncteur → relais (commandé par la sortie broche de PlanetCNC, M3/M5) → cette prise. L'arrêt d'urgence coupe ainsi aussi la Makita. Vérifier que le relais tient le courant de démarrage (710 W ≈ 3 A en régime). | Cablage & connectique
