wprod/fab-diy/bom/chiffrage/lot-F-alternatives.csv

ref_mekanika | designation | quantite_bom | fournisseur | produit | lien | prix_unitaire_ttc_eur | unite_achat | quantite_achat | total_ttc_eur | confiance | notes | categorie
M00831 | Straight Rack M2 DIN5 1005.31mm | 6 | DamenCNC (2 × 2 m) + Dold (2 × 1 m) | Gambini Q6 rectifiée 24×24×2010,6 mm (×2, DamenCNC) + Dold GG-445-020-0210 24×24×1005,31 mm mit Bohrbild (×2) | https://www.damencnc.com/en/straight-rack-module-2-q6-high-precision-24x24x2010-6mm/a2687 | 344.85 | barre 2 m (DamenCNC) | 2 + 2 | 1287.16 | vérifié | Par côté : 1 barre Gambini de 2010,6 mm + 1 barre Dold de 1005,31 mm = 3015,9 mm, comme 3 × 1005,31, avec une jonction de moins. DamenCNC : 285 € HT dès 2 pièces (300 € à l'unité) → 344,85 € TTC ×2 = 689,70 €. Dold : 293,79 € TTC DE dès 2 pièces (le 278,33 € du premier chiffrage ne vaut qu'à partir de 5) → 298,73 € TTC BE ×2 = 597,46 €. Équivalence vérifiée sur le STEP Gambini : 24×24, ligne primitive 22 mm, mêmes perçages (Ø7 lamé Ø11, pas de 125,66 mm, goupilles Ø5,7 à 31,3 mm des bouts). Gambini : qualité 6, dents trempées par induction 56-60 HRC, rectifiée sur toutes les faces, en stock. Le gabarit de raccord Dold reste valable.
M00626 | Linear rail HGR20 (1500mm) - Docking | 6 | Sorotec (Blue Line) | Rail HGR20 Blue Line 1500 mm, 25 trous (réf. ZFS.NTS.HGR20.15) | https://www.sorotec.de/shop/CNC-Mechanics/linear-technology/profile-rail-guides/sorotec-blue-line-936/linear-guideways/hgr-20/ | 74.13 | pièce | 6 | 444.78 | vérifié | 72,90 € TTC DE lu sur la page, recalculé à 21 %. Même niveau que Dold : compatible HGR sans marque, classe P, précharge moyenne (Dold ne vend pas du HIWIN d'origine). 1500 mm est une longueur du catalogue : 25 trous, E = 30 mm aux deux bouts. Demander en commentaire des coupes d'équerre ébavurées pour l'aboutage.
M00624 | Linear Rail HGR20 (200mm) | 2 | Sorotec (Blue Line) | Rail HGR20 Blue Line 200 mm | https://www.sorotec.de/shop/CNC-Mechanics/linear-technology/profile-rail-guides/sorotec-blue-line-936/linear-guideways/hgr-20/ | 10.07 | pièce | 2 | 20.14 | vérifié | 9,90 € TTC DE, recalculé à 21 %.
M00621 | Linear Block - H20B | 6 | Sorotec (Blue Line) | HGH20CA slide block short Blue Line | https://www.sorotec.de/shop/CNC-Mechanics/linear-technology/profile-rail-guides/sorotec-blue-line-936/ | 26.33 | pièce | 6 | 157.98 | vérifié | 25,89 € TTC DE lu sur la page, recalculé à 21 %. 4,80 € de plus que chez Dold, mais rails et patins génériques doivent venir du même fabricant pour bien s'ajuster.
M00622 | Linear Block - W20A Block (Flange) | 4 | Sorotec (Blue Line) | HGW20CC flange slide block short Blue Line | https://www.sorotec.de/shop/CNC-Mechanics/linear-technology/profile-rail-guides/sorotec-blue-line-936/ | 29.40 | pièce | 4 | 117.60 | vérifié | 28,91 € TTC DE, recalculé à 21 %. Même fabricant que les rails.
M00512 | FK12 Bearing Support | 2 | Sorotec (Blue Line) | Palier fixe à bride FK12 Blue Line | https://www.sorotec.de/shop/CNC-Mechanics/linear-technology/ball-screw-spindle/sorotec-blue-line/ | 25.32 | pièce | 2 | 50.64 | vérifié | 24,90 € TTC DE, recalculé à 21 %. Format standard FK12, compatible avec l'usinage des vis AliExpress. Même colis que les rails.
M00511 | FF12 Bearing Support | 6 | Sorotec (Blue Line) | Palier libre à bride FF12 Blue Line (roulement 6000ZZ) | https://www.sorotec.de/shop/CNC-Mechanics/linear-technology/ball-screw-spindle/sorotec-blue-line/ | 12.10 | pièce | 6 | 72.60 | vérifié | 11,90 € TTC DE, recalculé à 21 %. Même colis que les rails.
PORT | Frais de port DamenCNC | 1 | DamenCNC (Pays-Bas) | Envoi NL → BE + supplément de longueur |  | 114.95 | envoi | 1 | 114.95 | estimation | Supplément « long item » de 40 € HT lu sur la page, compté par barre par prudence (2 × 40 €), plus ~15 € HT d'envoi, ×1,21. Si le supplément est compté par commande, le port tombe à ~67 €. Envoi intra-UE : pas de douane.
PORT | Frais de port Sorotec | 1 | Sorotec | Colis vers la Belgique | https://www.sorotec.de/shop/info/shipping---returns.html | 25.75 | envoi | 1 | 25.75 | estimation | Dernière tranche de la grille BE (25,32 € TTC DE), recalculée à 21 %. Colis ~28 kg. Vérifier au panier s'il y a un supplément pour les rails de 1,5 m.
