wprod/fab-diy/bom/chiffrage/lot-G-france.csv

ref_mekanika | designation | quantite_bom | fournisseur | produit | lien | prix_unitaire_ttc_eur | unite_achat | quantite_achat | total_ttc_eur | confiance | notes | categorie | tva_pays
PORT | Frais de port Sorotec | 1 | Sorotec | Colis vers la France (tranche jusqu'à 30 kg) | https://www.sorotec.de/shop/info/shipping---returns.html | 30.40 | envoi | 1 | 30.40 | vérifié | Grille Sorotec lue pour FR : 8,97 / 13,01 / 19,06 / 27,13 / 30,15 € TTC DE ; colis ~28 kg → 30,15 €, recalculé à 20 %. Vérifier au panier s'il y a un supplément pour les rails de 1,5 m. |  | FR
PORT | Frais de port DamenCNC | 1 | DamenCNC (Pays-Bas) | Envoi NL → France + supplément « long item » pour les barres de 2 m |  | 126.00 | envoi | 1 | 126.00 | estimation | DamenCNC ne publie pas sa grille. Supplément « long item » de 40 € HT lu sur la page, compté par barre par prudence (2 × 40 €), plus ~25 € HT d'envoi vers la France (colis hors format > 1,75 m), ×1,20. Si le supplément est par commande, compter ~78 €. Demander un devis de port avant de commander. |  | FR
M00726 | Power Distribution Unit 4-Way, 16A, 4000W | 1 | Reichelt (reichelt.com/fr) | Multiprise 4 prises 2P+T (type E français) 16 A 3500 W | https://www.reichelt.com/fr/fr/shop/ | 12.00 | pièce | 1 | 12.00 | estimation | Version française (prises type E à broche de terre) au lieu de Schuko. Prix équivalent. |  | BE
