wprod/fab-diy/bom/chiffrage/lot-I-boucle-fermee.csv

ref_mekanika | designation | quantite_bom | fournisseur | produit | lien | prix_unitaire_ttc_eur | unite_achat | quantite_achat | total_ttc_eur | confiance | notes | categorie | tva_pays
M00699 | Nema34 Stepper Motor 6A 12.7mm Shaft | 3 | StepperOnline (entrepôt DE) | Kit boucle fermée 1-CL86T-S90-V41 : NEMA 34 9,0 N·m 34HS46-6004D-E1000 (codeur 1000 ppr) + driver CL86T V4.1 | https://www.omc-stepperonline.com/fr/kit-cnc-pas-a-pas-a-boucle-fermee-1-axe-serie-ts-9-nm-1274-76oz-in-nema-34-moteur-et-pilote-1-cl86t-s90-v41 | 93.78 | kit | 3 | 281.34 | vérifié | Mis au panier le 08/11/2026, destination France, entrepôt DE : 76,92 € + 16,86 € de supplément « stock local » par kit. Aucune ligne de TVA ajoutée au panier (le site annonce « pas de taxes supplémentaires » depuis l'UE) : TTC probable, à confirmer au paiement. 9 N·m au lieu de 8,2 N·m : pas de perte de couple. Arbre Ø14 mm claveté, 37 mm, comme le moteur précédent : poulies et accouplements inchangés. Driver CL86T : 24-110 V CC, donc l'alimentation 72 V reste. 14 en stock DE. | Moteurs & electronique | FR
M00688 | Motor Driver 2DM860H - FAB | 4 | — | Inutile : drivers inclus dans les kits en boucle fermée |  | 0 | pièce | 0 | 0 | vérifié | Les kits CL86T (X/Y) et CL57T (Z) ont chacun leur driver. | Moteurs & electronique | FR
M00697 | Nema23 Stepper Motor 5A 6.35mm Shaft | 1 | StepperOnline (entrepôt DE) | Kit boucle fermée 1-CL57T-S30A-V41 : NEMA 23 3,0 N·m 23HS45-4204D-E1000 + driver CL57T V4.1 | https://www.omc-stepperonline.com/fr/ | 70.57 | kit | 1 | 70.57 | vérifié | Moteur neuf : la XE-PRO garde le sien. 58,55 € + 12,02 € « stock local » DE, mis au panier le 08/11/2026. Arbre Ø8 mm à méplat, comme le 23HS39 prévu. Seulement 2 en stock DE : commander vite ou passer par l'entrepôt Chine. Le driver CL57T accepte 24-48 V CC seulement (aucun driver NEMA 23 en boucle fermée de StepperOnline ne tient 72 V) : alimentation 48 V séparée ci-dessous. | Moteurs & electronique | FR
AJOUT | Alimentation 48 V pour le driver Z | 1 | Audiophonics (Bordeaux) | Mean Well LRS-350-48 (48 V, 7,3 A, 350 W) | https://www.audiophonics.fr/fr/alimentations-smps/mean-well-lrs-350-48-module-d-alimentation-a-decoupage-smps-48v-73a-350w-p-12170.html | 39.90 | pièce | 1 | 39.90 | vérifié | Le driver CL57T monte à 48 V au maximum. Règle du même coup le point « NEMA 23 sous 72 V » : le moteur Z a sa tension nominale. Entrée 230 V derrière le même contacteur d'arrêt d'urgence que l'alimentation 72 V. | Moteurs & electronique | FR
AJOUT | Rallonges de câble codeur (boucle fermée) | 4 | StepperOnline (entrepôt DE) | Rallonge de câble codeur pour kits CL86T/CL57T, 3 à 5 m selon l'axe | https://www.omc-stepperonline.com/fr/ | 12 | pièce | 4 | 48 | estimation | Les kits n'ont que 1,7 m de câble moteur et codeur. Les câbles moteur blindés de la nomenclature restent ; il faut en plus amener le codeur jusqu'à l'armoire, dans les chaînes porte-câbles. Choisir une rallonge prévue pour chaîne (flexion continue) ou du câble blindé 6 conducteurs + connecteurs. Prix non relevé. | Cablage & connectique | FR
PORT | Frais de port StepperOnline (entrepôt DE) | 1 | StepperOnline (entrepôt DE) | DHL Paket (UE) depuis l'Allemagne, 4 kits + rallonges | https://www.omc-stepperonline.com/fr/ | 52.00 | envoi | 1 | 52.00 | estimation | Lu au panier pour les 3 kits NEMA 34 : 45,85 € DHL + 1,73 € d'emballage. Compté ~52 € avec le kit NEMA 23 et les rallonges. |  | FR
PORT | Frais de port Audiophonics (Bordeaux) | 1 | Audiophonics (Bordeaux) | Colis France |  | 6.90 | envoi | 1 | 6.90 | estimation | Port offert dès 149 € ; pour l'alimentation seule, tarif non relevé. |  | FR
AJOUT | Martyr : panneaux MDF 18 mm 250×122 cm | 2 | Leroy Merlin (retrait en magasin) | Panneau MDF 18 mm 2500×1220 mm (réf. 69130586) |  | 49.90 | panneau | 2 | 99.80 | estimation | Un panneau de base vissé sur la table + un martyr surfacé par la machine. Les enseignes ne vendent pas de 19 mm, et 1220 mm couvre 1220 des 1250 mm de course X : pour tout couvrir, MDF 19 mm 2800×2070 chez un négoce bois (sur devis). Prix lu dans un extrait de recherche, à confirmer en magasin. | Divers | FR
AJOUT | Inserts filetés acier M8 pour brides (martyr) | 50 | Quincaillerie / négoce (Rampa SKD acier ou équivalent) | Inserts à visser acier zingué M8, pour bois et MDF |  | 0.70 | pièce | 50 | 35.00 | estimation | Acier plutôt que zamak : les brides de serrage y sont serrées et desserrées très souvent. Prix non relevé (Hranipex demande un compte). | Divers | FR
