wprod/fab-diy/bom/chiffrage/lot-J-revue-finale.csv

ref_mekanika | designation | quantite_bom | fournisseur | produit | lien | prix_unitaire_ttc_eur | unite_achat | quantite_achat | total_ttc_eur | confiance | notes | categorie | tva_pays
M00482 | Emergency Stop Button 1NC | 1 | Reichelt / RS / Conrad | Arrêt d'urgence Schneider Harmony XB5 Ø40 à accrochage, déverrouillage par rotation, 2 contacts NF |  | 38.00 | pièce | 1 | 38.00 | estimation | 2 NF au lieu d'1 : le premier coupe la bobine du contacteur de puissance (vraie coupure électrique), le second va à l'entrée arrêt d'urgence du contrôleur PlanetCNC, qui arrête le programme. Un arrêt d'urgence qui ne passe que par le logiciel n'est pas une sécurité. Prix non relevé. | Capteurs & securite | FR
AJOUT | Contacteur de puissance (arrêt d'urgence) | 1 | Reichelt / RS / Conrad | Contacteur modulaire rail DIN 25 A, bobine 230 V CA, 4 contacts NO (ex. Finder série 22, Hager ESC) |  | 50.00 | pièce | 1 | 50.00 | estimation | Manquait dans la BOM. Après le disjoncteur : coupe l'alimentation 72 V, l'alimentation 48 V, la prise de la Makita (et plus tard l'entrée du VFD, jamais entre VFD et broche). 2 contacts pour phase et neutre, 1 pour l'auto-maintien, 1 de réserve. L'alimentation 24 V (carte, Pi, capteurs) reste hors contacteur pour garder l'état de la commande. Choisir une référence AC-7b ou moteur ≥ 3 kW. Prix non relevé. | Capteurs & securite | FR
AJOUT | Bouton marche vert 1 NO (réarmement du contacteur) | 1 | Reichelt / RS / Conrad | Bouton poussoir Ø22 Schneider Harmony XB5, vert, 1 NO |  | 12.00 | pièce | 1 | 12.00 | estimation | Après un arrêt d'urgence ou une coupure secteur, la puissance ne revient qu'en appuyant sur ce bouton (auto-maintien du contacteur) : pas de redémarrage surprise. Prix non relevé. | Capteurs & securite | FR
AJOUT | Rail DIN 35 mm (contacteur et relais) | 1 | Reichelt / RS / Conrad | Rail DIN 35×7,5 mm perforé, 30 cm |  | 5.00 | pièce | 1 | 5.00 | estimation | Dans le boîtier de commande. | Cablage & connectique | FR
M00733 | Pulley HTD-5M 16mm 20 teeth | 2 | Dold Mechatronik + atelier local | Poulie HTD-5M 20 dents acier BSY205M15-B-P14 (alésage 14 H7) + rainure de clavette 5 mm DIN 6885 brochée | https://www.dold-mechatronik.de/Toothed-belt-wheel-HTD-5M-15mm-wide-20-teeth-bore-14.00mm-H7-with-clamping-screws-steel | 29.62 | pièce | 2 | 59.24 | estimation | 14,62 € la poulie (Dold, vérifié) + ~15 € de brochage par poulie (estimation). Les arbres Ø14 des NEMA 34 sont clavetés : sans clavette, une poulie qui glisse sur l'arbre n'est pas vue par le codeur du moteur, et le portique se met de travers sans alarme. L'original utilisait des pièces clavetées. | Guidage & transmission | FR
M00519 | Flexible Motor Coupler D30L40 - 12.7mm/5ky to 10mm | 1 | Dold Mechatronik | Accouplement à mâchoires à moyeux serrants (Klemmnabe) D30L40, 10 / 14 mm | https://www.dold-mechatronik.de/ | 25.00 | pièce | 1 | 25.00 | estimation | Moyeux serrants au lieu de vis de pression, sur l'arbre claveté Ø14 du moteur X : l'original (12,7 mm avec clavette 5 mm) ne glissait pas non plus. Prix non relevé. | Guidage & transmission | FR
AJOUT | Prise de façade 2P+T pour la Makita | 1 | Reichelt / Conrad | Prise encastrable 2P+T 16 A 250 V type E (française), montage panneau |  | 8 | pièce | 1 | 8 | estimation | La fiche CEE 7/7 de la Makita entre dans une prise type E comme dans une Schuko. Le boîtier VFD devient un boîtier relais : entrée C14 → disjoncteur → contacteur d'arrêt d'urgence → relais 25 A (bobine 24 V commandée par le module relais 5 V, lui-même piloté par la sortie broche de PlanetCNC, M3/M5) → cette prise. | Cablage & connectique | BE
AJOUT | Relais de puissance 25 A pour la Makita | 1 | Reichelt / RS / Conrad | Relais de puissance modulaire rail DIN 25 A, bobine 24 V CC (ex. Finder 22.32 24 V), 2 NO |  | 38.00 | pièce | 1 | 38.00 | estimation | Le module relais 5 V d'origine (M00010, piloté par la sortie broche de PlanetCNC) ne doit pas couper le secteur d'un moteur universel de 710 W : ses contacts risquent de coller au courant d'appel. Il commande donc la bobine 24 V de ce relais 25 A, qui alimente la prise de la Makita en aval du contacteur d'arrêt d'urgence. Prix non relevé. | Moteurs & electronique | FR
