wprod/fab-diy/bom/chiffrage/recherches/racks.csv

ref_mekanika | designation | quantite_bom | fournisseur | produit | lien | prix_unitaire_ttc_eur | unite_achat | quantite_achat | total_ttc_eur | confiance | notes | total_actuel_eur | gain_eur | equivalence_qualite
M00831 | Straight Rack M2 DIN5 1005.31mm | 6 | DamenCNC (Pays-Bas) | Straight Rack Module 2 Q6 (High Precision) 24x24x2010,6 mm, Gambini Meccanica, art. 4533 | https://www.damencnc.com/en/straight-rack-module-2-q6-high-precision-24x24x2010-6mm/a2687 | 344.85 | pièce (2010,6 mm = 2 x 1005,3 mm, 320 dents) | 2 | 689.7 | vérifié | ÉCART DE LONGUEUR, À VALIDER : la barre fait 2 m, alors que le brief fixe ~1 m. Montage par côté : 1 barre DamenCNC de 2010,6 mm + 1 barre Dold GG-445-020-0210 de 1005,31 mm = 3015,9 mm, soit la même longueur que 3 x 1005,31. Les 2 barres Dold restantes (2 x 283,01 = 566,02 €) ne changent pas et ne figurent pas dans ce fichier. Prix lu sur la page : 300 € HT l'unité, 285 € HT dès 2 pièces (palier -5 %), recalculé x1,21 (TVA BE, vente à distance UE). Paliers suivants : 270 € HT dès 4, 255 € HT dès 6. En stock (délai estimé 3 à 5 jours ouvrés vers la Belgique). Perçages : la page ne les décrit pas. Les Gambini standard ont des trous lamés Ø7/Ø11 (M6) et des trous de goupille Ø5,7, à confirmer auprès de DamenCNC avant commande. Il n'existe pas de version 1 m de cette barre chez DamenCNC. Jonction entre deux marques : ligne primitive attendue à 22 mm chez les deux (standard 24x24 M2), à vérifier sur le fichier STEP Gambini. Utiliser une jauge de raccord 24x24 (voir M00832). | 1132.04 | 442.34 | Gambini Q6 (DIN 3962/3967 Q6, jeu conseillé 0,02 mm), trempée par induction 56-60 HRC (Dold/G&G : 50-55 HRC), rectifiée sur toutes les faces, acier SAE1141, section 24x24 module 2 denture droite : équivalente ou meilleure. Seule la longueur diffère (2 m).
PORT | Frais de port DamenCNC | 1 | DamenCNC (Pays-Bas) | Expédition NL vers BE + supplément longueur 40 € HT par barre de 2 m | https://www.damencnc.com/en/straight-rack-module-2-q6-high-precision-24x24x2010-6mm/a2687 | 114.95 | envoi | 1 | 114.95 | estimation | Supplément de 40 € HT lu sur la page, compté par barre (2 x 40 €, hypothèse prudente) + envoi de base vers la Belgique ≈ 15 € HT (estimation, colis ≈ 16 kg), le tout x1,21. Pas de droits de douane (envoi intra-UE). | 0 | -114.95 | Sans objet (frais de port).
