wprod/fab-diy/bom/chiffrage/recherches/rails.csv

ref_mekanika | designation | quantite_bom | fournisseur | produit | lien | prix_unitaire_ttc_eur | unite_achat | quantite_achat | total_ttc_eur | confiance | notes | total_actuel_eur | gain_eur | equivalence_qualite
M00626 | Linear rail HGR20 (1500mm) - Docking | 6 | Sorotec (Blue Line) | Linear Rail Blue Line HGR20, longueur standard 1500 mm (réf. ZFS.NTS.HGR20.15), 25 trous au pas de 60 | https://www.sorotec.de/shop/CNC-Mechanics/linear-technology/profile-rail-guides/sorotec-blue-line-936/linear-guideways/hgr-20/ | 74.13 | pièce de 1500 mm | 6 | 444.78 | vérifié | Prix lu : 72,90 € TTC 19 % TVA DE (affichage Sorotec « incl. 19% tax »), recalculé à 21 % TVA BE. 1500 mm est une longueur du catalogue, pas une coupe spéciale : 25 trous sur 1500 mm donnent E = 30 mm aux deux bouts si le perçage est centré. À écrire dans le commentaire de commande : coupes d'équerre et ébavurées pour l'aboutage, E = 30 mm aux deux bouts, rails appairés deux par deux. Les coupes ne sont ni reprises ni échangées. Envoi par colis possible jusqu'à 2,60 m. Poids des 6 rails ≈ 19,9 kg. Ne pas mélanger rails Sorotec et patins Dold : ce sont deux sources génériques différentes, sans garantie d'interchangeabilité. Prendre aussi les 6 HGH20CA Blue Line (25,89 € DE, soit 26,33 € BE, 157,98 € en tout, +4,80 € par rapport à Dold). Cette ligne ne figure pas dans le fichier car son gain est négatif. | 579.60 | 134.82 | Égale au choix actuel, pas à HIWIN. Dold ne vend pas du HIWIN : sa fiche technique (« DATENBLATT DOLD Mechatronik », HG Profilschienenführungen und Wagen, 2026-09-17) décrit un compatible HGR sans marque (classe P, précharge moyenne, patins 20CrMo). Sorotec Blue Line est la même catégorie : marque de distributeur allemand, fiche Sorotec avec classe P, précharge moyenne et 20CrMo, rail en 1.1219 trempé par induction. Les deux restent en dessous d'un HIWIN, TBI ou PMI d'origine.
M00624 | Linear Rail HGR20 (200mm) | 2 | Sorotec (Blue Line) | Linear Rail Blue Line HGR20, longueur standard 200 mm (réf. ZFS.NTS.HGR20.02), 4 trous | https://www.sorotec.de/shop/CNC-Mechanics/linear-technology/profile-rail-guides/sorotec-blue-line-936/linear-guideways/hgr-20/ | 10.07 | pièce de 200 mm | 2 | 20.14 | vérifié | Prix lu : 9,90 € TTC 19 % TVA DE, recalculé à 21 % TVA BE. Longueur standard du catalogue, sans frais de coupe. | 34.58 | 14.44 | Égale au choix actuel, pas à HIWIN. Dold ne vend pas du HIWIN : sa fiche technique (« DATENBLATT DOLD Mechatronik », HG Profilschienenführungen und Wagen, 2026-09-17) décrit un compatible HGR sans marque (classe P, précharge moyenne, patins 20CrMo). Sorotec Blue Line est la même catégorie : marque de distributeur allemand, fiche Sorotec avec classe P, précharge moyenne et 20CrMo, rail en 1.1219 trempé par induction. Les deux restent en dessous d'un HIWIN, TBI ou PMI d'origine.
M00622 | Linear Block - W20A Block (Flange) | 4 | Sorotec (Blue Line) | HGW20CC flange slide block, short, Blue Line (0,46 kg) | https://www.sorotec.de/shop/CNC-Mechanics/linear-technology/profile-rail-guides/sorotec-blue-line-936/hgw-flange-carriages/ | 29.40 | pièce | 4 | 117.60 | vérifié | Prix lu : 28,91 € TTC 19 % TVA DE (« incl. 19% tax »), recalculé à 21 % TVA BE. Pas de prix dégressif affiché. Gain faible, mais il faut acheter les patins avec les rails chez le même fournisseur (voir M00626). Disponible tout de suite, 2 à 3 jours. | 119.40 | 1.80 | Égale au choix actuel, pas à HIWIN. Dold ne vend pas du HIWIN : sa fiche technique (« DATENBLATT DOLD Mechatronik », HG Profilschienenführungen und Wagen, 2026-09-17) décrit un compatible HGR sans marque (classe P, précharge moyenne, patins 20CrMo). Sorotec Blue Line est la même catégorie : marque de distributeur allemand, fiche Sorotec avec classe P, précharge moyenne et 20CrMo, rail en 1.1219 trempé par induction. Les deux restent en dessous d'un HIWIN, TBI ou PMI d'origine.
M00512 | FK12 Bearing Support | 2 | Sorotec (Blue Line) | Flange fixed bearing FK12 for Ø 16 mm ball screw, Blue Line | https://www.sorotec.de/shop/CNC-Mechanics/linear-technology/ball-screw-spindle/sorotec-blue-line/accessories-for-ball-screws-930/accessories-for-o-16-mm-ball-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 | 25.32 | pièce | 2 | 50.64 | vérifié | Prix lu : 24,90 € TTC 19 % TVA DE, recalculé à 21 % TVA BE. Même format standard FK12 (Ø12, M12x1) que chez Dold, compatible avec l'usinage BK/FK12 des vis AliExpress. Sorotec vend aussi le roulement 7001 en pièce de rechange (7,90 €). Livré dans le même colis que les rails, sans port en plus. | 55.62 | 4.98 | Égale : FK12 générique marque distributeur dans les deux cas (Dold et Sorotec Blue Line), au même format standard.
M00511 | FF12 Bearing Support | 6 | Sorotec (Blue Line) | Flange float bearing block FF12 for Ø 16 mm ball screw, Blue Line (roulement 6000ZZ) | https://www.sorotec.de/shop/CNC-Mechanics/linear-technology/ball-screw-spindle/sorotec-blue-line/accessories-for-ball-screws-930/accessories-for-o-16-mm-ball-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 | 12.10 | pièce | 6 | 72.60 | vérifié | Prix lu : 11,90 € TTC 19 % TVA DE, recalculé à 21 % TVA BE. La fiche Sorotec indique un roulement 6000ZZ et un boîtier de Ø 52 mm. Livré dans le même colis que les rails. | 78.30 | 5.70 | Égale : FF12 générique (roulement 6000ZZ) dans les deux cas.
PORT | Frais de port Sorotec |  | Sorotec | Colis vers la Belgique, dernière tranche de la grille (jusqu'à 30 ou 31,5 kg) | https://www.sorotec.de/shop/info/shipping---returns.html | 25.75 | envoi | 1 | 25.75 | vérifié | Grille lue pour BE : 8,03 / 12,10 / 14,13 / 20,23 / 25,32 € (« inclusive tax »). 25,32 € est la dernière tranche, recalculée à 21 % TVA. Poids estimé ≈ 25 kg avec emballage (rails 20,8 kg, 4 HGW 1,8 kg, paliers ≈ 2,4 kg), ≈ 27 à 29 kg si on y ajoute les 6 HGH20CA. La page ne dit rien d'un supplément pour colis long (1,5 m) : à vérifier au panier. Le port Dold reste dû pour les crémaillères. Il pourrait baisser, puisque le colis Dold perd ≈ 21 kg et ses pièces de plus de 1,5 m, mais la grille Dold n'a pas pu être lue : rien n'est compté. | 0.00 | -25.75 | sans objet
