wprod/fab-diy/bom/chiffrage/recherches/structure.csv

ref_mekanika | designation | quantite_bom | fournisseur | produit | lien | prix_unitaire_ttc_eur | unite_achat | quantite_achat | total_ttc_eur | confiance | notes | total_actuel_eur | gain_eur | equivalence_qualite
M00062 | Angle Bracket 30 B-Type Rainure 6 | 38 | Motedis (motedis.be) | Bracket 30 I-type slot 6, alu moulé sous pression noir, 2 trous oblongs 6,4 x 9,5 (art. S6IBR30) | https://www.motedis.be/en/Bracket-30-I-type-slot-6 | 10.08 | sachet de 10 | 4 | 40.32 | vérifié | 8,33 € HT / 10,08 € TTC (TVA 21 % affichée sur motedis.be) le sachet de 10 ; 4 sachets = 40 pièces pour 38. Plan Motedis : 28 x 27 x 27 mm, nez de rainure 6 visibles, trous 6,4 x 9,5. Page : « On Sale (Limited Stock) », stock à confirmer au panier. Vis et écrous non fournis (déjà dans la nomenclature). Commande Motedis « accessoires seuls » : port offert au-delà de 27,77 € HT. | 56.43 | 16.11 | Probable : même type (cornière 30 alu moulée, type I, rainure 6, avec nez), mais légèrement plus petite que la Dold du STEP (27 au lieu de 29,6 mm). Vérifier l'absence d'interférence avant de commander.
M00063 | Angle Bracket 60 B-Type Groove 8 | 46 | Motedis (motedis.be) | Angle 60x60 without lugs, sans nez, 4 trous oblongs 6,4 x 10 par aile + lumière centrale 9 mm (art. S6IBR60WL) | https://www.motedis.be/en/Angle-60x60-without-lugs | 24.20 | sachet de 10 | 5 | 121.00 | vérifié | 20,00 € HT / 24,20 € TTC (21 %) le sachet de 10 ; 5 sachets = 50 pièces, comme le chiffrage actuel (46 nécessaires). Plan Motedis : 58 x 57 x 57 mm, paroi 6 mm, trous 6,4 mm au pas de 30 mm. Compatible 60x60L, 30x60 et 45x60 Motedis rainure 6. Prix « local overstock » à quantité limitée : vérifier au panier qu'il couvre 50 pièces (sinon le prix normal peut être plus élevé). Matière non précisée (« metal »). | 148.95 | 27.95 | Équivalente : sans nez comme la Dold 67250. Trous oblongs M6 (6,4 mm) au lieu de Ø8,2 : le montage M6 + rondelle DIN9021 + écrou I M6 reste identique, et le pas de 30 mm tombe sur les rainures du 60x60 et du 30x60.
M00555 | I-Type Sliding Nut M5 | 168 | Motedis (motedis.be) | T-nut with spring ball, with guidance I-Type slot 6 [M5] (art. S6ISMONM5G) | https://www.motedis.be/en/T-nut-with-spring-ball-with-guidance-I-Type-slot-6-M5 | 22.85 | sachet de 100 | 2 | 45.70 | vérifié | 18,89 € HT / 22,85 € TTC (21 %) le sachet de 100 ; 2 sachets = 200 pièces pour 168. Acier zingué, bille inox, pivotant (à insérer par l'ouverture de la rainure). Stock à confirmer au panier. | 51.24 | 5.54 | Équivalente : écrou à pivoter avec bille ressort, type I rainure 6, comme le Dold 62361.
M00556 | I-Type Sliding Nut M6 | 368 | Motedis (motedis.be) | T-nut with spring ball, with guidance I-Type slot 6 [M6] (art. S6ISMONM6G) | https://www.motedis.be/en/T-nut-with-spring-ball-with-guidance-I-Type-slot-6-M6 | 22.85 | sachet de 100 | 4 | 91.40 | vérifié | 18,89 € HT / 22,85 € TTC (21 %) le sachet de 100 ; 4 sachets = 400 pièces pour 368. Plan Motedis : 17 x 10,5 mm, M6x1, hauteur 6,9 mm, acier zingué, bille inox. Stock à confirmer au panier. | 112.24 | 20.84 | Équivalente : mêmes dimensions que l'écrou Dold 62354 et que celui du STEP (10,5 x 17 mm), pivotant avec bille ressort.
PORT | Frais de port Motedis (accessoires ajoutés) |  | Motedis (motedis.be) | Commande « accessoires seuls » vers la Belgique | https://www.motedis.be/fr/cout-de-livraison:_:1.html | 0.00 | envoi | 1 | 0.00 | vérifié | Barème BE lu : accessoires seuls 6,33 € jusqu'à 27,77 €, gratuits au-delà. Motedis figure déjà au lot A (chaînes et pieds) : aucun surcoût. Attention : ajouter un profilé fait passer la commande au barème « Basis » (18,66 à 51,11 € HT, plus 4,44 € d'emballage et 4,44 € de surlongueur au-delà de 1150 mm, par tranche de 20 kg). | 0.00 | 0.00 | Sans objet
PORT | Frais de port Dold (lot A sans cornières 30/60 ni écrous M5/M6) |  | Dold Mechatronik (aluprofile-express.de) | Colis GLS jusqu'à 2 m, zone AT/FR/BeNeLux, tranche 60-90 kg au lieu de 90-120 kg | https://www.aluprofile-express.de/Versandinformationen | 89.90 | envoi | 1 | 89.90 | estimation | Barème lu : GLS ≤ 2 m, 89,90 € jusqu'à 90 kg, 109,90 € jusqu'à 120 kg. Le port Dold reste dû (profilés, écrous M4, cache-rainure, cornières 20). Poids estimé ~83 kg au lieu de ~92 kg : 78,7 kg de profilés, ~4 kg d'emballage, et ~9 kg retirés (50 cornières 60 à 0,11 kg, 38 cornières 30, 536 écrous). Marge faible sous 90 kg : à confirmer au panier, sinon le gain sur le port tombe à 0. | 109.90 | 20.00 | Sans objet
