wprod/fab-diy/cad/steel/vfd-cu/parts.csv

name | qty | kind | thickness_mm | flat_size_mm | assembly_path | files
VFD Enclosure Base v26 - Base | 1 | bent | 1.5 |  | Specific Parts > VFD Enclosure Base v26 | step/VFD_Enclosure_Base_v26_Base_t1.5mm_x1.step
VFD Enclosure Cover v5 - Cover | 1 | bent | 1.5 |  | Specific Parts > VFD Enclosure Cover v5 | step/VFD_Enclosure_Cover_v5_Cover_t1.5mm_x1.step
