wprod/fab-diy/bom/commandes/amazon-fr-optionnel-decoratif.csv

ref_mekanika | designation | produit | quantite_achat | prix_unitaire_ttc_eur | total_ttc_eur | confiance | lien | notes
M00407 | Coloured Washer M3 - Blue | Rondelle aluminium anodisé M3, assortiment multicolore (~100 pcs), part au prorata | 2 | 0.70 | 1.40 | estimation | https://www.amazon.fr/s?k=rondelle+aluminium+anodis%C3%A9+M3 | Introuvable chez TME et Motedis. Purement décoratif : assortiment ~7 € TTC réparti sur les 10 pièces. Prix non lu (Amazon non consultable) ; à défaut, rondelles DIN 125 M3 standard
M00408 | Coloured Washer M3 - Green | Rondelle aluminium anodisé M3, assortiment multicolore (~100 pcs), part au prorata | 3 | 0.70 | 2.10 | estimation | https://www.amazon.fr/s?k=rondelle+aluminium+anodis%C3%A9+M3 | Introuvable chez TME et Motedis. Purement décoratif : assortiment ~7 € TTC réparti sur les 10 pièces. Prix non lu (Amazon non consultable) ; à défaut, rondelles DIN 125 M3 standard
M00409 | Coloured Washer M3 - Red | Rondelle aluminium anodisé M3, assortiment multicolore (~100 pcs), part au prorata | 3 | 0.70 | 2.10 | estimation | https://www.amazon.fr/s?k=rondelle+aluminium+anodis%C3%A9+M3 | Introuvable chez TME et Motedis. Purement décoratif : assortiment ~7 € TTC réparti sur les 10 pièces. Prix non lu (Amazon non consultable) ; à défaut, rondelles DIN 125 M3 standard
M00410 | Coloured Washer M3 - Yellow | Rondelle aluminium anodisé M3, assortiment multicolore (~100 pcs), part au prorata | 2 | 0.70 | 1.40 | estimation | https://www.amazon.fr/s?k=rondelle+aluminium+anodis%C3%A9+M3 | Introuvable chez TME et Motedis. Purement décoratif : assortiment ~7 € TTC réparti sur les 10 pièces. Prix non lu (Amazon non consultable) ; à défaut, rondelles DIN 125 M3 standard
 | Frais de port Amazon.fr (rondelles colorées, optionnel) |  |  |  | 3.99 | estimation |  | Non vérifié : gratuit avec Prime ou dès 35 € d'achat éligible, sinon ~3-5 €. Ligne à supprimer si les rondelles colorées sont abandonnées ou remplacées
