wprod/fab-diy/cad/gabarits/FAB_Mounting_Gauge.dxf

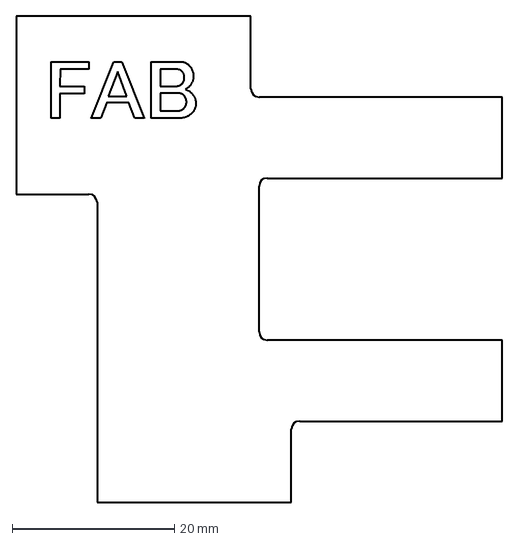
[picture p6: CAD file, 2026-11-10]
cad/gabarits/FAB_Mounting_Gauge.dxf
60.0 x 60.0 mm
