wprod/fab-diy/cad/steel/diy/CU_VFD_Mounting_plate_DIY_t3mm_x4.dxf

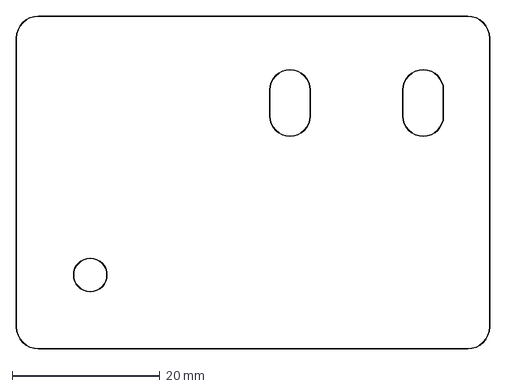
[picture p7: CAD file, 2026-11-14]
cad/steel/diy/CU_VFD_Mounting_plate_DIY_t3mm_x4.dxf
64.0 x 45.0 mm
