wprod/fab-diy/cad/steel/fab-cu/step/Fab_Control_Unit_Cover_v14_Cover_t1.5mm_x1.step

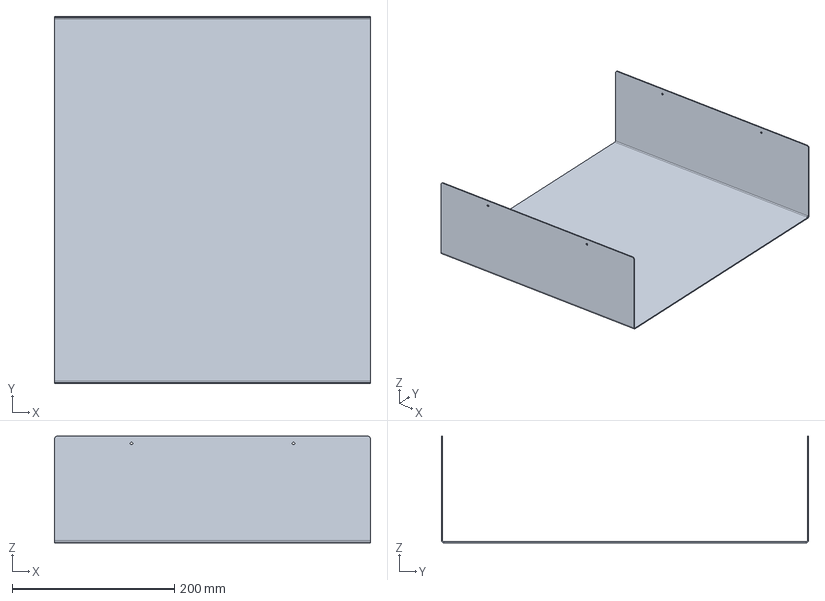
[picture p8: CAD file, 2026-11-08]
cad/steel/fab-cu/step/Fab_Control_Unit_Cover_v14_Cover_t1.5mm_x1.step
390.0 x 453.0 x 131.8 mm
