wprod/fab-diy/cad/steel/fab/step/Cable_chain_support_02_v4_Component1_t3mm_x4.step

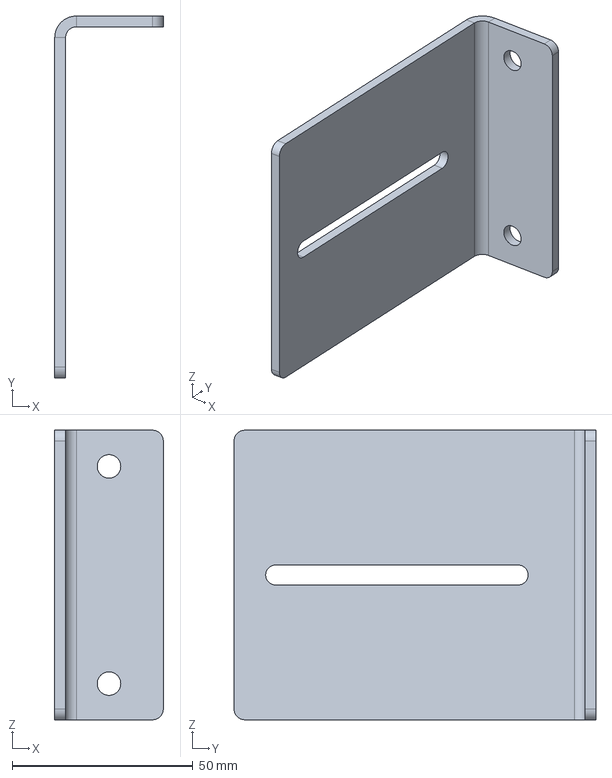
[picture p9: CAD file, 2026-11-08]
cad/steel/fab/step/Cable_chain_support_02_v4_Component1_t3mm_x4.step
30.0 x 100.0 x 80.0 mm
