wprod/fab-diy/cad/steel/vfd-cu/step/VFD_Enclosure_Base_v26_Base_t1.5mm_x1.step

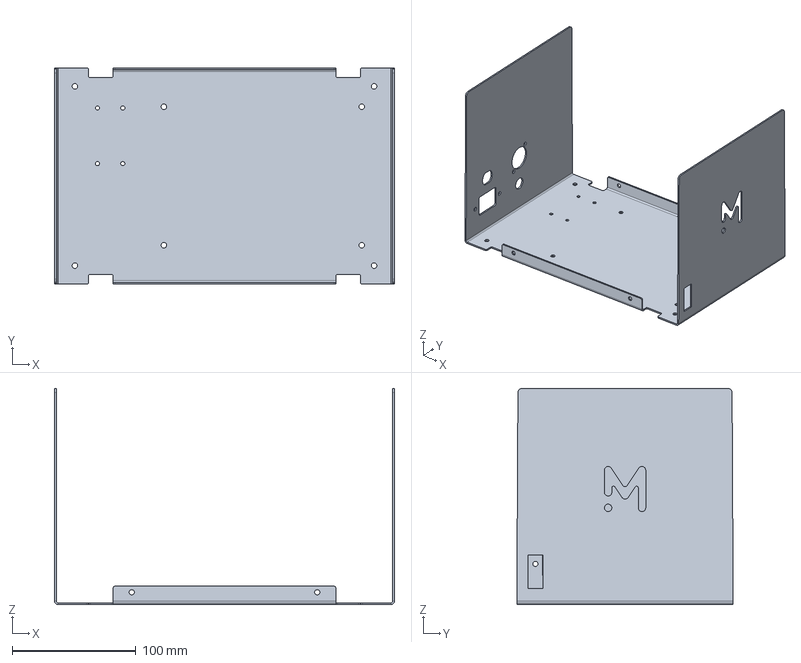
[picture p10: CAD file, 2026-11-08]
cad/steel/vfd-cu/step/VFD_Enclosure_Base_v26_Base_t1.5mm_x1.step
275.0 x 175.0 x 175.0 mm
