wprod/fab-diy/cad/steel/fab-cu/step/Fab_Control_Unit_Base_v50_Base_t1.5mm_x1.step

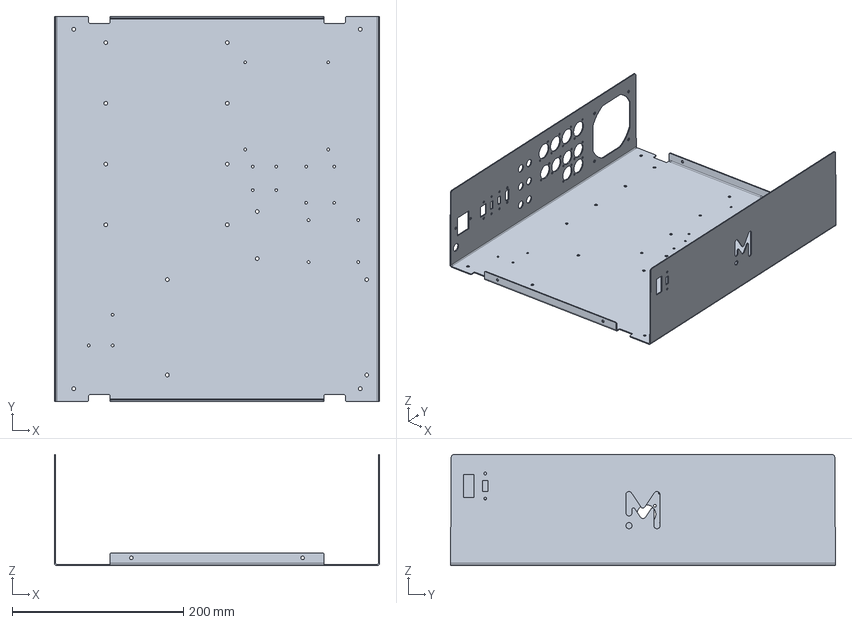
[picture p11: CAD file, 2026-11-08]
cad/steel/fab-cu/step/Fab_Control_Unit_Base_v50_Base_t1.5mm_x1.step
380.0 x 450.0 x 130.0 mm
