wprod/fab-diy/cad/steel/fab/step/Fab_XL_X_Bearing_blocks_nuts_v10_t8mm_x1.step

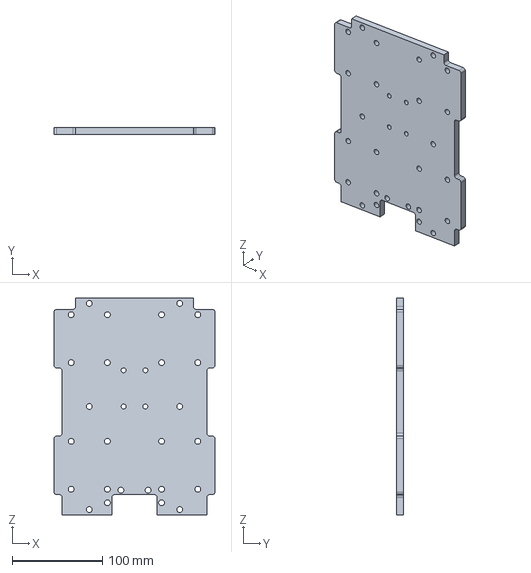
[picture p12: CAD file, 2026-11-08]
cad/steel/fab/step/Fab_XL_X_Bearing_blocks_nuts_v10_t8mm_x1.step
178.0 x 8.00 x 240.0 mm
