wprod/fab-diy/cad/steel/vfd-cu/step/VFD_Enclosure_Cover_v5_Cover_t1.5mm_x1.step

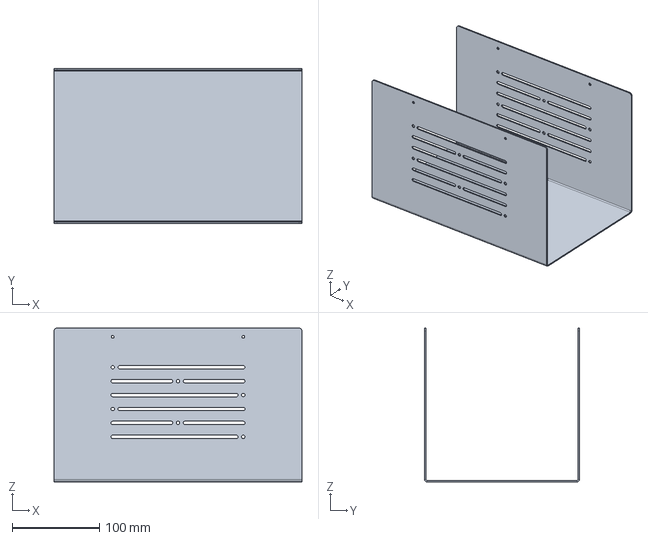
[picture p13: CAD file, 2026-11-08]
cad/steel/vfd-cu/step/VFD_Enclosure_Cover_v5_Cover_t1.5mm_x1.step
285.0 x 178.0 x 176.8 mm
