wprod/fab-diy/cad/steel/fab/step/Triangulation_v6_t8mm_x14.step

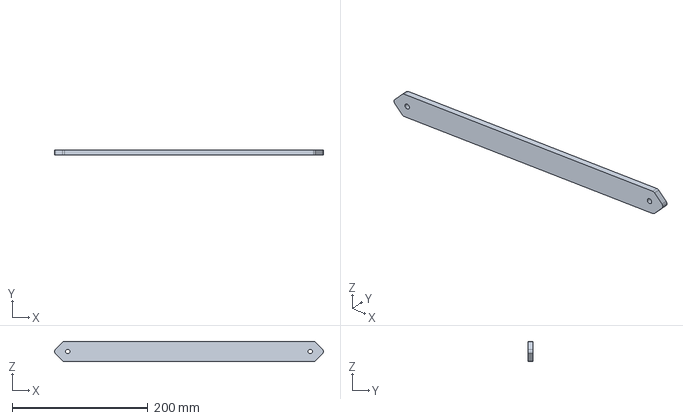
[picture p14: CAD file, 2026-11-08]
cad/steel/fab/step/Triangulation_v6_t8mm_x14.step
396.7 x 8.00 x 30.0 mm
