wprod/fab-diy/cad/steel/fab/step/Fab_XL_X_Motor_Z_v1_t8mm_x1.step

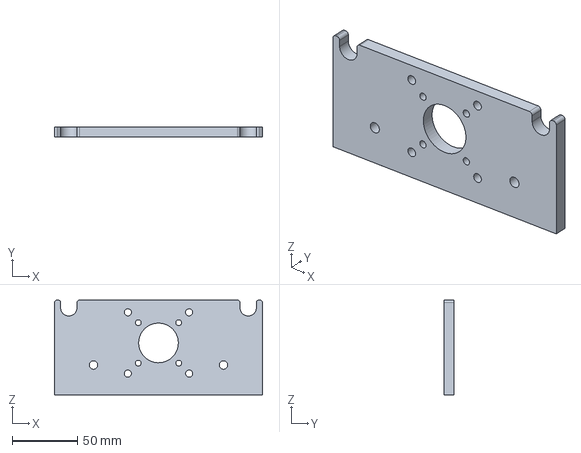
[picture p15: CAD file, 2026-11-08]
cad/steel/fab/step/Fab_XL_X_Motor_Z_v1_t8mm_x1.step
160.0 x 8.00 x 73.0 mm
