wprod/fab-diy/cad/steel/fab/step/Fab_XL_Z_plate_v4_t8mm_x1.step

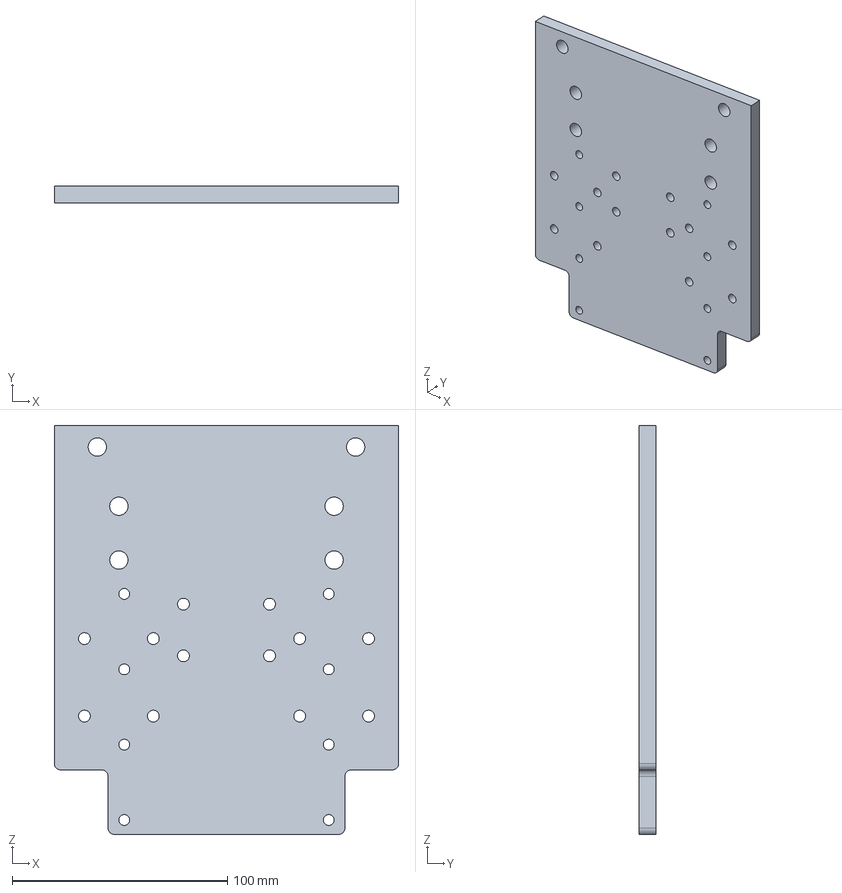
[picture p16: CAD file, 2026-11-08]
cad/steel/fab/step/Fab_XL_Z_plate_v4_t8mm_x1.step
160.0 x 8.00 x 190.0 mm
