wprod/fab-diy/cad/steel/fab/step/Foot_Plate_3060_M6_v2_t10mm_x6.step

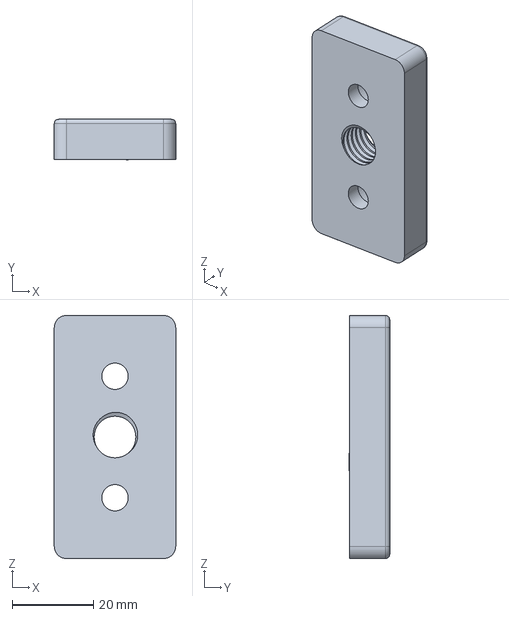
[picture p17: CAD file, 2026-11-08]
cad/steel/fab/step/Foot_Plate_3060_M6_v2_t10mm_x6.step
30.0 x 10.0 x 60.0 mm
