wprod/fab-diy/cad/steel/fab/step/Gantry_back_plate_v12_t8mm_x1.step

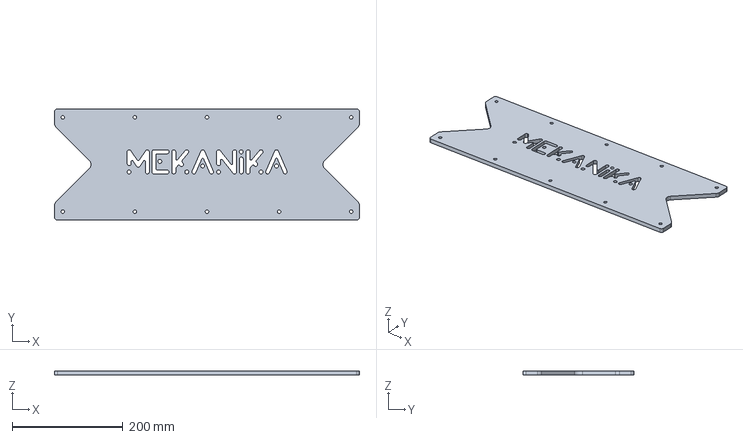
[picture p18: CAD file, 2026-11-08]
cad/steel/fab/step/Gantry_back_plate_v12_t8mm_x1.step
550.0 x 200.0 x 8.00 mm
