wprod/fab-diy/cad/steel/fab/step/Fab_XL_X_Bearing_Z_v1_t8mm_x1.step

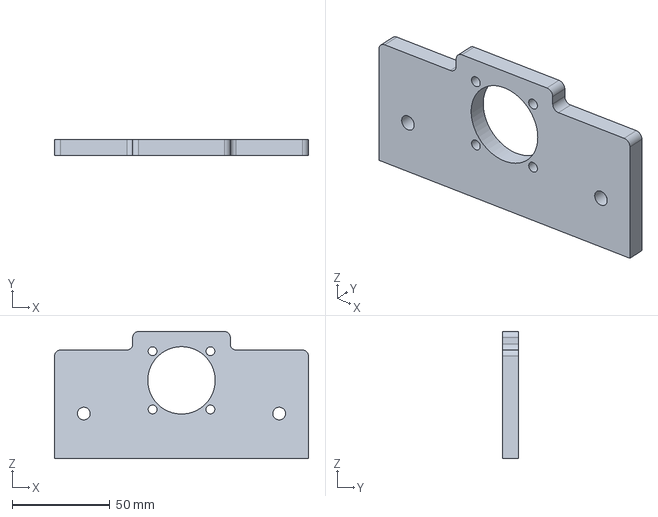
[picture p19: CAD file, 2026-11-08]
cad/steel/fab/step/Fab_XL_X_Bearing_Z_v1_t8mm_x1.step
130.0 x 8.00 x 65.0 mm
