wprod/fab-diy/cad/steel/fab/step/Spindle_plate_t8mm_x1.step

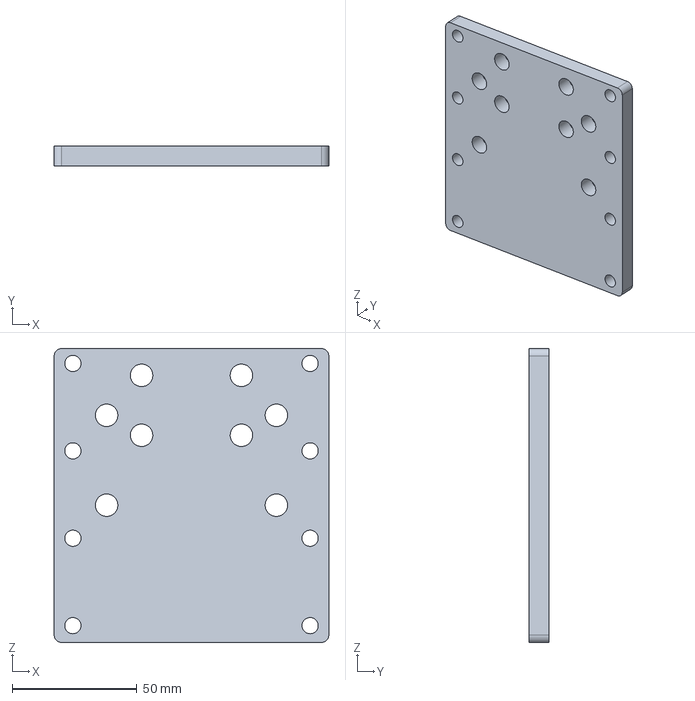
[picture p20: CAD file, 2026-11-08]
cad/steel/fab/step/Spindle_plate_t8mm_x1.step
110.0 x 8.00 x 117.7 mm
