wprod/fab-diy/cad/steel/fab/step/Bearing_Support_Offset_Plate_v7_t3mm_x2.step

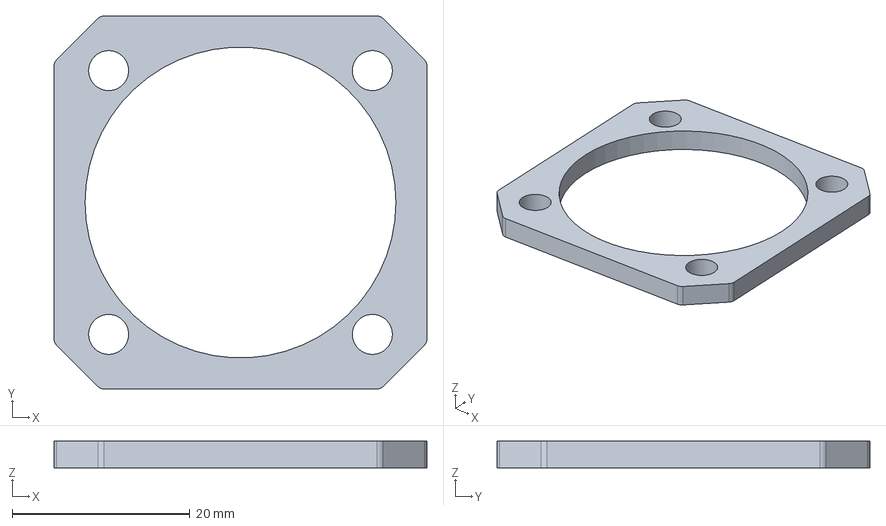
[picture p21: CAD file, 2026-11-08]
cad/steel/fab/step/Bearing_Support_Offset_Plate_v7_t3mm_x2.step
42.0 x 42.0 x 3.00 mm
