wprod/fab-diy/cad/steel/fab/step/Gantry_V2_v25_t10mm_x2.step

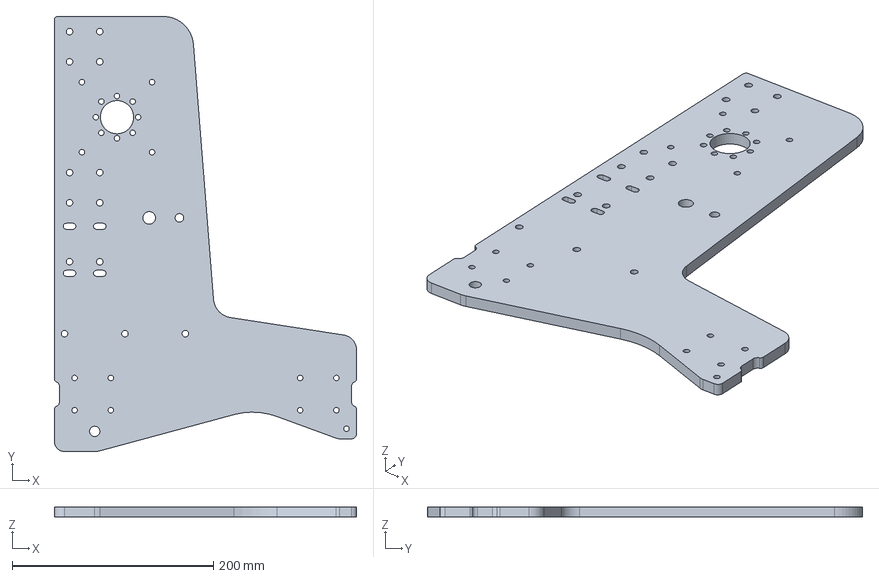
[picture p22: CAD file, 2026-11-08]
cad/steel/fab/step/Gantry_V2_v25_t10mm_x2.step
300.0 x 432.0 x 10.0 mm
