wprod/fab-diy/cad/steel/fab/step/Rack_Pinion_drive_plate_04_v21_t8mm_x2.step

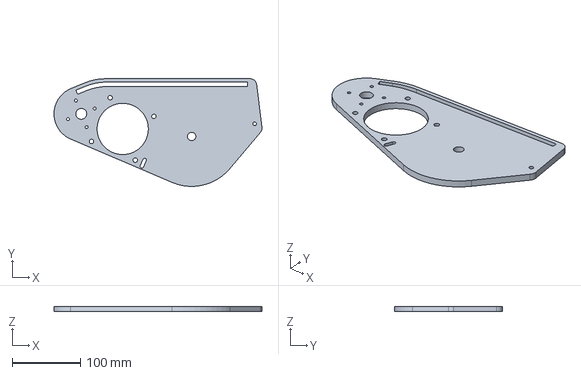
[picture p23: CAD file, 2026-11-08]
cad/steel/fab/step/Rack_Pinion_drive_plate_04_v21_t8mm_x2.step
304.4 x 157.6 x 8.00 mm
