wprod/fab-diy/cad/steel/fab/step/Limit_switches_support_02_v15_t8mm_x4.step

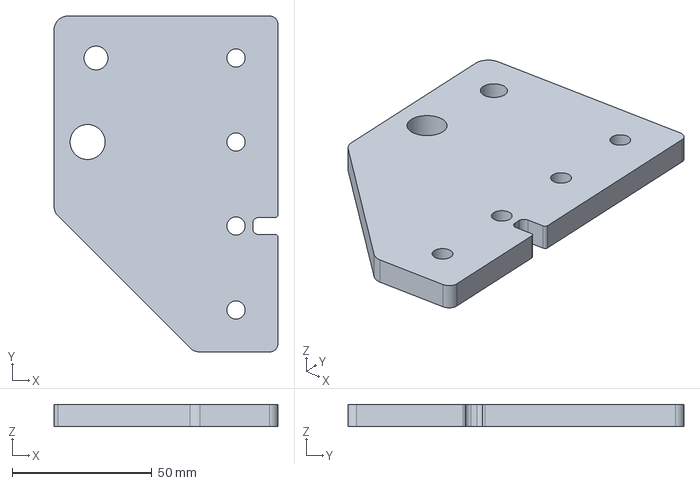
[picture p24: CAD file, 2026-11-08]
cad/steel/fab/step/Limit_switches_support_02_v15_t8mm_x4.step
80.0 x 120.0 x 8.00 mm
