wprod/fab-diy/(list of files, cad)

Other CAD files:
cad/steel/fab/dxf/Bearing_Support_Offset_Plate_v7_t3mm_x2.dxf
cad/steel/fab/dxf/Fab_XL_X_Bearing_Z_v1_t8mm_x1.dxf
cad/steel/fab/dxf/Fab_XL_X_Bearing_blocks_nuts_v10_t8mm_x1.dxf
cad/steel/fab/dxf/Fab_XL_X_Motor_Z_v1_t8mm_x1.dxf
cad/steel/fab/dxf/Fab_XL_Z_plate_v4_t8mm_x1.dxf
cad/steel/fab/dxf/Foot_Plate_3060_M6_v2_t10mm_x6.dxf
cad/steel/fab/dxf/Gantry_V2_v25_t10mm_x2.dxf
cad/steel/fab/dxf/Gantry_back_plate_v12_t8mm_x1.dxf
cad/steel/fab/dxf/Limit_switches_support_02_v15_t8mm_x4.dxf
cad/steel/fab/dxf/Nut_Offset_bracket_v2_t8mm_x2.dxf
cad/steel/fab/dxf/Rack_Pinion_drive_plate_04_v21_t8mm_x2.dxf
cad/steel/fab/dxf/Spindle_plate_t8mm_x1.dxf
cad/steel/fab/dxf/Triangulation_v6_t8mm_x14.dxf
cad/steel/fab/step/Nut_Offset_bracket_v2_t8mm_x2.step
