wprod/fab-diy/(commit log)

2026-11-08 Fab DIY : clone de la Mekanika Fab, BOM chiffrée pour la France
    - Pièces acier extraites du STEP officiel (DXF + STEP, cad/steel)
    - BOM aplatie et chiffrée par lots (bom/chiffrage), ~7 230 € TTC livrée en France
    - Moteurs en boucle fermée, PlanetCNC Mk3/4, arrêt d'urgence câblé
    - Vérifications (rainures, crémaillères) et synthèse budgétaire (docs/)
    [Bearing_Support_Offset_Plate_v7_t3mm_x2.dxf, Bearing_Support_Offset_Plate_v7_t3mm_x2.step, Cable_chain_support_02_v4_Component1_t3mm_x4.step, Fab_Control_Unit_Base_v50_Base_t1.5mm_x1.step, Fab_Control_Unit_Cover_v14_Cover_t1.5mm_x1.step, Fab_XL_X_Bearing_Z_v1_t8mm_x1.dxf, Fab_XL_X_Bearing_Z_v1_t8mm_x1.step, Fab_XL_X_Bearing_blocks_nuts_v10_t8mm_x1.dxf]
2026-11-10 Écarts levés dans le STEP : 14 goussets, 11 profilés 30×60, axe Y en tronçons
    - verifications.md : construction de l'axe Y (2 × 1530 mm par côté), positions
    des 14 goussets et des 11 profilés 30×60 de 1410 mm
    - BOM : M00059 chiffré pour 11 pièces (+62 €), total ~7 290 € TTC
    - profiles-coupe.md : fiche de coupe et de taraudage pour le devis
    - cad/gabarits : gabarit de montage officiel (DXF)
    Claude-Session: https://claude.ai/code/session_01FwK9mfrBbJ8mfnDbu7yRaF
    [FAB_Mounting_Gauge.dxf, fab-diy-bom.csv, lot-A.csv]
2026-11-10 Carte des fins de course : schéma décodé, Gerber générés, BOM corrigée
    - scripts/make_limits_pcb.py : carte passive 99,5 × 51 mm (6 XLR3, 2 borniers),
    dessinée d'après PCB-limits.qet et les perçages de la tôle du boîtier,
    avec contrôle des isolements et de la continuité
    - cad/pcb-fins-de-course : Gerber, perçage, zip, aperçu
    - docs/carte-fins-de-course.md : brochage, câblage vers l'optocoupleur et
    PlanetCNC, points à vérifier avant fabrication
    - BOM : embases NC3FAV au lieu de NC3FAV1-0 (broche 1 au châssis),
    optocoupleur en version 24 V
    Claude-Session: https://claude.ai/code/session_01FwK9mfrBbJ8mfnDbu7yR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
    [fab-diy-bom.csv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]
2026-11-10 Pattes des boîtiers (M01379) redessinées d'après les cotes des STEP
    - scripts/make_cu_bracket.py : patte 64 × 45 × 3 mm (1 trou M4, 2 lumières M5),
    avec contrôle des cotes et plan de pose
    - cad/steel/diy : DXF et plan de pose
    - docs/pieces-acier.md : les deux traverses basses avant (entraxe 288 mm)
    calent les pieds du boîtier de commande par l'extérieur et ceux du VFD
    par l'intérieur ; une seule patte sert aux deux
    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
    [CU_VFD_Mounting_plate_DIY_t3mm_x4.dxf, fab-diy-bom.csv, lot-D.csv]
2026-11-10 Boîtier de commande, vis X et poulie Y vérifiés dans les STEP
    - docs/boitier-commande.md : implantation du CL57T, de l'alimentation 48 V,
    du contacteur et du relais dans le boîtier d'origine, sans modifier les tôles
    - verifications.md : la vis à billes X doit faire 1500 mm (une 1450 n'atteint
    pas le palier libre) ; la poulie Y est une HTD-5M de 80 dents
    - budget.md et README : points 3, 4 et 11 mis à jour
    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
2026-11-10 Plan de câblage : schémas officiels relevés, modifications et décisions
    - docs/plan-cablage.md : câblage d'origine lu dans Control Unit FAB.qet et
    VFD unit.qet (secteur, drivers, moteurs, fins de course, GX12), puis chaîne
    de puissance, boucle fermée et Makita de cette version
    - signale que la bobine 230 V du contacteur mettrait le secteur sur le câble
    de l'arrêt d'urgence, et que le palpeur d'origine est alimenté en 5 V
    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
2026-11-10 Choix de câblage : bobine 24 V, Makita dans le boîtier de commande
    - lot K : contacteur à bobine 24 V CC (le câble de l'arrêt d'urgence reste en
    très basse tension), relais et prise de la Makita dans le boîtier de
    commande, boîtier VFD reporté, câble d'arrêt d'urgence et presse-étoupes
    - plan-cablage.md : boucle d'arrêt d'urgence et de marche, choix expliqués
    - budget, boîtier de commande, pièces acier et README mis à jour (≈ 7 230 €)
    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
    [fab-diy-bom.csv, lot-K-cablage.csv]
2026-11-14 Dossier de devis laser et fiche d'usinage du pignon-poulie
    - scripts/make_laser_quote.py : liste des 17 références (48 pièces) et zip
    des fichiers rangés par épaisseur, dans cad/steel/devis
    - docs/devis-decoupe.md : contenu du dossier et message type
    - docs/pignon-poulie.md : cotes relevées dans le STEP (pignon M2 Z15, poulie
    HTD-5M 80 dents, logements de roulements), écart de roulement avec la
    nomenclature
    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
    [liste-decoupe.csv]
2026-11-14 Devis laser : nombre de références pliées corrigé
    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
2026-11-14 Plan d'action, listes de commande par fournisseur, contrôle de la visserie
    - docs/plan-d-action.md : vérifications, devis et commandes dans l'ordre
    - scripts/make_orders.py et bom/commandes : une liste par fournisseur
    - verifications.md : la visserie de la nomenclature couvre le modèle 3D
    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
    [achat-local-bricolage-grossiste-electrique.csv, aliexpress-amazon.csv, aliexpress-vendeur-entrepot-ue-si-dispo.csv, aliexpress.csv, amazon-fr-optionnel-decoratif.csv, audiophonics-bordeaux.csv, bits-and-parts-bitsandparts-nl.csv, damencnc-2-2-m-dold-2-1-m.csv]
2026-11-14 Plan d'action : les vis à billes sont chez AliExpress, pas chez Dold
    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
2026-11-14 Plan d'action : précise le contenu de la commande AliExpress
    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
2026-11-14 Guide officiel consulté : 11 profilés et 14 goussets confirmés, boîtiers posés à plat
    - verifications.md, section 9 : ce que confirme le guide de montage, et les
    deux versions du châssis (ce dépôt suit l'ancienne, celle du modèle 3D)
    - pieces-acier.md : le boîtier se pose sur les deux traverses basses avant,
    sans patte ; la patte redessinée devient facultative (hors BOM et devis)
    - budget, plan d'action, fiche de coupe, câblage : points levés
    - total ≈ 7 220 € TTC, dossier laser à 16 références et 44 pièces
    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
    [decoupe-laser-en-ligne-laserboost-fractory-xometry-devis-a-f.csv, fab-diy-bom.csv, liste-decoupe.csv, lot-K-cablage.csv]
2026-11-14 Guide officiel lu en entier : notes de montage, gabarits, pignon v2, chaîne Y
    - docs/notes-de-montage.md : écarts avec le guide pour cette machine,
    gabarits à faire soi-même (cotes relevées dans le STEP), ordre d'empilage
    du pignon, points relevés au fil des chapitres
    - pignon-poulie.md : deux versions de la pièce ; alésages de la v2 déduits
    de l'empilage décrit dans le guide
    - lot K : gabarits MDF et contreplaqué remplacés par des chutes et une
    mesure, 4e sachet de chaîne (chaîne Y de 1900 mm) ; total ≈ 7 210 €
    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
    [decoupe-laser-bois-acrylique-en-ligne-snijlab-nl-formulor-de.csv, fab-diy-bom.csv, lot-K-cablage.csv, motedis.csv]
2026-11-14 Réglages PlanetCNC : profil officiel résumé, attribution des axes confirmée
    - docs/reglages-planetcnc.md : sorties moteur (Axis 1 = X, 2 = Y1, 3 = Z,
    4 = Y2), pas par mm (drivers à 6400 impulsions par tour), vitesses,
    courses, entrées et sorties, prise d'origine, adaptations pour cette
    version et ordre du premier essai
    - plan de câblage, plan d'action, budget : dernier point ouvert levé
    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
2026-11-14 Logiciel sur Pi 5 et matériel à prévoir hors BOM
    - reglages-planetcnc.md : l'image Mekanika vise le Pi 4B ; deux voies
    d'installation pour le Pi 5
    - plan-d-action.md : écran, clavier, fraises, brides et aspiration ne sont
    pas dans la BOM
    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
2026-11-14 Sorties régénérables à l'identique, README complété
    - make_laser_quote.py, make_limits_pcb.py : zips à date fixe
    - make_cu_bracket.py : le DXF n'est réécrit que si son contenu change
    - README : étape 5 de la régénération, points ouverts mis à jour
    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
    [CU_VFD_Mounting_plate_DIY_t3mm_x4.dxf]
